manszabi/bazsi-router-reboot/bazsi_router_reboot.ino

#include <Arduino.h>
#include <WiFi.h>
// A HTTP kliens, az ICMP ping es a webszerver mar a moduloke (netprobe,
// webportal) - a fomodul nem hivja oket kozvetlenul. Az Arduino a KONYVTARAKAT
// tovabbra is megtalalja: a sketch mappa MINDEN fajljanak includejait vegignezi,
// es ezek a modulokban ott allnak.
#include <string.h>
#include "LittleFS.h"
#include "esp_sleep.h"
#include "esp_idf_version.h"
#include "esp_task_wdt.h"
#include "esp_system.h"
#include "esp_attr.h"
// Az esp_timer_get_time()-ot a core is expliciten includeolja (esp32-hal-misc.c),
// nem hagyatkozik a FreeRTOS fejlecek atteteles behuzasara. Mi sem tesszuk.
#include "esp_timer.h"
#include <time.h>
// A rele labanak rogzitese deep sleep idejere: gpio_hold_en() +
// gpio_deep_sleep_hold_en(). A C3-on a digitalis padek (GPIO6-21) holdjat csak
// ez a paros tartja meg alvas alatt (driver/gpio.h, a gpio_hold_en 3. megj.).
#include "driver/gpio.h"

// A sajat modulok. Amit ezek a headerek nem hirdetnek meg, az a modulokon
// kivulrol nem elerheto - ezt mar a fordito kenyszeriti ki, nem a fegyelem.
#include "limits_config.h"
#include "sync.h"
#include "eventlog.h"
#include "configstore.h"
#include "webportal.h"
#include "strutil.h"
#include "secret.h"
#include "app_hooks.h"
#include "netprobe.h"


// Az IPAddress a core 3.x-ben ~28 bájt (16 bájtos unió + típus + zóna + vptr),
// ezért egyik sem globális: mind ott jön létre, ahol használjuk.

// Strapping labak a C3-on: GPIO2, GPIO8, GPIO9 (datasheet, Boot Configurations).
// Set LED GPIO, relay state
constexpr uint8_t ledPin = D4;
// wifi ok led
constexpr uint8_t wifiledPin = D3;
// Set RELAY pin, to router
//
// HARDVER: D10 = GPIO10, KULSO 22k LEHUZO ELLENALLASSAL a GND fele.
// A korabbi D5 = GPIO7 bekotes nem volt stabil. Amit a D10 ad:
//   - nem strapping lab (a C3-on GPIO2, GPIO8, GPIO9 az), tehat a reset
//     alatti szintje a bootot nem befolyasolja;
//   - tovabbra is a digitalis pad tartomanyban (GPIO6-21) van, igy az alvas
//     alatti rogziteshez ugyanaz a gpio_hold_en() + gpio_deep_sleep_hold_en()
//     paros kell, mint eddig (lasd holdRelayForSleep()).
// A 22k lehuzo NEM elhagyhato: a hold a bekapcsolas es a program indulasa
// kozti ablakban meg nem el, addig a pad nagyimpedanciasan lebegne.
constexpr uint8_t relayPin = D10;
// Set reset pin, esp wifireset pin
//
// FIGYELEM (hardver): a D0 = GPIO2 strapping lab! A chip-reset alatti
// mintavetelnel GPIO2=1 kell mind az SPI boothoz, mind a letoltesi modhoz -
// bekapcsolas/reset KOZBEN nyomva tartott (vagy beragadt) wifireset gombnal
// az eszkoz el sem indul. Ez ellen szoftver nem vedhet: a handleStuckButton()
// csak a mar elindult programbol mukodik, es a beragadt gomb 60 mp-es
// alvas-ebredes kore is chip-resettel ebred, azaz ujra a lenyomott gombot
// mintavetelezne. Uj hardver reviziora a gombot szabad, nem-strapping labra
// erdemes tenni (pl. D2 = GPIO4, ami raadasul RTC-kepes is); a jelenlegi
// bekotesnel a szabaly annyi: bekapcsolas kozben ne legyen nyomva.
constexpr uint8_t wifiresetPin = D0;
// Set reset pin, esp reset/wakeup pin
constexpr uint8_t resetPin = D1;

// Timer variables
// Egy csatlakozasi proba felso hatarideje. A nev korabban egyszeruen
// "interval" volt - a program legtobbet mondo nevu konstansai kozott
// (RESET_DELAY, PROBE_DELAY, ONLINE_PROBE_INTERVAL_MS...) ez semmit nem mondott,
// pedig a fajlban KULON KOMMENT figyelmeztet arra, hogy az "interval"-szeru
// neveket konnyu osszekeverni.
constexpr uint32_t WIFI_CONNECT_TIMEOUT_MS = 20 * 1000;
constexpr uint32_t SUCCESS_DELAY = 1 * 60 * 1000;
// Szünet KÉT BUKOTT internetteszt között (az eszkaláció üteme). Ne keverd az
// ONLINE_PROBE_INTERVAL_MS-sel: az a hosszú VÁRAKOZÁSOK korai lezárásának
// üteme, és teljesen más állapotokban fut.
constexpr uint32_t PROBE_DELAY = 12 * 1000;
constexpr uint32_t RESET_DELAY = 10 * 60 * 1000;
constexpr uint32_t RESET_PULSE = 90 * 1000;
constexpr uint32_t firstStartDelay = 10 * 60 * 1000;
// A reset ESEMÉNY számláló határa. A számláló még a reset ELŐTT nő, ezért
// 4 tényleges router újraindítás után következik az egy órás alvás.
constexpr uint8_t maxfailureEvents = 5;
// Egységes Wi-Fi újrapróbálkozási politika MINDEN ágon: 3 próba, köztük 30 mp.
constexpr uint8_t wifi_maxRetries = 3;
constexpr uint32_t wifiInterval = 30 * 1000;
// (Az AP beallito mod tetlensegi ideje - AP_TIMEOUT_MS - a webportal.h-ban
// all, a portal tobbi parameterevel egyutt.)

// Meddig próbálkozzunk, ha a hálózat egyszerűen nincs ott? Egy kör:
//    10,0 perc  firstStartDelay várakozás
//   + 2,0 perc  3 csatlakozási próba (3 x 20 mp timeout + 2 x 30 mp szünet)
//   + 1,5 perc  router áramtalanítás (RESET_PULSE)
//  + 10,0 perc  várakozás a router bootolására (RESET_DELAY)
//   + 2,0 perc  újabb 3 csatlakozási próba
//  + 60,0 perc  deep sleep
//  = 85,5 perc  (de csak akkor, ha a kör alvással ZÁRUL)
// Az UTOLSO kör nem alszik: a wifiGiveUp() előbb növel, aztán ellenőriz, tehát
// a 33.-nál már AP módba megy. A tényleges türelem ezért
//   33 x 25,5 + 32 x 60 = 2761,5 perc = 46,0 óra,
// nem 33 x 85,5. Két napon belül marad, sőt tartalékkal: 34 kör is csak
// 47,5 óra lenne. Ha ennyi idő alatt sem jön vissza a net, az már nem az
// eszköz dolga. Mérve: R8.
constexpr uint32_t MAX_RETRY_ROUNDS = 33;
constexpr uint32_t BUTTON_DEBOUNCE_MS = 50;
// Gombok mintavételi köze. 10 ms bőven elég az 50 ms-os debounce-hoz, viszont
// delay()-jel várunk, nem yield()-del, így a CPU nem pörög üresen.
constexpr uint32_t BUTTON_POLL_MS = 10;
// Végzetes hiba jelzése: mindkét LED együtt, gyorsan villog (5 Hz).
constexpr uint32_t FATAL_BLINK_MS = 100;
// Ennyi hibajelzés után az ESP elalszik. Időzített ébresztés NÉLKÜL: csak a
// reset gomb vagy az áramtalanítás hozza vissza.
constexpr uint32_t FATAL_SLEEP_AFTER_MS = 5 * 60 * 1000;
// Beragadt gomb jelzése elalvás előtt: a két LED FELVÁLTVA villog, hogy meg
// lehessen különböztetni a végzetes hibától, ahol EGYÜTT villognak.
constexpr uint32_t STUCK_BLINK_MS = 3000;
// AP beállító mód: a Wi-Fi LED villog 1 Hz-cel, a státusz LED végig VILÁGÍT.
// Lassabb a végzetes hiba 5 Hz-énél, hogy össze ne lehessen téveszteni vele.
constexpr uint32_t AP_BLINK_MS = 500;
// Router reset pulzus: a státusz LED villog 2 Hz-cel, a Wi-Fi LED KI marad
// (a router áram nélkül van, kapcsolat sincs). A két villogó jelzés így a
// villogó LED-ről és a sebességről is megkülönböztethető.
constexpr uint32_t RESET_BLINK_MS = 250;
// Watchdog timeout. Nagyobb kell, mint a leghosszabb olyan blokkolás, amit NEM
// tudunk etetni - ez a http.GET(). A rossz eset NEM a szerver hallgatasa
// (5 mp connect + 10 mp valasz = 15 mp), hanem a HALOTT DNS, mert a
// nevfeloldas a connect timeouton KIVUL esik:
//   NetworkClient::connect(host,...) eloszor Network.hostByName()-t hiv, es
//   annak nincs timeout parametere (NetworkClient.cpp:310-315).
//   Egy lwIP DNS lekerdezes szervereenkent ~7 mp alatt adja fel
//   (DNS_MAX_RETRIES=4, DNS_TMR_INTERVAL=1000 ms, a tmr 1,1,2,3 lepesekben nő
//   -> 7 tick), DHCP-tol jellemzoen 2 szerver jon.
//   Ha van globalis IPv6 cim, a hostByName KETSZER kerdez (eloszor csak
//   AF_INET6-ot, aztan AF_UNSPEC-et; NetworkManager.cpp) -> 2 x 14 mp.
//   A lwip_getaddrinfo hibaja pozitiv EAI_* kod (netdb.h: 200-210), amit a
//   NetworkClient::connect igazkent lat, ezert meg egy 0.0.0.0-ra iranyulo
//   connect is lefut a maga 5 mp-evel.
// Realis legrosszabb eset: 2 x (2 x 7) + 5 = 33 mp. A 90 mp igy ~2,7-szeres
// tartalekot ad. (Meresi keretben: WD13.)
constexpr uint32_t WDT_TIMEOUT_MS = 90 * 1000;
// Ennyi watchdog/panic miatti újraindulás után az eszközt instabilnak
// tekintjük, és ugyanúgy leállunk, mint a többi végzetes hibánál.
constexpr uint32_t MAX_WDT_RESETS = 3;
// Ennyi ideig tartó hibátlan működés után a számláló nullázódik.
constexpr uint32_t WDT_COUNTER_CLEAR_MS = 60 * 60 * 1000;

constexpr uint64_t SLEEP_DURATION_US = 3600ULL * 1000000ULL;      // 1 óra
constexpr uint64_t STUCK_BUTTON_SLEEP_US = 60ULL * 1000000ULL;    // 60 másodperc

// Ennyi ideig várunk a beragadtnak látszó gomb ELENGEDÉSÉRE, mielőtt tényleg
// beragadásnak minősítenénk.
//
// MIÉRT KELL EZ? A reset gomb LOW SZINTRE ébreszt az alvásból, tehát a
// felhasználó szükségképpen MÉG NYOMVA TARTJA, amikor az eszköz bootolni kezd.
// Minden gombos ébredés ilyen. Ha a setup() egyetlen pillanatnyi digitalRead()
// alapján döntene, egy teljesen normális, fél-egy másodperces gombnyomás
// "beragadásnak" minősülne, és az eszköz azonnal visszaaludna 60 mp-re - a
// felhasználó szemszögéből "a gomb nem csinál semmit", pedig épp ő nyomta meg.
//
// Mérve (SH3): a döntés régen a Serial.begin() utáni várakozás hosszától
// függött, ami viszont attól, hogy VAN-E USB GAZDA. Bedugott USB-vel a határ
// ~600 ms volt (egy szándékos gombnyomás bőven fölé megy), USB nélkül ~3,5 mp.
// Vagyis ugyanaz a gombnyomás máshogy sült el aszerint, hogy be van-e dugva a
// kábel. Ez a konstans a küszöböt kimondottá és a kábeltől függetlenné teszi.
//
// A hosszát nem kell finomhangolni: egy TÉNYLEG beragadt gomb sosem enged el,
// tehát a 3 mp csak annyit késleltet, ami után úgyis a 60 mp-es alvás jön.
constexpr uint32_t STUCK_BUTTON_CONFIRM_MS = 3000;


// --- Heap felugyelet -------------------------------------------------------
//
// MIERT KELL? A sketch SAJAT KODJA nem allokal dinamikusan (a make lint ezt ki
// is kenyszeriti), a heapet viszont az ESPAsyncWebServer / AsyncTCP /
// HTTPClient / Wi-Fi driver erdemben hasznalja. Es a hataron sincs nulla: par
// konyvtari hivas, amit MI teszunk, String-et ad vissza ertek szerint
// (http.begin, http.header, WiFi.SSID) - rovid eletu, de valos foglalasok. Egy lassu
// szivargas vagy elaprozodas honapokig eszrevetlen marad, aztan egy nap az
// eszkoz "csak ugy" nem mukodik - allokacios hiba eseten a legtobb konyvtar
// csendben elbukik, nem panikol. Ezert merunk, kiirunk, es vegso esetben
// magunktol ujraindulunk, MIELOTT barmi elromlana.
constexpr uint32_t HEAP_CHECK_INTERVAL_MS = 10 * 1000;        // mintaveteli koz
constexpr uint32_t HEAP_LOG_INTERVAL_MS   = 30 * 60 * 1000;   // rendszeres sor

// A KET KUSZOB. A C3-on Wi-Fi + webszerver mellett a tipikus szabad heap
// 120-200 KB. A Wi-Fi driver es az AsyncTCP egyszerre tobb KB-os tomboket is
// ker, ezert nem a nulla a veszelyes hatar, hanem az a szint, ahol egy
// szokasos foglalas mar elbukhat.
constexpr uint32_t HEAP_WARN_BYTES  = 25000;   // figyelmeztetes (naplo + soros)
constexpr uint32_t HEAP_CRIT_BYTES  = 12000;   // ujrainditas

// ELAPROZODAS. Lehet 30 KB szabad heap ugy, hogy a legnagyobb OSSZEFUGGO tomb
// csak 4 KB - ilyenkor a szabad heap onmagaban megnyugtato, kozben a
// foglalasok mar buknak. Ezert a legnagyobb tombot kulon is nezzuk.
constexpr uint32_t HEAP_CRIT_BLOCK_BYTES = 6000;

// A kritikus szintnek KI KELL TARTANIA. Egy pillanatnyi melypont (egy epp
// futo HTTP keres, egy nagyobb valasz osszeallitasa) nem szivargas. Harom
// egymas utani minta = 30 masodperc.
constexpr uint8_t HEAP_CRIT_SAMPLES = 3;

// Es a heap miatti ujrainditasnak is van felso hatara: ha az ujraindulas sem
// segit (tartos elaprozodas, valodi szivargas mar indulaskor), a boot loop
// rosszabb, mint a megallas. Ugyanaz a politika, mint a watchdognal.
constexpr uint32_t MAX_HEAP_RESTARTS = 3;

// A hosszú várakozások (firstStartDelay, RESET_DELAY) korai lezárása.
//
// Mindkét várakozás arra való, hogy a router bootolására időt hagyjunk - de ha
// a router hamarabb feláll, felesleges a maradékot kivárni. Ennyi időnként
// megnézzük, hogy visszajött-e a hálózat ÉS az internet; ha mindkettő megvan,
// a várakozás azonnal véget ér. A próba ISMÉTLŐDIK, tehát elég, ha a kapcsolat
// a várakozás BÁRMELY pontján helyreáll: a kilépés az azt követő ütemben
// megtörténik. A teljes időt csak akkor várjuk ki, ha végig nincs meg.
//
// MIÉRT 60 mp? Egy router bootolása 1-3 perc, tehát ennél sűrűbb kérdezés nem
// hozna érdemben korábbi kilépést, viszont rádiózna. Egy 10 perces várakozás
// alatt így legfeljebb 10 próba fut - és mivel a Wi-Fi újracsatlakozás a
// WiFi.persistent(false) mellett NEM ír NVS-t, ez a flasht sem terheli.
constexpr uint32_t ONLINE_PROBE_INTERVAL_MS = 60 * 1000;
// A korai kilépés ping célpontja: fix IP, hogy a névfeloldás ne számítson -
// itt csak azt kérdezzük, van-e út kifelé. (Cloudflare.) Az IPAddress ~28
// bájt és virtuális, ezért itt csak a négy oktett él, a cím a hívás helyén
// jön létre.
constexpr uint8_t PROBE_PING_IP[4] = { 1, 1, 1, 1 };

// A teszt parameterek (PING_*, HTTP_*) a netprobe.h-ban allnak, a
// mereseikkel egy helyen.
// A legmagasabb letezo ciklus index: ot vegpont van, 0..4. A FAILURE_STATE
// mar 4-nel resetel, tehat a plafon a gyakorlatban nem is kot - de ez az a
// szam, ameddig az indexnek egyaltalan ertelme van, es a leptetes ezt mondja ki.
constexpr uint8_t MAX_CYCLE_INDEX = 4;

// AZ OT TESZT-VEGPONT, INDEX SZERINT.
//
// MIERT TABLAZAT, ES NEM if-lanc? Ket okbol:
//
//  1. A 0-s index az if-lancban az ELSE agra esett, tehat a lista "elso" eleme
//     a szerkezet VEGEN allt. A tablazat ugyanabban a sorrendben olvashato,
//     mint amit a soros port es a /log oldal 1-alapon szamoz.
//
//  2. SEMMI nem kotote ossze a vegpontok SZAMAT a MAX_CYCLE_INDEX-szel. Ha
//     valaki a plafont 5-re emelne, az if-lanc az 5-os indexnel CSENDBEN
//     ujra a msftconnecttest-et probalta volna (az else ag) - vagyis egy
//     uzemelteto ketszer szerepelt volna, es epp az a garancia veszett volna
//     el, amiert ot kulonbozo vegpont van: "egyetlen uzemelteto kiesese soha
//     ne latszodjon internetkimaradasnak". A lenti static_assert ezt mar
//     FORDITASI IDOBEN megfogja.
//
// Az index ervenyessege szerkezetileg biztositott: a runFailureState() csak
// MAX_CYCLE_INDEX-ig lepteti, a Wi-Fi-vesztes aga pedig RESET_TRIGGER_CYCLE+1
// (= 4) erteket ad - mindketto a tablazaton belul marad.
struct TestEndpoint {
  const char* url;
  const char* expect;   // ures = 204 (No Content) ellenorzes, lasd testInternetHTTP()
};
constexpr TestEndpoint TEST_ENDPOINTS[] = {
  { "http://www.msftconnecttest.com/connecttest.txt",    "Microsoft Connect Test"   },
  { "http://cp.cloudflare.com/generate_204",             ""                         },
  { "http://detectportal.firefox.com/success.txt",       "success"                  },
  { "http://nmcheck.gnome.org/check_network_status.txt", "NetworkManager is online" },
  { "http://connectivitycheck.gstatic.com/generate_204", ""                         },
};
static_assert(sizeof(TEST_ENDPOINTS) / sizeof(TEST_ENDPOINTS[0]) == MAX_CYCLE_INDEX + 1,
              "minden ciklus-indexhez PONTOSAN egy vegpont tartozzon");
// A reset kuszobe: az index 3 UTAN, vagyis a 4-es indexu teszt (Google) bukasa
// utan indul a router ujrainditas. Lasd a FAILURE_STATE-et.
constexpr uint8_t RESET_TRIGGER_CYCLE = 3;

struct TestState {
  uint8_t cycleIndex = 0;   // melyik végpont jön; 0..MAX_CYCLE_INDEX
  uint8_t failedCount = 0;  // egymás utáni sikertelen tesztek
  uint8_t resetEvents = 0;  // hány router újraindítás volt ebben a sorozatban
  uint8_t resetStep = 0;    // 0 = tétlen, 1 = fut a reset pulzus
};

struct TimingState {
  uint32_t stateStart = 0;             // állapotgép: aktuális állapot kezdete
  uint32_t resetPulseStart = 0;        // relé kikapcsolás kezdete
  uint32_t startMillis = 0;            // setup() időbélyege
  uint32_t resetBtnDownSince = 0;      // debounce: mióta LOW a reset gomb
  uint32_t wifiResetBtnDownSince = 0;  // debounce: mióta LOW a wifireset gomb
  uint32_t blinkLast = 0;              // hibajelző villogás
  uint32_t fatalStart = 0;             // mióta tart a hibajelzés
};

struct UIFlags {
  // "Printed" jelzők: a loop() másodpercenként sokszor fut, ezek gondoskodnak
  // róla, hogy egy állapotváltás üzenete csak EGYSZER menjen ki a soros portra.
  bool successPrinted = false;
  bool resetPrinted = false;
  bool firstStartPrinted = false;
  bool firstStart = true;          // tart-e még az indulás utáni türelmi idő
  bool blinkOn = false;            // hibajelző LED állapot
};

TestState testState;
TimingState timing;
UIFlags uiFlags;

enum State : uint8_t {
  TESTING_STATE = 0,
  FAILURE_STATE = 1,
  SUCCESS_STATE = 2
};

// Az eszköz vagy a routert figyeli, vagy a Wi-Fi beállító portált szolgálja ki.
enum DeviceMode : uint8_t {
  MODE_MONITOR = 0,
  MODE_CONFIG = 1,
  MODE_FATAL = 2  // a konfiguráció nem tölthető be: a program nem fut tovább
};


State currentState = TESTING_STATE;
DeviceMode deviceMode = MODE_MONITOR;


// Statikus IP konfigurációval megyünk-e? Csak akkor igaz, ha a WiFi.config()
// ténylegesen sikerült. DHCP-nél a gateway magától a routertől jött, tehát
// definíció szerint helyes - ott nincs mit ellenőrizni.
bool staticConfigActive = false;

// MEGSZAKITAS-ALAPU GOMBRETESZ
//
// MIERT KELL? A gombokat a sajat varakozo ciklusaink 10 ms-onkent nezik - de
// egy futo HTTP teszt alatt nem tudjak: a http.GET() a core blokkolo hivasa,
// nincs benne visszahivas. Ez az ablak halott DNS mellett 33 masodperc (merve:
// BTN2), es egy rovid koppintas nyom nelkul elveszett benne, mert a lab
// allapotat csak mintavetelkor olvastuk.
//
// A MEGOLDAS NEM az, hogy a megszakitas azonnal cselekszik - az kikerulne a
// debounce-t, es egy zajtuske ujrainditana az eszkozt (lasd B1 teszt). Ehelyett
// a megszakitas MEGMERI a lenyomas hosszat: a lefuto elen jegyzi az idot, a
// felfuton pedig csak akkor reteszel, ha a gomb legalabb BUTTON_DEBOUNCE_MS-ig
// lent volt. Igy a debounce ugyanaz marad, csak hardveresen tortenik - es
// akkor is mukodik, amikor a loop epp nem tud mintavetelezni.
//
// A retesz nem kerul meg semmi mast: a savingConfig kaput es a konfigzarat a
// feldolgozas ugyanugy tiszteletben tartja, tehat egy blokkolo szakasz alatt
// erkezett gombnyomas csak KESIK, de nem vagja felbe a fajlirast.
volatile bool btnResetLatched = false;
volatile bool btnWifiResetLatched = false;
volatile uint32_t btnResetDownAt = 0;
volatile uint32_t btnWifiResetDownAt = 0;

// A korai kilépés próbáinak sebességkorlátozó órái. Nem a TimingState-ben
// vannak, mert az a struct a valódi állapotgép idejeit tartja; ez csak
// "mikor pingettünk utoljára". Kettő kell belőlük: a két várakozás egymás
// után is lefuthat ugyanabban a körben.
uint32_t resetDelayProbeLast = 0;   // FAILURE_STATE, RESET_DELAY
uint32_t firstStartProbeLast = 0;   // handleFirstStart(), firstStartDelay

// A heap felugyelet orai es jelzoi. SZANDEKOSAN fajl-szintu globalisok, nem
// fuggveny-szintu static-ok: a sketch tobbi per-boot allapota (resetDelayProbeLast,
// firstStartProbeLast, testState, timing) is igy all, es a teszt-harness
// hidegindulasa (coldBoot) igy tudja mindet egy helyen visszaallitani. Egy
// rejtett static ugyanezt a szerepet toltene be a valos eszkozon, de a
// forgatokonyvek kozott atszivarogna.
uint32_t heapCheckLast = 0;    // az utolso meres ideje
uint32_t heapLogLast = 0;      // az utolso rendszeres allapotsor ideje
uint8_t  heapCritStreak = 0;   // hany egymas utani kritikus meres volt
bool     heapWarnActive = false;  // szol-e eppen a figyelmeztetes

// Fut-e már a watchdog. Az initWatchdog() a setup() elején fut, de EL IS
// BUKHAT (kikapcsolt TWDT, sikertelen feliratkozás) - és ilyenkor szándékosan
// le is iratkozunk. Feliratkozás nélkül a feedLoopWDT() ESP_ERR_NOT_FOUND-ot
// kapna ("task not found"), amire a core log_e()-t hív: bekapcsolt debug log
// mellett ez 10 ms-onként egy hibasor a soros porton. Ezért etet minden
// feedWatchdog() csak ezen a kapcsolón keresztül.
bool watchdogEnabled = false;

// Watchdog/panic miatti újraindulások számlálója.
// FONTOS: itt RTC_NOINIT_ATTR kell, nem RTC_DATA_ATTR! Az utóbbi csak a deep
// sleepet éli túl, egy watchdog reset ujrainicializalna - épp azt veszítenénk
// el, amit számolni akarunk. A NOINIT viszont bekapcsoláskor határozatlan
// tartalmú, ezért magic értékkel ellenőrizzük az érvényességét.
constexpr uint32_t WDT_COUNTER_MAGIC = 0x42415A53UL;  // "BAZS"
RTC_NOINIT_ATTR uint32_t rtcWdtMagic;
RTC_NOINIT_ATTR uint32_t rtcWdtResets;

// Hány újrapróbálkozási kört tudtunk le eddig. RTC_DATA_ATTR (nem NOINIT):
// a deep sleepet túléli, de bekapcsoláskor és reset gombra nullázódik - a
// felhasználói beavatkozás tiszta 2 napos ablakkal indít.
RTC_DATA_ATTR uint32_t rtcRetryRounds = 0;

// A diagnosztikai lap szamlaloi egy egeszkent (app_hooks.h). A szamlalok itt
// maradnak, mert a watchdog-politika es az ujraprobalkozasi ablak a fomodul
// dontesei - a portal csak megjeleniti oket.
DiagCounters diagCounters() {
  return DiagCounters{ rtcWdtResets, MAX_WDT_RESETS, rtcRetryRounds, MAX_RETRY_ROUNDS };
}

// --- A heap miatti ujraindulas atvitele ------------------------------------
//
// MIT KELL ATVINNI? Egy ESP.restart() a RAM-ot torli, tehat minden sima
// globalis elveszik: testState, timing, uiFlags. A tobbsegukert nem kar - a
// timing ujraszamolodik, a firstStart varakozas ujra lefut (es a proba
// perceken belul le is zarja), a cycleIndex/failedCount pedig csak azt
// mondja meg, hol tart az OT teszt kozott.
//
// EGY kivetel van, es annal az elvesztes VISELKEDESI hibat okozna: a
// testState.resetEvents. Ez szamolja, hanyszor indítottuk mar ujra a routert
// ebben a sorozatban, es ez viszi el az eszkozt az otodiknel az 1 oras
// alvasba (internetFailSleep). Ha egy heap-ujraindulas ezt nullazna, a
// szamlalo mindig elolrol kezdene, es az eszkoz VEGTELENUL ujraindithatna a
// routert ahelyett, hogy elalszik. Ezert ezt az egyet atvisszuk.
//
// A 0xFF a "nincs atvitel" jelolese: a setup() egyszer felhasznalja, majd
// vissza is allitja, hogy egy KESOBBI, mas okbol tortent ujraindulas (gomb,
// watchdog) ne allitson vissza elavult erteket.
constexpr uint32_t HEAP_MAGIC = 0x42415A48UL;   // "BAZH"
constexpr uint8_t  CARRY_NONE = 0xFF;
RTC_NOINIT_ATTR uint32_t rtcHeapMagic;
RTC_NOINIT_ATTR uint32_t rtcHeapRestarts;      // egymast koveto heap-ujrainditasok
RTC_NOINIT_ATTR uint8_t  rtcCarryResetEvents;  // atvitt resetEvents (CARRY_NONE = nincs)
// ...es a 2 napos ablak szamlaloja. MIERT KELL EZ IS ATVINNI?
//
// Az rtcRetryRounds SZANDEKOSAN RTC_DATA_ATTR: a deep sleepet tuleli, de
// bekapcsolaskor ES SZOFTVERES RESETRE nullazodik - "a felhasznaloi
// beavatkozas tiszta 2 napos ablakkal indit". A gombnyomasra ez helyes.
//
// A heap miatti ujraindulas viszont NEM felhasznaloi beavatkozas, hanem a sajat
// dontesunk - megis ugyanolyan szoftveres reset, tehat ugyanugy nullazna a
// szamlalot. Az eszkoz igy SOHA nem erne el a 2 napos hatarra, vagyis sosem
// menne AP beallito modba: orokke ujraprobalkozna, es a felhasznalo sosem
// kapna eselyt a konfiguracio javitasara. Ezert ezt is atvisszuk.
RTC_NOINIT_ATTR uint32_t rtcCarryRetryRounds;

// ---------------------------------------------------------------------------
// KET TASK, EGY MEMORIA - mi vedi a kozos allapotot?
//
// A programban ket task fut: a loop task es az AsyncTCP webszerver
// "async_tcp" taskja. Az alabbi globalisokhoz mindketto hozzafer.
//
//   restartPending / restartAt   SPINLOCK, a sync modulon at (requestRestart,
//   savingConfig                 restartRequestDue, beginConfigWrite, ...).
//                                Ez a harom valtozo a sync.cpp-ben STATIC:
//                                kozvetlenul mar nem is elerheto. Az indoklas
//                                (miert nem eleg a volatile a hatarido-jelzo
//                                parhoz) ott all, a definiciojuknal.
//   apDeadline                   volatile, zar nelkul: onallo jelentesu
//                                egyetlen igazitott szo, nincs masik
//                                valtozoval kozos invariansa.
//   rtcEvents / rtcEvNext        evLogMux kritikus szakasz mindket iranyban
//                                (eventlog modul).
//   rtcWdtResets                 az async task CSAK OLVASSA (a /log lapon, a
//   rtcRetryRounds               diagCounters()-en at), a loop irja. Igazitott
//                                szo, tehat nem szakadhat kette; a lapon
//                                legfeljebb egy pillanattal regi ertek all -
//                                diagnosztikai kijelzon ez nem szamit.
//   ssid/pass/ipStr/gatewayStr   lasd alabb: SZERKEZETI invarians vedi.
//
// A NEGY KONFIGURACIOS PUFFERT az async task IRJA (a POST kezelo 2. fazisa),
// a loop task pedig OLVASSA - a WiFi.begin() hivasaiban. Ezt NEM zar vedi,
// hanem egy szerkezeti invarians:
//
//   Az initWiFi() es az onlineProbe() CSAK olyan helyekrol fut, ahol a
//   beallito portal nem letezik.
//
// Miert all ez? A portalt egyedul a startConfigPortal() inditja, az pedig
// deviceMode = MODE_CONFIG-ot allit, es a startWebPortal() az UTOLSO sora. A
// loop() a MODE_CONFIG (es a MODE_FATAL) againak elejen visszater - egyik ag
// sem er el sem initWiFi()-ig, sem onlineProbe()-ig. Visszafele ut nincs:
// MODE_CONFIG-bol csak ujraindulassal vagy MODE_FATAL-ba lehet kilepni, es
// MODE_MONITOR-ba egyik sem vezet vissza. A setup() ket MODE_MONITOR
// ertekadasa a portal letrejotte ELOTT van.
//
// Ket kezelo egymassal sem versenyez: az ESPAsyncWebServer MINDEN kezelot
// ugyanazon az async_tcp taskon, sorosan hiv - tehat a GET urlap (ami olvassa
// az ssid-t) es a POST (ami irja) sem futhat egyszerre.
//
// HA EZ VALAHA MEGVALTOZNA - barmi, ami a portal futasa kozben hivna
// initWiFi()-t vagy onlineProbe()-ot -, a negy puffert zar ala kell tenni.
// (Merve: CC1, CC2.)
// ---------------------------------------------------------------------------


// Forward declarations (a .ino auto-prototípusok helyett explicit módon)
void printUptime();
void resetbutton();
void wifiresetbutton();
void armButtonLatches();
void restartFromButton(const char* reason);
void doWifiReset();
void blockingDelay(uint32_t duration);
void waitWithButtons(uint32_t duration);
bool waitWithButtonsUntilOnline(uint32_t duration);
bool onlineProbe();
bool onlineProbeDue(uint32_t& lastProbe, uint32_t now);
void lockConfigBeforeShutdown();
void internetFailSleep();
void fatalSleep();
void apSleep();
void feedWatchdog();
void wifiGiveUp();
bool routerResetAndRetry();
bool wifiAuthFailed();
bool reset_device();
void startConfigPortal();
void enterFatal(const char* reason);
void fatalHalt(const char* reason);
void enterDeepSleep(uint64_t timerUs);
void holdRelayForSleep();
int pressedButtonNow();
void checkHeap(uint32_t now);
void initHeapState();
void applyHeapCarry();
bool initWiFi();
bool reconnectWifi();
bool gatewayUnreachable();


// Végzetes hiba: a konfiguráció nem tölthető be. Ilyenkor a program nem fut
// tovább (nincs teszt, nincs relé kapcsolás, nincs elalvás), csak jelez.
void enterFatal(const char* reason) {
  deviceMode = MODE_FATAL;
  timing.fatalStart = millis();
  timing.blinkLast = timing.fatalStart;
  digitalWrite(relayPin, LOW);  // a router mindenképp kapjon áramot
  Serial.println();
  Serial.println("!!! VEGZETES HIBA !!!");
  Serial.println(reason);
  Serial.println("A program leallt, mindket LED gyorsan villog.");
  Serial.println("Reset gomb: ujraindítas. Wifireset gomb: mentett adatok torlese.");
  Serial.print(FATAL_SLEEP_AFTER_MS / 60000);
  Serial.println(" perc mulva az eszkoz elalszik (magatol nem ebred fel).");
}


// A heap allapot RTC blokkjanak felelesztese. Ugyanaz a minta, mint a
// watchdog szamlalonal: bekapcsolas utan a NOINIT terulet tartalma szemet.
void initHeapState() {
  if (rtcHeapMagic != HEAP_MAGIC) {
    rtcHeapMagic = HEAP_MAGIC;
    rtcHeapRestarts = 0;
    rtcCarryResetEvents = CARRY_NONE;
    rtcCarryRetryRounds = 0;
  }
}

// Az atvitt allapot FELHASZNALASA - pontosan egyszer. A visszaallitas utan a
// jelolot toroljuk, kulonben egy kesobbi, mas okbol tortent ujraindulas
// (gombnyomas, watchdog) egy regi resetEvents erteket tamasztana fel.
void applyHeapCarry() {
  if (rtcCarryResetEvents == CARRY_NONE) {
    return;
  }
  testState.resetEvents = rtcCarryResetEvents;
  // A 2 napos ablak szamlaloja: a sajat ujraindulasunk NE nullazza. A
  // rtcCarryResetEvents egyben az ervenyesseg jelzoje is, tehat a kettot
  // egyutt irjuk es egyutt is hasznaljuk fel.
  rtcRetryRounds = rtcCarryRetryRounds;
  rtcCarryResetEvents = CARRY_NONE;
  printUptime();
  Serial.print("Heap miatti ujraindulas utan folytatjuk: router reset szamlalo = ");
  Serial.print(testState.resetEvents);
  Serial.print(" / ");
  Serial.print(maxfailureEvents);
  Serial.print(", ujraprobalkozasi kor = ");
  Serial.print(rtcRetryRounds);
  Serial.print(" / ");
  Serial.println(MAX_RETRY_ROUNDS);
}

// A heap allapotanak nyomon kovetese: mereskovetes, ritkitott soros kiiras, es
// vegso esetben onkentes ujraindulas.
//
// A KIIRAS RITKITASA. A meres 10 mp-enkent fut, a rendszeres allapotsor
// viszont csak felorankent - ez 0,03 sor/perc, vagyis a 30 sor/perces
// koltsegvetesbol semmit nem visz el. A figyelmeztetes ezen felul jon, de
// csak a kuszob ATLEPESEKOR (nem minden korben) - ugyanaz a "csak a sorozat
// elso tagja" szabaly, mint a TEST FAIL / WIFI LOST eseteben.
void checkHeap(uint32_t now) {
  if (now - heapCheckLast < HEAP_CHECK_INTERVAL_MS) {
    return;
  }
  heapCheckLast = now;

  const uint32_t szabad = ESP.getFreeHeap();
  const uint32_t tomb   = ESP.getMaxAllocHeap();

  // Rendszeres allapotsor. A HARMADIK ertek (a valaha volt legkisebb) a
  // legfontosabb: egy lassu szivargas ebbol latszik meg akkor is, ha a
  // pillanatnyi ertek epp rendben van.
  if (now - heapLogLast >= HEAP_LOG_INTERVAL_MS) {
    heapLogLast = now;
    printUptime();
    Serial.printf("Heap: szabad %u B, legnagyobb tomb %u B, valaha volt legkisebb %u B\n",
                  (unsigned)szabad, (unsigned)tomb, (unsigned)ESP.getMinFreeHeap());
  }

  // Figyelmeztetes - csak az ATLEPESKOR. A heapWarnActive jelzo tartja szamon,
  // hogy a figyelmeztetes mar szol-e; visszaallni is csak akkor lehet, ha a
  // heap ERDEMBEN (10%-kal) a kuszob fole ment, hogy a kuszob korul
  // ingadozva ne kapcsolgasson oda-vissza.
  if (!heapWarnActive && szabad < HEAP_WARN_BYTES) {
    heapWarnActive = true;
    // A NAPLOBA csak akkor, ha nem ez volt mar az elozo bejegyzes is.
    //
    // MIERT KELL EZ? A heapWarnActive jelzo a SOROS sort ritkitja (10%-os
    // hiszterezissel), de a naplo bejegyzes ugyanezen a jelzon lovagolt -
    // tehat MINDEN atlepes uj bejegyzest irt. Egy kuszob korul ingadozo
    // heapnel (amit a szokasos AsyncTCP puffer-forgalom eloallithat) ez
    // kisopri a 32 elemu korpuffert: merve 30 perc alatt 32 bejegyzes, mind
    // egymas utan - vagyis epp azokat az esemenyeket veszitenenk el, amiket
    // ki akarunk vizsgalni.
    //
    // Pontosan ugyanaz a hibaosztaly, mint a WIFI LOST-nal, es ugyanaz a
    // megoldas is. (Merve: HP10.)
    if (!lastEventWas((uint8_t)EV_LOW_HEAP)) {
      logEvent(EV_LOW_HEAP, (uint16_t)(szabad / 1024));
    }
    printUptime();
    Serial.printf("FIGYELEM: alacsony a szabad heap (%u B), a kuszob %u B.\n",
                  (unsigned)szabad, (unsigned)HEAP_WARN_BYTES);
  } else if (heapWarnActive && szabad > HEAP_WARN_BYTES + HEAP_WARN_BYTES / 10) {
    heapWarnActive = false;
    printUptime();
    Serial.printf("A szabad heap visszaallt (%u B).\n", (unsigned)szabad);
  }

  // Kritikus szint. KI KELL TARTANIA: egy pillanatnyi melypont (epp futo HTTP
  // keres, osszeallitas alatt levo valasz) nem szivargas.
  const bool kritikus = (szabad < HEAP_CRIT_BYTES) || (tomb < HEAP_CRIT_BLOCK_BYTES);
  if (!kritikus) {
    heapCritStreak = 0;
    return;
  }
  // A szamlalo TELITODIK, nem no tovabb. Ez akkor szamit, ha az ujraindulas
  // epp tiltott (AP mod, fajliras, rele impulzus): ilyenkor a kritikus
  // allapot sokaig allhat, es egy korlatlanul novo uint8_t 255 utan
  // korbefordulna nullara - vagyis epp a legrosszabb pillanatban ejtene el a
  // mar kiszolgalt varakozast.
  if (heapCritStreak < HEAP_CRIT_SAMPLES) {
    heapCritStreak++;
    return;
  }

  // MIKOR NEM SZABAD UJRAINDULNI. Mind az OT kizaras arrol szol, hogy az
  // ujraindulas ne rontson tobbet, mint amennyit javit:
  //
  //  - AP beallito modban a felhasznalo epp a portalon dolgozik; az
  //    ujraindulas eldobna a beirt adatokat. Nem is maradunk igy orokre: a
  //    portal 5 perc tetlenseg utan ugyis elalszik, abbol pedig friss
  //    bootolas jon.
  //  - MODE_FATAL-ban a program mar nem fut allapotgepet, es 5 perc mulva
  //    elalszik - ott is jon a friss bootolas.
  //  - Fajliras kozben soha (ezt a zar biztositja lejjebb is).
  //  - A rele impulzusa alatt sem: a router epp aram nelkul van, es az
  //    ujraindulas felbevagna a 90 mp-es pulzust.
  //  - ES a router reset UTANI ellenorzo ablakban sem. Ez a legkevesbe
  //    nyilvanvalo kizaras, ezert reszletesen:
  //
  //    A gateway-eszkalacio KETFAZISU, es a ket fazis kozott akar 10 perc is
  //    eltelhet (RESET_DELAY):
  //      1. fazis: a sajat gateway sem elerheto -> GW UNREACH(1) naplozas,
  //         a router kap EGY eselyt: ujrainditas, majd varakozas.
  //      2. fazis: a varakozas utan UJRA ellenorizzuk. Ha a gateway meg
  //         mindig nem valaszol, a statikus IP a rossz -> AP beallito mod,
  //         hogy javitani lehessen.
  //
  //    Azt, hogy "az elso fazis mar lefutott", HAROM sima globalis egyutt
  //    hordozza: currentState == FAILURE_STATE, uiFlags.resetPrinted es
  //    timing.stateStart. Egy ujraindulas MINDHARMAT elvesziti - a
  //    timing.stateStart-ot ertelmesen nem is lehetne atvinni, mert a millis()
  //    ebredeskor nullarol indul. Az eszkoz igy ELOLROL kezdene: megint az
  //    elso fazis futna le, vagyis a router kapna MEG egy folosleges
  //    aramtalanitast, es a masodik fazis dontese - az AP modba menetel -
  //    csak egy teljes korrel kesobb szuletne meg. Epp az a felhasznalo
  //    jarna rosszul, akinek a statikus IP-jet javitani kellene.
  //
  //    Ezert itt inkabb VARUNK. Az ablak korlatos (RESET_DELAY + a
  //    visszacsatlakozas, ~13 perc), a heapCritStreak pedig telitve marad,
  //    tehat az ablak bezarultaval az ujraindulas azonnal megtortenik.
  //    (Merve: GW1, GW2.)
  const bool resetEllenorzoAblak =
      (currentState == FAILURE_STATE) && uiFlags.resetPrinted;
  if (deviceMode != MODE_MONITOR || configWriteInProgress() || restartRequested()
      || testState.resetStep != 0 || resetEllenorzoAblak) {
    return;
  }

  // Ha az ujraindulas sem segit, a boot loop rosszabb, mint a megallas.
  if (rtcHeapRestarts >= MAX_HEAP_RESTARTS) {
    logEvent(EV_FATAL, 5);
    enterFatal("Tartosan keves a szabad heap - az ujrainditas sem segitett.");
    return;
  }

  // Az ATVITEL beallitasa, MIELOTT ujraindulnank. Lasd a rtcCarryResetEvents
  // leirasat: ez az egyetlen sima globalis, aminek az elvesztese viselkedesi
  // hibat okozna.
  rtcCarryResetEvents = testState.resetEvents;
  rtcCarryRetryRounds = rtcRetryRounds;
  rtcHeapRestarts++;
  logEvent(EV_HEAP_RESTART, (uint16_t)(szabad / 1024));

  // A NAPLO KIIRASA MEG AZ UJRAINDULAS ELOTT.
  //
  // Az ESP.restart() az RTC_NOINIT teruletet NEM torli, tehat a bejegyzesek
  // enelkul sem vesznenek el - de csak a KOVETKEZO mentesi pontig (router
  // reset, alvas, AP mod) elnenek kizarolag RTC-ben. Egy aramszunet abban az
  // ablakban epp azt a bizonyitekot vinne el, amiert ez az ujraindulas
  // tortenik. Ez egy VEZERELT leallas, ugyanugy, mint az alvas - ott is
  // mentunk.
  //
  // Ha a mentes a keves heap miatt megsem sikerul, az NEM vegzetes: a
  // saveEventLog() ezt kezeli, es az RTC naplo attol meg ep. (Merve: RST1.)
  saveEventLog("heap miatti ujraindulas elott");

  printUptime();
  Serial.printf("KRITIKUS: a szabad heap %u B (legnagyobb tomb %u B) %u meresen at.\n",
                (unsigned)szabad, (unsigned)tomb, (unsigned)HEAP_CRIT_SAMPLES);
  Serial.print("Onkentes ujraindulas, sorszam: ");
  Serial.print(rtcHeapRestarts);
  Serial.print(" / ");
  Serial.println(MAX_HEAP_RESTARTS);

  // A zarat itt is ATOMIKUSAN szerezzuk meg, ugyanazert, mint minden mas
  // leallasnal: a kiirasok es az ESP.restart() kozott meg elindulhatna egy
  // mentes, amit az ujraindulas felbevagna. (Lasd lockConfigBeforeShutdown().)
  lockConfigBeforeShutdown();
  Serial.flush();
  ESP.restart();
}

// Watchdog/panic miatti újraindulások figyelése. Ha a program ismételten
// megakad, az újraindítgatás önmagában nem megoldás - inkább jelezzünk.
// SOROS PARANCSOK.
//
// MIERT KELL, HA VAN /log OLDAL? Mert az AP portal csak akkor fut, ha az
// eszkoz konfig modba kerult - egy normalisan mukodo eszkoztol viszont a
// soros kabel az egyetlen ut a naplohoz. Es a lap SZANDEKOSAN korlatos (a
// legfrissebb 48 sor, hogy az async_tcp taskban ne kelljen nagy osszefuggo
// puffert kerni); a TELJES naplot csak itt lehet megnezni.
//
// NEM BLOKKOL. Csak azt olvassuk ki, ami epp a pufferben van; egy felig
// beirt sor a kovetkezo loop() iteracioban folytatodik. Igy a watchdog-etetes
// rendje sem valtozik.
constexpr size_t CMD_BUF_LEN = 16;
static char cmdBuf[CMD_BUF_LEN];
static uint8_t cmdLen = 0;
// Tul hosszu sor: a SORVEGIG mindent eldobunk.
//
// Az elso valtozatom itt hibazott: a puffert a tulcsordulasnal nullazta, de a
// tovabbi karakterek utan UJRA gyujteni kezdett - vagyis a hosszu sor VEGEBOL
// lett egy csonkolt parancs. A szandek az volt, hogy a TELJES sor essen el.
// (Mutacioval derult ki: a "nem lesz belole csonkolt parancs" allitas a
// tiszta kodon is megbukott.)
static bool cmdOverflow = false;

static void runSerialCommand(const char* cmd) {
  if (strcasecmp(cmd, "LOG") == 0) {
    printEventLogs();
  } else if (strcasecmp(cmd, "HELP") == 0 || strcasecmp(cmd, "?") == 0) {
    Serial.println();
    Serial.println("Parancsok:");
    Serial.println("  LOG   - a teljes esemenynaplo (fajl + RTC) kiirasa");
    Serial.println("  HELP  - ez a lista");
    Serial.println();
  } else if (cmd[0] != '\0') {
    Serial.print("Ismeretlen parancs: ");
    Serial.println(cmd);
    Serial.println("Probald a HELP-et.");
  }
}

void serialCommands() {
  // A ciklus KORLATOS: csak a mar megerkezett bajtokat dolgozza fel, es
  // Serial.available() minden korben csokken. Nincs benne delay(), nem var
  // semmire - ezert nem is kell etetnie a watchdogot.
  while (Serial.available() > 0) {
    const int c = Serial.read();
    if (c < 0) {
      break;
    }
    if (c == '\n' || c == '\r') {
      if (cmdOverflow) {
        // A sor tul hosszu volt: EGESZBEN eldobjuk. Igy nem lehet belole
        // veletlenul ervenyes parancs, es a kovetkezo sor tiszta lappal indul.
        Serial.println("Tul hosszu parancs, eldobva.");
      } else if (cmdLen > 0) {
        cmdBuf[cmdLen] = '\0';
        runSerialCommand(cmdBuf);
      }
      cmdLen = 0;
      cmdOverflow = false;
    } else if (cmdLen < CMD_BUF_LEN - 1) {
      cmdBuf[cmdLen++] = (char)c;
    } else {
      // A sor tul hosszu. A DONTEST a cmdOverflow hozza meg a sorvegnel: ez a
      // jelzo az egyetlen, ami szamit. A cmdLen nullazasa csak azert van itt,
      // hogy a puffer ne maradjon felig teleirva. (Egy kulon "mar eldobjuk"
      // ag felesleges volt: mutacioval igazolva viselkedesileg azonos, es egy
      // teherhordonak LATSZO, de nem az ag rosszabb a semminel.)
      cmdOverflow = true;
      cmdLen = 0;
    }
  }
}

void checkWatchdogResets() {
  const esp_reset_reason_t reason = esp_reset_reason();

  if (rtcWdtMagic != WDT_COUNTER_MAGIC) {
    // Első indulás bekapcsolás után: a NOINIT terület tartalma szemét.
    rtcWdtMagic = WDT_COUNTER_MAGIC;
    rtcWdtResets = 0;
  }

  // Minden olyan ok, ami azt jelenti: a program hibásan viselkedett.
  const bool abnormal = (reason == ESP_RST_TASK_WDT || reason == ESP_RST_INT_WDT
                         || reason == ESP_RST_WDT || reason == ESP_RST_PANIC
                         || reason == ESP_RST_CPU_LOCKUP);

  if (abnormal) {
    rtcWdtResets++;
    logEvent(EV_WDT_RESET, (uint16_t)rtcWdtResets);
    Serial.print("Watchdog/panic miatti ujrainditas, sorszam: ");
    Serial.print(rtcWdtResets);
    Serial.print(" / ");
    Serial.println(MAX_WDT_RESETS);
    if (rtcWdtResets >= MAX_WDT_RESETS) {
      rtcWdtResets = 0;  // az alvás után tiszta lappal induljon
      logEvent(EV_FATAL, 3);
      enterFatal("Tul sok watchdog miatti ujrainditas - a program instabil.");
    }
  } else if (reason == ESP_RST_POWERON || reason == ESP_RST_EXT
             || reason == ESP_RST_BROWNOUT) {
    // TISZTA LAP: a TAPELLATAS szakadt meg, nem a program akadt meg.
    //
    // (A korabbi indoklas "emberi beavatkozas"-t mondott, ami a POWERON-ra es
    // az EXT-re igaz, a BROWNOUT-ra viszont nem: az tapfeszultseg-eses, nem
    // gombnyomas. A kozos nevezo nem az ember, hanem az, hogy a lapka
    // AZ ARAMELLATAS miatt indult ujra - ilyenkor a korabbi strike-ok mar egy
    // masik "eletbol" valok, es az RTC memoria tartalma is ketes.)
    //
    // ES AMI SZANDEKOSAN NINCS ITT: az ESP_RST_USB es az ESP_RST_JTAG. Kezenfekvo
    // volna oket is idesorolni ("uj firmware, tiszta lap"), de az pont a
    // legrosszabbkor torolne: aki egy lefagyo eszkozhoz odamegy es BEDUGJA a
    // kabelt, hogy megnezze, mi tortent, azzal a mozdulattal tunteteni el a
    // bizonyitekot. Ez az eszkoz felugyelet nelkul dolgozik, es a naplo a
    // diagnozis egyetlen eszkoze - ezert ott a megorzes ER TOBBET.
    // Normal uzemben ugyis nullaz az "1 ora hibatlan futas" szabaly.
    rtcWdtResets = 0;
  }
}

// Lefagyás elleni védelem.
//
// Az ESP-IDF task watchdogja alapból FUT (ESP_TASK_WDT_INIT=y, 5 mp), de két
// okból nem véd meg minket:
//   1. az Arduino loop taskja nincs ráiratkozva (main.cpp: loopTaskWDTEnabled
//      = false), tehát a loop() megakadását észre sem veszi;
//   2. a panic beállítás forrásfüggő: az IDF Kconfig alapértéke 'n' (timeoutkor
//      csak kiír egy figyelmeztetést, nem indít újra), a kész Arduino libek
//      viszont bekapcsolják (CONFIG_ESP_TASK_WDT_PANIC=y, a lib-builder
//      defconfig.common:21 sora). Nem hagyatkozunk egyikre sem.
// Ezért kifejezetten beállítjuk mindkettőt.
//
// idle_core_mask = 0: csak a saját loop taskunkat figyeltetjük. Az idle task
// figyelése itt kifejezetten káros lenne, mert a firmware szándékosan blokkol
// percekig (90 mp-es relé pulzus), és egy hosszú timeout mellett is kockázatos
// újraindítási hurkot okozna.
void initWatchdog() {
  esp_task_wdt_config_t cfg = {};
  cfg.timeout_ms = WDT_TIMEOUT_MS;
  cfg.idle_core_mask = 0;
  cfg.trigger_panic = true;

  // 1. A TWDT-nek LÉTEZNIE kell, mielőtt feliratkozunk rá. Az Arduino alapból
  //    inicializálja (ESP_TASK_WDT_INIT=y), de ha valaki kikapcsolja, az
  //    esp_task_wdt_add() ESP_ERR_INVALID_STATE-et adna - az enableLoopWDT()
  //    viszont void, tehát ezt a hibát csendben elnyelné (esp32-hal-misc.c).
  esp_err_t initErr = ESP_OK;
  if (esp_task_wdt_status(NULL) == ESP_ERR_INVALID_STATE) {
    initErr = esp_task_wdt_init(&cfg);
    // Az init figyelt task nélkül NEM indítja el a timert (waiting_for_task),
    // azt a lenti feliratkozás teszi meg.
  }

  // 2. Feliratkozás. FONTOS a sorrend: előbb ez, csak utána a konfiguráció.
  //    Az esp_task_wdt_reconfigure() a végén csak akkor indítja újra a timert,
  //    ha a figyelt taskok listája nem üres. Fordított sorrendben a listánk épp
  //    üres lenne (az idle taskokat leiratkoztatjuk).
  if (initErr == ESP_OK) {
    enableLoopWDT();
  }

  // 3. Timeout és panic beállítása.
  const esp_err_t cfgErr = (initErr == ESP_OK) ? esp_task_wdt_reconfigure(&cfg) : initErr;

  // 4. Az EGYETLEN megbízható visszajelzés. Az enableLoopWDT() void, a
  //    loopTaskWDTEnabled pedig a core belső változója - enélkül azt hinnénk,
  //    védve vagyunk, közben a feedWatchdog() csak ESP_ERR_NOT_FOUND-ot kapna,
  //    és 10 ms-onként egy log_e() sort öntene a soros portra.
  watchdogEnabled = (esp_task_wdt_status(NULL) == ESP_OK);

  if (!watchdogEnabled || cfgErr != ESP_OK) {
    // MINDEN hibaág ide fut be, egyetlen, jól kereshető figyelmeztetéssel.
    // Ne hazudjunk védelmet. Egy 5 mp-es alapértelmezett timeout ráadásul
    // rosszabb lenne a semminél: a 15-33 mp-ig tartó HTTP teszt alatt
    // újraindítana (a 33 mp-es esetet lásd a WDT_TIMEOUT_MS-nél).
    if (watchdogEnabled) {
      // Feliratkozva maradni a be nem állított (tipikusan 5 mp-es) timeouttal
      // pontosan a fenti csapda lenne: a http.GET() etetés nélküli blokkolása
      // alatt MINDEN teszt watchdog-panicba és újraindítási hurokba futna,
      // három kör után végzetes hibáig. Ezért kiiratkozunk: védelem nincs,
      // de a program legalább fut.
      disableLoopWDT();
      watchdogEnabled = (esp_task_wdt_status(NULL) == ESP_OK);
    }
    Serial.print("FIGYELEM: a watchdog NEM vedi a loop()-ot (feliratkozas ");
    Serial.print(watchdogEnabled ? "OK" : "SIKERTELEN/VISSZAVONVA");
    Serial.print(", hibakod ");
    Serial.print((int)cfgErr);
    Serial.println("). A program fut, de lefagyas eseten nem indul ujra.");
    return;
  }
  Serial.print("Watchdog enabled, timeout ");
  Serial.print(WDT_TIMEOUT_MS / 1000);
  Serial.println(" s");
}

// A ket megszakitas-kezelo. IRAM_ATTR: a flash epp foglalt lehet (SPI olvasas),
// ezert az ISR nem elhet flashben. Mindketto CSAK jelzoket allit - semmi mas.
// A millis() ISR-bol is hivhato: a core-ban esp_timer_get_time()-ra epul, ami
// IRAM-ban van es megszakitasbol is ervenyes.
void IRAM_ATTR onResetButtonEdge() {
  if (digitalRead(resetPin) == LOW) {
    // A 0 a "nincs folyamatban levo lenyomas" jelolese; ha a millis() eppen 0
    // (korbefordulas), 1-re kerekitunk - ugyanaz a sentinel-kezeles, mint a
    // pollozott agban. Enelkul a korbefordulas pillanataban indult nyomas
    // sosem reteszelne.
    const uint32_t now = millis();
    btnResetDownAt = (now != 0) ? now : 1;
    return;
  }
  // Felfuto el: csak akkor reteszelunk, ha a lenyomas TELJES ERTEKU volt.
  const uint32_t down = btnResetDownAt;
  btnResetDownAt = 0;
  if (down != 0 && millis() - down >= BUTTON_DEBOUNCE_MS) {
    btnResetLatched = true;
  }
}

void IRAM_ATTR onWifiResetButtonEdge() {
  if (digitalRead(wifiresetPin) == LOW) {
    const uint32_t now = millis();      // lasd a 0 sentinelt az onResetButtonEdge()-ben
    btnWifiResetDownAt = (now != 0) ? now : 1;
    return;
  }
  const uint32_t down = btnWifiResetDownAt;
  btnWifiResetDownAt = 0;
  if (down != 0 && millis() - down >= BUTTON_DEBOUNCE_MS) {
    btnWifiResetLatched = true;
  }
}

// A reteszek elesitese. A setup()-ban a beragadt gomb ellenorzese UTAN hivjuk:
// egy beragadt gomb ugyis csak lefuto elt adna, felfutot sosem, tehat nem
// reteszelne - de a sorrend igy is egyertelmubb.
void armButtonLatches() {
  attachInterrupt(digitalPinToInterrupt(resetPin), onResetButtonEdge, CHANGE);
  attachInterrupt(digitalPinToInterrupt(wifiresetPin), onWifiResetButtonEdge, CHANGE);
}

// Csak akkor etetünk, ha a loop task már fel van iratkozva.
void feedWatchdog() {
  if (watchdogEnabled) {
    feedLoopWDT();
  }
}

void blockingDelay(uint32_t duration) {
  const uint32_t start = millis();
  while (millis() - start < duration) {
    const uint32_t elapsed = millis() - start;
    const uint32_t left = duration - elapsed;
    delay(left > BUTTON_POLL_MS ? BUTTON_POLL_MS : left);
    feedWatchdog();
  }
}

// Várakozás úgy, hogy a fizikai gombok közben is működnek
void waitWithButtons(uint32_t duration) {
  const uint32_t start = millis();
  while (millis() - start < duration) {
    resetbutton();
    wifiresetbutton();
    feedWatchdog();
    delay(BUTTON_POLL_MS);
  }
}

// Vissza van-e minden? Két lépés, ebben a sorrendben - és a SORREND a lényeg:
//   1. Wi-Fi: van-e kapcsolat? Ha nincs, csak KEZDEMÉNYEZÜNK egyet (aszinkron,
//      nem várunk rá), és kilépünk. Ez kísérlet, nem teszt: a kudarcnak nincs
//      következménye.
//   2. Internet: CSAK ha az 1. lépés szerint van kapcsolat, pingelünk egy fix
//      IP-t. Hálózat nélkül ennek nem lenne értelme, ezért el sem indul.
// Csak akkor igaz, ha MINDKETTŐ sikerül. Ezt kizárólag a hosszú várakozások
// korai lezárására használjuk.
//
// MIÉRT PING, amikor az internetteszt szándékosan HTTP? Mert itt más a tét.
// A ciklikus tesztnél egy hamis pozitív VÉGZETES lenne: befagyott router-DNS
// mellett a ping megy, és az eszköz sosem indítaná újra a routert (mérve: 41
// bukott HTTP teszt mellett nulla reset). Itt viszont a ping legrosszabb
// esetben annyit ér el, hogy a várakozás korábban ér véget - utána AZONNAL a
// rendes HTTP tesztsorozat következik, ami a befagyott DNS-t így is elbukja.
// Vagyis a hamis pozitív itt nem elrejt egy hibát, hanem hamarabb deríti ki.
// Cserébe a ping olcsó: nincs névfeloldás, nincs TCP, kevés rádióidő.
//
// FLASH: ez a függvény semmit nem ír a fájlrendszerre, és a WiFi.begin() sem
// ír NVS-be, mert a setup() WiFi.persistent(false)-t hívott. Az esemény-napló
// RTC RAM-ban van. Tehát tetszőleges gyakorisággal ismételhető.
bool onlineProbe() {
  // 1. LÉPÉS - Wi-Fi. Ez NEM teszt, hanem CSATLAKOZÁSI KÍSÉRLET, és nincs
  // következménye: ha nem sikerül, semmilyen számláló nem nő, semmilyen
  // állapot nem változik, és a hívó egyszerűen várakozik tovább. (A "3 próba,
  // aztán router reset" eszkalációhoz ennek semmi köze - az a firstStartDelay
  // LEJÁRTA után, a reconnectWifi()-ben kezdődik.)
  if (WiFi.status() != WL_CONNECTED) {
    // Nem várunk rá és nem blokkolunk: egy aszinkron újracsatlakozást
    // kezdeményezünk, a választ a KÖVETKEZŐ próba status()-a adja meg. A
    // hívások közt egy teljes ONLINE_PROBE_INTERVAL_MS telik, ami sokszorosa
    // egy asszociáció idejének - így nem szakítunk félbe egy futó próbát.
    // FONTOS INVARIANS: itt NINCS WiFi.mode() és NINCS WiFi.config(). Ez azért
    // helyes, mert a próba csak olyan helyekről fut, ahol a netif konfigurációja
    // ÉRINTETLEN az utolsó initWiFi() óta - a WiFi.disconnect(true) ugyanis
    // eldobná a statikus IP/DNS beállítást, és a begin() csendben DHCP-vel
    // jönne vissza. A sketchben mindössze két disconnect(true) van: az egyik
    // az enterDeepSleep()-ben (utána újraindulás), a másik a FAILURE_STATE
    // ágán, közvetlenül egy reconnectWifi() ELŐTT, ami újra alkalmazza a
    // konfigot. Ha valaha új disconnect(true) kerülne egy VÁRAKOZÁS elé, ezt
    // a függvényt is ki kell egészíteni. (Regresszió: WF10.)
    if (ssid[0] != '\0') {
      WiFi.begin(ssid, pass);
    }
    // ITT VISSZATÉRÜNK: pingelni ilyenkor értelmetlen (és pazarlás) lenne,
    // hiszen hálózat nélkül a csomag el sem indulna. A 2. lépés tehát CSAK
    // meglévő kapcsolat mellett fut - ezt az OP4 teszt őrzi.
    return false;
  }

  // 2. LÉPÉS - internet. Csak idáig eljutva van értelme: a kapcsolat megvan,
  // a kérdés már csak az, hogy kifelé is van-e út.
  const IPAddress target(PROBE_PING_IP[0], PROBE_PING_IP[1],
                         PROBE_PING_IP[2], PROBE_PING_IP[3]);
  return testInternetPing(target, "internet");
}

// Az onlineProbe() időzített változata: legfeljebb ONLINE_PROBE_INTERVAL_MS
// -enként enged tényleges próbát, közte azonnal hamissal tér vissza. Így a
// hívó minden körben hívhatja, a rádió mégsem dolgozik feleslegesen.
// A lastProbe-ot a hívó tartja, mert minden várakozásnak saját órája van.
bool onlineProbeDue(uint32_t& lastProbe, uint32_t now) {
  if (now - lastProbe < ONLINE_PROBE_INTERVAL_MS) {
    return false;
  }
  lastProbe = now;
  return onlineProbe();
}

// Ugyanaz, mint a waitWithButtons(), de közben figyeli, hogy visszajött-e a
// hálózat és az internet. Igazzal tér vissza, ha emiatt lépett ki korábban;
// hamissal, ha a teljes időt kivárta.
bool waitWithButtonsUntilOnline(uint32_t duration) {
  const uint32_t start = millis();
  uint32_t lastProbe = start;   // az első próba egy teljes intervallum múlva
  while (millis() - start < duration) {
    if (onlineProbeDue(lastProbe, millis())) {
      printUptime();
      Serial.println("A varakozas korabban veget er: halozat es internet OK.");
      return true;
    }
    resetbutton();
    wifiresetbutton();
    feedWatchdog();
    delay(BUTTON_POLL_MS);
  }
  return false;
}

// Fájlírás közben SEM aludni, SEM újraindulni nem szabad: a félbeszakadt
// mentés sérült konfigurációt hagyna hátra. A mentést az aszinkron webszerver
// taskja végzi, az alvásról és az újraindításról viszont a loop() dönt -
// ezért itt megvárjuk, amíg az írás befejeződik.
//
// Korlátos: ha a jelző bármiért beragadna, az eszköz nem fagyhat le miatta.
// Egy konfigmentés 4 fájl írása visszaolvasásos ellenőrzéssel, ami tipikusan
// néhány tíz ezredmásodperc - az 5 másodperc bőven elég tartalék.
constexpr uint32_t SAVE_WAIT_MAX_MS = 5000;


// Az alvas es az ujraindulas kozos torlopontja: megvarja a folyamatban levo
// fajlirast, ES MEG IS SZEREZI a zarat.
//
// MIERT NEM ELEG MEGVARNI? A puszta megvaras ugy ter vissza, hogy a zar
// SZABAD. A visszateres es a tenyleges esp_deep_sleep_start() / ESP.restart()
// kozott viszont meg lefut ket-harom println es egy Serial.flush() - ez valos
// ezredmasodpercek -, es abban az ablakban az async_tcp task ELINDITHAT egy uj
// mentest. Pontosan azt a felbevagott fajlirast kapnank, ami ellen a varakozas
// egyaltalan van. A halasztott ujraindulas komment sajat maga mondja ki, hogy
// a mobilos DUPLA KOPPINTAS gyakori - tehat epp ilyen sorozat all elo.
// Ugyanaz a hiba volt a restartFromButton()-ben is; ott a beginConfigWrite()
// atomikus megszerzese oldotta meg, itt ugyanaz a megoldas. (Merve: SH1.)
//
// A zarat NEM oldjuk fel: aki ezt hivja, mar nem ter vissza. A hataridos
// kilepes viszont megmarad - egy beragadt jelzo miatt az eszkoz nem fagyhat le,
// es 5 mp utan a zar nelkul is tovabblepunk (a regi viselkedes).
void lockConfigBeforeShutdown() {
  if (beginConfigWrite()) {
    return;  // szabad volt, es most mar a mienk
  }
  printUptime();
  Serial.println("Fajliras folyik - megvarjuk, mielott alszunk vagy ujraindulunk.");
  const uint32_t start = millis();
  bool acquired = false;
  while (millis() - start < SAVE_WAIT_MAX_MS) {
    feedWatchdog();
    delay(BUTTON_POLL_MS);
    if (beginConfigWrite()) {
      acquired = true;
      break;
    }
  }
  if (acquired) {
    Serial.println("A fajliras befejezodott.");
  } else {
    Serial.print("FIGYELEM: a mentes ");
    Serial.print(SAVE_WAIT_MAX_MS / 1000);
    Serial.println(" mp alatt sem fejezodott be, tovabblepunk.");
  }
}


// A relé lábának rögzítése az alvás idejére. Deep sleep alatt a digitális
// padek (GPIO6-21) alapból nagyimpedanciásak; a gpio_hold_en() a pad
// pillanatnyi (LOW) kimenetét rögzíti, a gpio_deep_sleep_hold_en() pedig
// érvényben tartja a holdot deep sleep alatt is (C3: driver/gpio.h, a
// gpio_hold_en 3. megjegyzése). A router így alvás közben akkor sem veszít
// áramot, ha a külső lehúzó ellenállás hiányzik. A 22k lehúzó ettől még
// kell: a hold a BEKAPCSOLÁS és a program indulása közti ablakban nem él.
// A hold az ébredés (ami a C3-on reset) után is tart; a setup() oldja fel,
// miután a lábat már maga hajtja LOW-ra - a relé így ébredéskor sem "villan".
void holdRelayForSleep() {
  if (gpio_hold_en((gpio_num_t)relayPin) == ESP_OK) {
    gpio_deep_sleep_hold_en();
  } else {
    // Nem végzetes: a dokumentált külső lehúzó ellenállás a tartalék.
    Serial.println("FIGYELEM: a rele lab rogzitese (gpio_hold_en) nem sikerult.");
  }
}


// Melyik gomb van lenyomva ÉPPEN MOST? 0 = reset, 1 = wifireset, -1 = egyik
// sem. A sorrend számít: ha valahogy mindkettő nyomva van, a reset gombot
// jelentjük - az kap gombébresztést, tehát az a veszélyesebb boot loop.
int pressedButtonNow() {
  if (digitalRead(resetPin) == LOW) return 0;
  if (digitalRead(wifiresetPin) == LOW) return 1;
  return -1;
}

// Beragadt gomb: jelzes, majd rovid alvas.
//
// Szándékosan nem az enterDeepSleep()-et hívja: itt a Wi-Fi és a webszerver
// még el sem indult, és gombébresztést sem szabad armolni - a beragadt gomb
// azonnal újraébresztené az eszközt, azaz végtelen boot loop lenne.
// logIt = false: a beragadt-gomb kör ismétlése, nem kerül újra a naplóba
// (lásd a setup() spam-védelmét).
void handleStuckButton(const char* message, uint16_t which, bool logIt) {
  Serial.println(message);
  Serial.print("Alvas ");
  Serial.print((unsigned long)(STUCK_BUTTON_SLEEP_US / 1000000ULL));
  Serial.println(" masodpercre, utana ujraprobalkozas.");
  Serial.flush();
  if (logIt) {
    logEvent(EV_STUCK_BUTTON, which);
  }

  // A két LED FELVÁLTVA villog. Ez szándékosan más, mint a végzetes hiba
  // jelzése (ott egyszerre villognak), így ránézésre megkülönböztethető.
  const uint32_t start = millis();
  bool on = false;
  // WDT-OK: korlatos es rovid. A ciklus pontosan STUCK_BLINK_MS-ig (3000 ms)
  // fut, ami a 90 000 ms-os WDT_TIMEOUT_MS harmincada. Etetni sem artana, de a
  // beragadt gomb agan a jelzes a lenyeg, es a rovidsege bizonyithato: a
  // feltetel maga korlatozza.
  while (millis() - start < STUCK_BLINK_MS) {
    on = !on;
    digitalWrite(ledPin, on ? HIGH : LOW);
    digitalWrite(wifiledPin, on ? LOW : HIGH);  // ellentétes fázis
    delay(FATAL_BLINK_MS);
  }
  digitalWrite(ledPin, LOW);
  digitalWrite(wifiledPin, LOW);

  // A relé itt is LOW (a setup() elején kapcsoltuk), és alvás alatt is az marad.
  holdRelayForSleep();
  // A LEZÁRÁS A LEGVÉGÉN, ahogy az enterDeepSleep()-ben is. A fenti
  // Serial.flush() a villogás ELŐTT állt, a holdRelayForSleep() viszont a
  // villogás UTÁN fut - és az KI TUD ÍRNI egy figyelmeztetést, ha a relé
  // lábának rögzítése nem sikerült. Flush nélkül épp az a sor veszne el a
  // deep sleepben, amiért az ember a soros portot nézi. (Mérve: SER7.)
  Serial.flush();
  Serial.end();
  esp_sleep_disable_wakeup_source(ESP_SLEEP_WAKEUP_ALL);
  esp_sleep_enable_timer_wakeup(STUCK_BUTTON_SLEEP_US);
  esp_deep_sleep_start();
}

void printUptime() {
  const uint32_t totalSec = (uint32_t)(esp_timer_get_time() / 1000000);
  const uint32_t d = totalSec / 86400;
  const uint32_t h = (totalSec % 86400) / 3600;
  const uint32_t m = (totalSec % 3600) / 60;
  const uint32_t s = totalSec % 60;

  char buf[48];
  if (d > 0) {
    snprintf(buf, sizeof(buf), "Uptime: %lud %luh %lum %lus",
             (unsigned long)d, (unsigned long)h, (unsigned long)m, (unsigned long)s);
  } else {
    snprintf(buf, sizeof(buf), "Uptime: %luh %lum %lus",
             (unsigned long)h, (unsigned long)m, (unsigned long)s);
  }
  Serial.println(buf);
}

// Initialize WiFi
bool initWiFi() {
  printUptime();
  if (ssid[0] == '\0') {
    Serial.println("Undefined SSID!");
    return false;
  }

  // Ha időközben (pl. az ESP saját auto-reconnectje miatt) már él a kapcsolat,
  // ne indítsuk újra: a WiFi.begin() feleslegesen lebontaná.
  if (WiFi.status() == WL_CONNECTED) {
    Serial.println("Already connected, skipping reconnect.");
    return true;
  }

  // A módot a config() előtt kell beállítani, különben egyes core verziókban
  // az "STA Failed to configure" hibával elszáll.
  WiFi.mode(WIFI_STA);

  // Statikus IP csak akkor, ha meg is adták. Üres mező = DHCP, nem hiba.
  bool staticOk = false;
  IPAddress localIP;
  IPAddress localGateway;
  if (ipStr[0] != '\0' || gatewayStr[0] != '\0') {
    // Régebbi firmware IPv6 címet is elmenthetett: az ilyet itt is ki kell
    // szűrni, különben a config() gateway és DNS nélküli statikus IP-t állítana.
    const bool ipValid = localIP.fromString(ipStr) && isUsableIPv4(localIP);
    const bool gatewayValid = localGateway.fromString(gatewayStr) && isUsableIPv4(localGateway);
    if (!ipValid) {
      Serial.println("❌ Invalid IP format (csak IPv4 hasznalhato)!");
    }
    if (!gatewayValid) {
      Serial.println("❌ Invalid gateway format (csak IPv4 hasznalhato)!");
    }
    staticOk = ipValid && gatewayValid;
  }

  if (staticOk) {
    // DNS-t is meg kell adni: statikus konfignál a DHCP-s DNS elveszik,
    // enélkül a névfeloldás (és így a HTTP teszt) mindig elbukna.
    const IPAddress subnet(255, 255, 255, 0);
    const IPAddress dnsFallback(1, 1, 1, 1);  // ha a gateway nem szolgál ki DNS-t
    if (!WiFi.config(localIP, localGateway, subnet, localGateway, dnsFallback)) {
      Serial.println("⚠️ STA Failed to configure");
      staticConfigActive = false;  // DHCP-re esünk vissza
    } else {
      Serial.println("✅ Manual IP config applied.");
      staticConfigActive = true;
    }
  } else {
    staticConfigActive = false;
    Serial.println("➡️ Skipping manual IP config. Using DHCP...");
  }

  WiFi.begin(ssid, pass);
  Serial.println("Connecting to WiFi...");
  Serial.print("Trying to connect to SSID: ");
  Serial.println(ssid);

  const uint32_t startAttempt = millis();
  while (WiFi.status() != WL_CONNECTED) {
    resetbutton();
    wifiresetbutton();
    feedWatchdog();
    delay(BUTTON_POLL_MS);
    if (millis() - startAttempt >= WIFI_CONNECT_TIMEOUT_MS) {
      printUptime();
      Serial.println("Failed to connect.");
      return false;
    }
  }

  printUptime();
  Serial.print("Connected to: ");
  Serial.println(WiFi.SSID());
  Serial.print("IP Address: ");
  Serial.println(WiFi.localIP());
  Serial.print("Signal strength (RSSI): ");
  Serial.print(WiFi.RSSI());
  Serial.println(" dBm");
  return true;
}

bool reset_device() {
  if (testState.resetStep == 0) {
    testState.resetEvents++;
    if (testState.resetEvents >= maxfailureEvents) {
      internetFailSleep();
    }
    logEvent(EV_ROUTER_RESET, (uint16_t)testState.resetEvents);
    // A naplo kiirasa a fajlrendszerre, MIELOTT a relehez nyulnank. Ha a
    // router ujrainditasa kozben aramszunet jon (nem ritka: epp azert
    // piszkaljuk a halozatot, mert valami nem stimmel), az RTC naplo elveszne
    // - a fajl viszont megmarad. A mentes NEM blokkolja a resetet: ha nem
    // sikerul, csak szolunk rola.
    saveEventLog("router reset elott");
    Serial.println("Router resetting");
    Serial.print("Powering OFF the router. Instance = ");
    Serial.println(testState.resetEvents);
    digitalWrite(relayPin, HIGH);
    Serial.println("Relay on.");
    // A státusz LED a pulzus alatt VILLOG (lásd lent), nem csak kialszik:
    // 90 mp sötét LED ránézésre nem különböztethető meg a halott eszköztől.
    // A villogás azt mondja: "épp én kapcsoltam le a routert, dolgozom".
    digitalWrite(ledPin, LOW);
    timing.blinkLast = millis();
    uiFlags.blinkOn = false;
    // A Wi-Fi LED viszont KI marad: a router most áram nélkül van, tehát
    // kapcsolat sincs. Enélkül a LED a teljes pulzus + RESET_DELAY alatt
    // (~11,5 perc) azt mutatná, hogy van Wi-Fi. Visszakapcsolni a sikeres
    // újracsatlakozás fogja.
    digitalWrite(wifiledPin, LOW);
    Serial.println("Reset_pulse delay.");
    testState.resetStep = 1;
    timing.resetPulseStart = millis();
    // A pulzus most indult: ebben a hívásban még biztosan nem járt le.
    return false;
  }

  if (millis() - timing.resetPulseStart >= RESET_PULSE) {
    Serial.println("Reset_pulse delay end.");
    Serial.print("Powering ON the router. Instance = ");
    Serial.println(testState.resetEvents);
    digitalWrite(relayPin, LOW);
    digitalWrite(ledPin, HIGH);  // a villogás vége: a jelzés visszaáll folyamatosra
    printUptime();
    testState.resetStep = 0;
    return true;
  }

  // A pulzus alatt: a státusz LED villog 2 Hz-cel. A hívó ciklusa
  // BUTTON_POLL_MS-enként hív minket, tehát ez elég sűrű ütem hozzá.
  if (millis() - timing.blinkLast >= RESET_BLINK_MS) {
    timing.blinkLast = millis();
    uiFlags.blinkOn = !uiFlags.blinkOn;
    digitalWrite(ledPin, uiFlags.blinkOn ? HIGH : LOW);
  }
  return false;
}

// FIGYELEM (hardver): deep sleep alatt az ESP32-C3 digitális lábai (GPIO6-21)
// alapból nagyimpedanciás állapotba kerülnek. A relé lábát (D10 = GPIO10)
// ezért alvás előtt a holdRelayForSleep() rögzíti LOW-ra (gpio_hold_en +
// gpio_deep_sleep_hold_en) - így az alvás alatt sem lebeg. A relé
// vezérlőbemenetére ettől függetlenül TOVÁBBRA IS kell külső lehúzó ellenállás
// (a jelenlegi bekötésben 22k a GND felé): a hold a bekapcsolás és a program
// indulása közti ablakban még nem él, és a szoftveres védelem hibája ellen
// is ez az utolsó háló.
// Közös elalvás. timerUs = 0 esetén NINCS időzített ébresztés: az eszköz
// magától nem tér vissza, csak a reset gombra vagy áramtalanításra.
void enterDeepSleep(uint64_t timerUs) {
  // A NAPLO KIIRASA, MINDEN alvas elott. Korabban ez csak a ket idozitett
  // alvasnal (retrySleep, internetFailSleep) allt, kulon-kulon a hivo
  // fuggvenyben - az apSleep() es a fatalSleep() kimaradt belole. Pedig a
  // kriterium mindegyikre all: hosszabb ido kovetkezik, ami alatt egy
  // aramszunet elviheti az RTC naplot. A vegzetes hibanal ez a
  // legfontosabb: epp azt akarjuk kesobb kivizsgalni.
  //
  // A kozos pontra hozas egyben megszunteti azt, hogy egy uj alvasi ut
  // eseten el lehessen felejteni. A hivas a zar megszerzese ELOTT van, mert
  // a saveEventLog() sajat maga szerzi meg es oldja fel a zarat - a
  // lockConfigBeforeShutdown() viszont mar nem adja vissza.
  //
  // Csatolatlan fajlrendszernel (pl. FATAL(1)) a mentes magatol kimarad.
  saveEventLog("alvas elott");

  // Egyetlen torlópont MINDEN alvásra (apSleep, internetFailSleep,
  // retrySleep, fatalSleep): fájlírás közben nem alszunk el.
  lockConfigBeforeShutdown();
  digitalWrite(ledPin, LOW);
  digitalWrite(relayPin, LOW);
  digitalWrite(wifiledPin, LOW);
  // A meghajtott LOW rögzítése az alvás idejére - a sorrend kötött: előbb a
  // digitalWrite, aztán a hold, mert a hold a pad PILLANATNYI állapotát fogja.
  holdRelayForSleep();
  WiFi.disconnect(true);
  stopWebPortal();
  Serial.flush();
  Serial.end();

  // A gomb-megszakítások leválasztása MÉG az ébresztőforrások élesítése előtt.
  //
  // MIÉRT? Az attachInterrupt() és az esp_deep_sleep_enable_gpio_wakeup()
  // UGYANAZOKAT a GPIO megszakítás-regisztereket állítja. A futásidejű
  // "bármelyik él" beállítás és az alváshoz kért "LOW szint" ébresztés
  // egymásra hatása nem dokumentált - ezért nem hagyatkozunk rá: előbb
  // leválasztunk, aztán élesítünk. Ugyanaz az elv, mint egy sorral lejjebb a
  // "tiszta lappal indulunk"-nál. Ébredés után a setup() újra élesíti őket.
  detachInterrupt(digitalPinToInterrupt(resetPin));
  detachInterrupt(digitalPinToInterrupt(wifiresetPin));

  // Tiszta lappal indulunk, hogy biztosan csak az legyen élesítve, amit akarunk.
  esp_sleep_disable_wakeup_source(ESP_SLEEP_WAKEUP_ALL);

  esp_err_t gpioErr = ESP_FAIL;
#if SOC_GPIO_SUPPORT_DEEPSLEEP_WAKEUP
  // A reset gomb ébressze fel az eszközt. Csak RTC-képes láb használható
  // (ESP32-C3: GPIO0-GPIO5); a resetPin a XIAO ESP32-C3-on D1 = GPIO3.
  // Szándékosan NINCS itt a wifireset gomb, és a handleStuckButton() sem
  // armol gombébresztést: egy beragadt gomb így nem tud boot loopot okozni.
  // Az IDF 6.0 átnevezte ezt az API-t, az arduino-esp32 pedig idf ">=5.3,<6.2"
  // tartományt deklarál, tehát mindkét névvel találkozhatunk.
#if ESP_IDF_VERSION_MAJOR >= 6
  gpioErr = esp_sleep_enable_gpio_wakeup_on_hp_periph_powerdown(1ULL << resetPin, ESP_GPIO_WAKEUP_GPIO_LOW);
#else
  gpioErr = esp_deep_sleep_enable_gpio_wakeup(1ULL << resetPin, ESP_GPIO_WAKEUP_GPIO_LOW);
#endif
#endif

  // Biztonsági háló: ébresztőforrás nélkül az eszköz külső resetig aludna.
  // Ha nem kértünk időzítőt ÉS a gombébresztés armolása nem sikerült (pl. mert
  // valaki nem RTC-képes lábra tette a gombot), inkább mégis armolunk egy
  // hosszú időzítőt, mint hogy az eszköz elérhetetlenné váljon.
  if (timerUs == 0 && gpioErr != ESP_OK) {
    timerUs = SLEEP_DURATION_US;
  }
  if (timerUs > 0) {
    esp_sleep_enable_timer_wakeup(timerUs);
  }
  esp_deep_sleep_start();
}

// Az internet tartósan nem jön vissza a router újraindításai után sem.
// A Wi-Fi ilyenkor működik, csak a kapcsolat rossz a szolgáltató felé, ezért
// van értelme később magától újrapróbálni: egy óra múlva magától felébred.
// (Idozitett alvasbol ez a MASODIK - a masik a retrySleep(), ott a halozat
// maga sincs meg. Az apSleep() es a fatalSleep() SZANDEKOSAN idozito nelkul
// alszik el, mert azok a hibak maguktol nem mulnak el.)
void internetFailSleep() {
  printUptime();
  Serial.print("A router ujrainditasa ");
  Serial.print(maxfailureEvents - 1);
  Serial.println(" alkalommal sem hozta vissza az internetet.");
  Serial.print("Alvas ");
  Serial.print((unsigned long)(SLEEP_DURATION_US / 60000000ULL));
  Serial.println(" percre, utana automatikus ujraprobalkozas.");
  logEvent(EV_SLEEP, 2);
  enterDeepSleep(SLEEP_DURATION_US);   // a naplot az enterDeepSleep() menti
}

// A hálózat nem látszik. Lehet, hogy a router fagyott le - pontosan erre való
// ez az eszköz. Áramtalanítjuk, kivárjuk a bootolást, majd újra próbálkozunk.
// Ugyanaz a menet, mint a működés közbeni kapcsolatvesztésnél.
bool routerResetAndRetry() {
  printUptime();
  Serial.println("A halozat nem latszik - router ujrainditas kovetkezik.");
  while (!reset_device()) {
    resetbutton();
    wifiresetbutton();
    feedWatchdog();
    delay(BUTTON_POLL_MS);
  }
  printUptime();
  Serial.println("Router reset kesz, varakozas a bootolasra.");
  // Ha a router hamarabb feláll, nem várjuk ki a maradékot. A próba a
  // kapcsolatot már igazolta, tehát a reconnectWifi() is felesleges.
  if (waitWithButtonsUntilOnline(RESET_DELAY)) {
    digitalWrite(wifiledPin, HIGH);
    return true;
  }
  return reconnectWifi();
}

// Hitelesítési hiba? Ilyenkor a router újraindítása értelmetlen.
bool wifiAuthFailed() {
  return WiFi.status() == WL_CONNECT_FAILED;
}

// A hálózat nincs ott, de valószínűleg visszajön: alvás egy órát, majd új kör.
void retrySleep() {
  printUptime();
  Serial.print("A halozat nem elerheto. Ujraprobalkozasi kor: ");
  Serial.print(rtcRetryRounds);
  Serial.print(" / ");
  Serial.println(MAX_RETRY_ROUNDS);
  // A HOSSZ A KONSTANSBOL, nem beegetve. Ugyanezt az erteket az
  // internetFailSleep() mar igy irja ki - ket alvas, ket kulonbozo modszer
  // ugyanarra a szamra: a SLEEP_DURATION_US egy jovobeli modositasa utan az
  // egyik sor hazudott volna. A soros naplo a fo diagnosztikai eszkoz, ott ez
  // nem engedheto meg.
  Serial.print("Alvas ");
  Serial.print((unsigned long)(SLEEP_DURATION_US / 60000000ULL));
  Serial.println(" percre, utana automatikus ujraprobalkozas.");
  logEvent(EV_SLEEP, 1);
  enterDeepSleep(SLEEP_DURATION_US);   // a naplot az enterDeepSleep() menti
}

// Nem sikerult csatlakozni a 3 probaval sem. Itt dol el, hogy tovabb varunk-e
// vagy beallito modba megyunk.
//
// A core meg tudja kulonboztetni a ket esetet (STA.cpp:146-148):
// WIFI_REASON_NO_AP_FOUND -> WL_NO_SSID_AVAIL (a halozat nem is latszik),
// WIFI_REASON_AUTH_FAIL -> WL_CONNECT_FAILED (rossz jelszo).
//
// FONTOS: az AUTH_FAIL agnak van egy "&& !first_connect" feltetele is, es a
// first_connect (STA.cpp:117) fuggveny-szintu static, ami csak az ELSO
// disconnect utan valt false-ra. Az elso sikertelen tarsitas tehat meg
// WL_DISCONNECTED-et ad. Ezert nem eleg egyetlen probalkozas: a setup() egy
// probaja utan a handleFirstStart() meg harmat tesz, es a dontes csak azutan
// szuletik meg. Regresszio: R1 (a probalkozasok szamat is meri) es R5.
//
// Konzervativan dontunk: CSAK az explicit hitelesitesi hiba kuld AP modba. Minden mas esetben ujraprobalkozunk, mert
// egy teves "varjunk tovabb" ara kesleltetett ujrakonfiguralas, a teves
// "menjunk AP modba" ara viszont egy halott eszkoz.
void wifiGiveUp() {
  const wl_status_t st = WiFi.status();
  printUptime();
  Serial.print("WiFi status a probalkozasok utan: ");
  Serial.println((int)st);

  if (st == WL_CONNECT_FAILED) {
    Serial.println("Hitelesitesi hiba - valoszinuleg rossz a jelszo. AP mod.");
    logEvent(EV_AP_MODE, 2);
    startConfigPortal();
    return;
  }

  rtcRetryRounds++;
  if (rtcRetryRounds >= MAX_RETRY_ROUNDS) {
    Serial.println("Ket napja nincs halozat - AP beallito mod.");
    rtcRetryRounds = 0;
    logEvent(EV_AP_MODE, 3);
    startConfigPortal();
    return;
  }
  retrySleep();
}


// AP beállító mód lejárt mentés nélkül. Ugyanaz a logika, mint a LittleFS
// hibánál: időzített ébresztés nincs, csak a reset gomb hozza vissza.
void apSleep() {
  printUptime();
  Serial.println("Az AP beallito modban nem tortent mentes, az ESP elalszik.");
  Serial.println("Idozitett ebresztes NINCS - reset gomb vagy aramtalanitas kell.");
  logEvent(EV_SLEEP, 3);
  enterDeepSleep(0);
}

// Végzetes hiba után elalvás. Időzített ébresztés NINCS: a hiba magától nem
// múlik el, ezért értelmetlen lenne óránként felébredni és újra villogni.
void fatalSleep() {
  printUptime();
  Serial.print(FATAL_SLEEP_AFTER_MS / 60000);
  Serial.println(" perc hibajelzes utan az ESP elalszik.");
  Serial.println("Idozitett ebresztes NINCS - reset gomb vagy aramtalanitas kell.");
  logEvent(EV_SLEEP, 4);
  enterDeepSleep(0);
}

// Végzetes hiba egy BLOKKOLÓ környezetből (a gombkezelőkből).
//
// Az enterFatal() csak beállítja a módot, a jelzést pedig a loop() végzi. A
// gombkezelők viszont mély blokkoló ciklusokból is futnak - a
// waitWithButtonsUntilOnline(RESET_DELAY) például akár 10 percig nem ad
// vissza a loop()-nak.
// Addig az eszköz vidáman tovább működne: tesztelne, relét kapcsolna, aludna.
// Ezért itt helyben, blokkolva jelzünk, és SOHA nem térünk vissza - pontosan
// úgy, ahogy az eddigi ESP.restart() sem tért vissza ebből az ágból.
void fatalHalt(const char* reason) {
  enterFatal(reason);  // mód, relé LOW (a router kapjon áramot), üzenetek
  // Az enterFatal() altalanos uzenete a loop()-vezerelt esetre igaz, ahol
  // mindket gomb el. Itt csak a reset gomb - ezt ki kell mondani.
  Serial.println("FIGYELEM: itt a wifireset gomb NEM hat, csak a reset gomb.");

  while (millis() - timing.fatalStart < FATAL_SLEEP_AFTER_MS) {
    const uint32_t now = millis();
    if (now - timing.blinkLast >= FATAL_BLINK_MS) {
      timing.blinkLast = now;
      uiFlags.blinkOn = !uiFlags.blinkOn;
      digitalWrite(ledPin, uiFlags.blinkOn ? HIGH : LOW);
      digitalWrite(wifiledPin, uiFlags.blinkOn ? HIGH : LOW);
    }
    // Csak a reset gomb él. A wifiresetbutton()-t szándékosan NEM hívjuk:
    // épp onnan jöhettünk, az önmagába vezető rekurzió lenne.
    resetbutton();
    feedWatchdog();
    delay(BUTTON_POLL_MS);
  }
  fatalSleep();  // időzített ébresztés NÉLKÜL - nem tér vissza
}

// A gombos újraindítás közös útja - a pollozott és a reteszelt ág is ezt hívja.
//
// A zár ATOMIKUS megszerzése: a hívó gyors savingConfig-ellenőrzése és az
// ESP.restart() között az async_tcp taskban ELINDULHAT egy webes mentés, és a
// köztük lévő két println() + Serial.flush() nem is elhanyagolható idő. Az
// újraindítás ilyenkor félbevágná a fájlírást, és csonka konfigurációt hagyna
// a flashben. A zárral ez kizárt: ha megkaptuk, mentés már nem indulhat; ha
// nem kaptuk meg, visszatérünk, és a következő 10 ms-os kör újra próbálkozik.
// Feloldani nem kell - a zár az újraindulással hal el.
void restartFromButton(const char* reason) {
  if (!beginConfigWrite()) {
    return;
  }
  Serial.println(reason);
  Serial.println("RESTART ESP32C3 device.");
  Serial.flush();
  ESP.restart();
}

void resetbutton() {
  // Fájlírás közben SEMMIKÉPP nem indítunk újra: a félbeszakadt mentés sérült
  // konfigurációt hagyna hátra. Ugyanaz a szabály, mint az elalvásnál.
  // A mentés alatt a debounce sem indul el, tehát utána egy teljes 50 ms-os
  // lenyomás kell - egy mentés néhány tíz ezredmásodperc, ez nem érzékelhető.
  if (configWriteInProgress()) {
    return;
  }
  // A megszakitas-alapu retesz: egy TELJES ERTEKU (>= BUTTON_DEBOUNCE_MS)
  // lenyomas, ami egy blokkolo szakasz alatt tortent, es a gombot azota
  // felengedtek. A debounce-t nem kerulte meg - a hosszat az ISR merte meg.
  //
  // A jelzot SZANDEKOSAN NEM toroljuk: a restartFromButton() vagy ujraindit
  // (es akkor a RAM-mal egyutt a jelzo is eltunik), vagy visszater, mert a
  // konfigzar epp foglalt - ilyenkor a retesznek MEG KELL MARADNIA. A gomb
  // ekkor mar fel van engedve, tehat a pollozott ag nem tudna potolni: a
  // jelzo torlese a felhasznalo gombnyomasat NYOM NELKUL eldobna.
  if (btnResetLatched) {
    timing.resetBtnDownSince = 0;
    restartFromButton("Reset button pressed (latched).");
    // Idaig csak akkor jutunk, ha a zar foglalt volt. A HOST TESZTEKBEN ez a
    // sor feher marad, es ez helyes: a fenti savingConfig kapu ugyanazt a
    // jelzot nezi mikromasodpercekkel korabban, tehat ide csak a KET TASK
    // KOZOTTI valodi verseny vezethet (a gate utan, a beginConfigWrite() elott
    // indul egy mentes). Epp ez ellen van az atomikus zarszerzes. A LAT4 a
    // realis utat - a gate agat - meri.
    return;
  }

  if (digitalRead(resetPin) != LOW) {
    timing.resetBtnDownSince = 0;  // felengedve: debounce újraindul
    return;
  }
  const uint32_t now = millis();
  if (timing.resetBtnDownSince == 0) {
    // A 0 a "felengedve" jelölés; ha a millis() épp 0 (körbefordulás), 1-re
    // kerekítünk, hogy ne ütközzön vele. Hatása legfeljebb 1 ms a debounce-ban.
    timing.resetBtnDownSince = (now != 0) ? now : 1;
    return;
  }
  // Csak akkor fogadjuk el, ha végig lenyomva maradt (valódi debounce)
  if (now - timing.resetBtnDownSince >= BUTTON_DEBOUNCE_MS) {
    restartFromButton("Reset button pressed.");
  }
}

// A wifireset közös útja - a pollozott és a reteszelt ág is ezt hívja.
// A zárat itt is atomikusan szerezzük meg (lásd restartFromButton()).
void doWifiReset() {
  if (!beginConfigWrite()) {
    // Lasd a resetbutton() reteszelt againak megjegyzeset: ide is csak a ket
    // task kozotti valodi verseny vezet, ezert a host tesztekben feher marad.
    return;  // épp mentés folyik; a következő kör újra próbálja
  }
  Serial.println("WIFIRESET button is pulling down!");
  Serial.println("RESET saved wifi data!");
  // FONTOS a sorrend: az SSID megy ELŐSZÖR. A "wifireset" célja, hogy az
  // eszköz a beállító portálon jöjjön fel, és ezt egyedül a /ssid.txt dönti
  // el (setup(): ha üres az SSID -> AP mód). Ha a törlés közben elmegy az
  // áram, így a legvalószínűbb, hogy a kívánt végállapotba kerülünk.
  // A &= szándékosan nem rövidzáras: mind a négy törlés lefut akkor is, ha
  // valamelyik elbukik.
  bool cleared = true;
  cleared &= clearConfigValue(LittleFS, ssidPath);
  cleared &= clearConfigValue(LittleFS, passPath);
  cleared &= clearConfigValue(LittleFS, ipPath);
  cleared &= clearConfigValue(LittleFS, gatewayPath);
  if (!cleared) {
    // Ha a fájlrendszer nem írható, az eszköz NEM működhet tovább: a
    // konfiguráció mentése ugyanígy elbukna, az újraindítás pedig a régi
    // adatokkal jönne fel - a gomb a felhasználó szemszögéből "nem csinál
    // semmit". Ez ugyanaz a hibaosztály, mint a többi LittleFS hiba, tehát
    // ugyanaz a kezelés: mindkét LED gyorsan villog, 5 perc múlva alvás,
    // amiből csak a gomb vagy az áramtalanítás hoz vissza.
    Serial.println("!!! A mentett wifi adatok törlése NEM sikerült !!!");
    logEvent(EV_FATAL, 4);
    // A zár oldása még a hibajelzés előtt: a fatalHalt() gombkezelőjét a
    // beragadt savingConfig némává tenné (a resetbutton() ellenőrzi).
    endConfigWrite();
    fatalHalt("A mentett wifi adatok nem torolhetok - serult fajlrendszer.");
    // fatalHalt() nem tér vissza
  }
  Serial.println("RESTART ESP32C3 device.");
  Serial.flush();
  ESP.restart();  // a zár az újraindulással hal el
}

void wifiresetbutton() {
  // Mentés közben a törlés és az újraindítás is végzetes lenne: két task írná
  // egyszerre ugyanazokat a fájlokat. Ez itt csak a GYORS kapu; az igazi
  // védelem a doWifiReset()-ben lévő beginConfigWrite().
  if (configWriteInProgress()) {
    return;
  }
  // Megszakítás-alapú retesz - lásd a resetbutton() megfelelő ágát, beleértve
  // azt is, hogy a jelzőt NEM töröljük: ha a zár foglalt, a nyomás megmarad.
  if (btnWifiResetLatched) {
    timing.wifiResetBtnDownSince = 0;
    doWifiReset();
    return;  // csak foglalt zarnal - lasd a resetbutton() megfelelo agat
  }
  if (digitalRead(wifiresetPin) != LOW) {
    timing.wifiResetBtnDownSince = 0;
    return;
  }
  const uint32_t now = millis();
  if (timing.wifiResetBtnDownSince == 0) {
    // Lásd a resetbutton() megjegyzését a 0 sentinelről.
    timing.wifiResetBtnDownSince = (now != 0) ? now : 1;
    return;
  }
  if (now - timing.wifiResetBtnDownSince >= BUTTON_DEBOUNCE_MS) {
    doWifiReset();
  }
}

bool reconnectWifi() {
  printUptime();
  Serial.println("Starting reconnectWifi loop");

  for (uint8_t attempt = 0; attempt < wifi_maxRetries; attempt++) {
    printUptime();
    Serial.print("Attempt ");
    Serial.println(attempt + 1);

    if (initWiFi()) {
      printUptime();
      Serial.println("WIFI RECONNECTED!");
      digitalWrite(wifiledPin, HIGH);
      return true;
    }

    printUptime();
    Serial.print("WIFI ERROR! WiFi status: ");
    Serial.println(WiFi.status());

    if (attempt + 1 < wifi_maxRetries) {
      printUptime();
      Serial.print(wifiInterval / 1000);
      Serial.println(" seconds delay start.");
      waitWithButtons(wifiInterval);  // gombok közben is élnek, nincs busy-loop
    }
  }

  printUptime();
  Serial.print("WIFI FAILED TO RECONNECT AFTER ");
  Serial.print(wifi_maxRetries);
  Serial.println(" attempts!");
  // A folytatásról a hívó dönt (mindenhol: AP beállító mód).
  return false;
}


// Elérhető-e a saját gateway-ünk?
//
// Csak statikus IP mellett van értelme: DHCP-nél a gateway magától a routertől
// jött. Ha viszont kézzel adtad meg és elgépelted, akkor a Wi-Fi TÁRSÍTÁS
// sikerül (az WPA2, 2. réteg), de IP szinten nincs út sehová - és a router
// újraindítása ezen soha nem segít. Épp ezt a különbséget méri ez a teszt:
// a hozzáférési pont él (különben nem lennénk csatlakozva), de nem érjük el.
//
// FIGYELEM: ha a routered nem válaszol ICMP echóra, ez tévesen "elérhetetlen"-t
// ad. Ezért is kap a router előbb egy esélyt, és csak a második alkalommal
// megyünk AP módba. Ha a routered blokkolja a pinget, használj DHCP-t.
bool gatewayUnreachable() {
  if (!staticConfigActive || gatewayStr[0] == '\0') {
    return false;  // nincs mit ellenőrizni
  }
  IPAddress gw;
  // Vedelmi ag, amit a gyakorlatban nem lehet elerni: a staticConfigActive csak
  // akkor igaz, ha az initWiFi()-ben a gatewayStr mar sikeresen ertelmezodott,
  // es azt csak a POST kezelo irja at - az viszont ujraindit. Emiatt ez a sor
  // sem szerepel a lefedettsegben.
  if (!gw.fromString(gatewayStr) || !isUsableIPv4(gw)) {
    return false;
  }
  return !testInternetPing(gw, "sajat gateway");
}

void handleFirstStart(uint32_t currentMillis) {
  // A várakozás korai lezárása. Az órát a setup() állítja be úgy, hogy az ELSŐ
  // próba azonnal esedékes legyen: a tipikus eset ugyanis az, hogy a kapcsolat
  // MÁR él (a setup() initWiFi()-je sikerült), és ilyenkor semmi értelme
  // 60 mp-et várni a továbblépéssel.
  //
  // FIGYELEM, VISELKEDÉSVÁLTOZÁS: korábban a puszta Wi-Fi kapcsolat is azonnal
  // lezárta a várakozást. Most a ping is kell hozzá.
  //
  // Ez NEM azt jelenti, hogy internet híján mindig letelik a 10 perc: a próba
  // 60 mp-enként ISMÉTLŐDIK, tehát ha az internet a várakozás bármely pontján
  // visszajön, a kilépés az azt követő ütemben megtörténik (mérve: OP7 - a
  // 3,5 percnél visszatérő internetnél a várakozás 4 perc alatt lezárult).
  // A teljes 10 perc csak akkor telik le, ha VÉGIG nincs internet - és épp
  // ez a helyes: áramszünet után a router lassabban indul, mint az ESP, és
  // nem akarjuk 2 perccel a bekapcsolás után újraindítani.
  const bool online = onlineProbeDue(firstStartProbeLast, currentMillis);

  if (!online) {
    if (currentMillis - timing.startMillis < firstStartDelay) {
      if (!uiFlags.firstStartPrinted) {
        printUptime();
        Serial.println("First start wait begin.");
        uiFlags.firstStartPrinted = true;
      }
      resetbutton();
      wifiresetbutton();
      feedWatchdog();
      delay(BUTTON_POLL_MS);  // vTaskDelay: 10 percig ne pörgesse a CPU-t
      return;  // csak itt kilép, visszaadja a vezérlést a loop()-nak
    }

    printUptime();
    Serial.println("First start wait end.");

    if (!reconnectWifi()) {
      // Rossz jelszónál a router újraindítása értelmetlen - egyből AP mód.
      if (wifiAuthFailed()) {
        wifiGiveUp();
        return;
      }
      // Egyébként: hátha a router fagyott le. Áramtalanítás, majd újra.
      if (!routerResetAndRetry()) {
        wifiGiveUp();
        return;
      }
    }
  } else {
    // A próba már igazolta a kapcsolatot: nincs mit újracsatlakoztatni.
    printUptime();
    Serial.println("First start wait end (halozat es internet visszajott).");
    digitalWrite(wifiledPin, HIGH);
  }
  // Innentől a firstStart lezárult. A timing.startMillis viszont NEM válik
  // érdektelenné: a watchdog számláló nullázása is ehhez méri az "1 óra
  // hibátlan működést" (loop(), WDT_COUNTER_CLEAR_MS). Ezért a mező végig a
  // BOOT időbélyege marad - frissíteni nemcsak felesleges, hanem hibás is
  // lenne, mert eltolná a watchdog-ablakot.
  uiFlags.firstStart = false;
}


void startConfigPortal() {
  if (deviceMode == MODE_CONFIG) {
    return;  // már fut
  }
  // Naplomentes MEG a modvaltas elott. Az AP mod azt jelenti, hogy az eszkoz
  // feladta a csatlakozast - epp ezt az elozmenyt akarja latni az, aki
  // odamegy es megnyitja a portalt. A mentes ugyanabban a pillanatban meg
  // MODE_MONITOR-ban tortenik, tehat a webszerver meg nem fut: a fajlirasnak
  // nincs versenytarsa a masik taskbol.
  saveEventLog("AP modba valtas elott");
  deviceMode = MODE_CONFIG;
  touchApDeadline();
  // Jelzés: a Wi-Fi LED villog (a villogtatást a loop() végzi), a státusz LED
  // közben végig világít. Az utóbbi azért kell expliciten, mert ide a router
  // reset ága felől is be lehet érkezni, ahol a státusz LED épp villogott.
  digitalWrite(wifiledPin, LOW);
  digitalWrite(ledPin, HIGH);
  timing.blinkLast = millis();
  uiFlags.blinkOn = false;

  startWebPortal();
}

void setup() {
  timing.startMillis = millis();
  // A first start próbájának órája egy teljes intervallummal "hátra" áll, hogy
  // az ELSŐ próba azonnal esedékes legyen. Az előjel nélküli kivonás
  // körbefordulása itt szándékos és helyes: a különbség akkor is pontosan egy
  // intervallum, ha a millis() még kicsi.
  firstStartProbeLast = timing.startMillis - ONLINE_PROBE_INTERVAL_MS;
  // Ugyanez a heap allapotsorara: az ELSO kiiras legyen azonnal esedekes, hogy
  // a bootolas utani heap-szint rogton lathato legyen. (Az "== 0 tehat meg
  // sosem irtunk" sentinel helyett ugyanaz a minta, mint a probak oraival.)
  heapLogLast = timing.startMillis - HEAP_LOG_INTERVAL_MS;

  pinMode(wifiresetPin, INPUT_PULLUP);
  pinMode(resetPin, INPUT_PULLUP);
  pinMode(ledPin, OUTPUT);
  pinMode(wifiledPin, OUTPUT);
  pinMode(relayPin, OUTPUT);
  digitalWrite(wifiledPin, LOW);
  digitalWrite(relayPin, LOW);
  digitalWrite(ledPin, HIGH);  //bekapcsolja a ledet, +5volt 150 ohm

  // Ha alvásból ébredtünk, a relé lábát még az alvás előtti hold tartja LOW-n
  // (lásd holdRelayForSleep()). Most már mi hajtjuk meg: előbb a meghajtás
  // (fent), aztán a feloldás - így a láb egy pillanatra sem marad magára.
  // Első bekapcsoláskor mindkét hívás ártalmatlan no-op.
  gpio_deep_sleep_hold_dis();
  gpio_hold_dis((gpio_num_t)relayPin);

  Serial.begin(115200);
  const uint32_t serialTimeout = millis();
  // WDT-OK: itt a watchdog MEG NEM EL - az initWatchdog() csak nehany sorral
  // lejjebb fut, szandekosan azutan, hogy a soros port hasznalhato (kulonben a
  // hibauzenete sem menne ki). Ezen felul a ciklus 3000 ms-re korlatos.
  while (!Serial && millis() - serialTimeout < 3000) { delay(BUTTON_POLL_MS); }
  blockingDelay(500);  // USB CDC beállása, hogy az induló logok ne vesszenek el

  printUptime();

  // Innentől figyeli a watchdog a programot - a setup() maradékát is.
  //
  // MIÉRT ITT? Amint a soros port használható (hogy a hibaüzenete kimenjen),
  // és minden más ELŐTT. Korábban a LittleFS csatolása után élesedett, mert a
  // begin(true) első indításkor FORMÁZ, és az etetés nélküli formázás egy
  // ~1,5 MB-os partíción 15-20 mp volt - az akkori sémával ez indokolt
  // kihagyás volt. A partitions_custom.csv 512 KiB-os "spiffs" partíciója
  // viszont csak 128 szektor: tipikusan 4-7 mp (30-50 ms/szektor), és még a
  // szélsőségesen lassú, 400 ms/szektoros esetben is ~51 mp - mindkettő bőven
  // a 90 mp-es WDT_TIMEOUT_MS alatt. Így a formázás már felügyelhető, és a
  // setup() eddig védtelen szakaszai (gombellenőrzés, csatolás, konfig
  // olvasás) is a watchdog alá kerülnek.
  //
  // A setup() etetés nélküli leghosszabb szakaszai innentől: a beragadt gomb
  // 3 mp-es villogása (utána deep sleep) és a fenti formázás. Az initWiFi()
  // 20 mp-es várakozása és minden blockingDelay() magától etet.
  //
  // A hardveres interrupt watchdog (ESP_INT_WDT, 300 ms) végig aktív, de az
  // csak a "kemény" megállást fogja meg (letiltott megszakítás, megállt tick).
  // A csendes, szabályosan blokkoló beragadást csak ez a task watchdog látja.
  initWatchdog();

  // Mindkét gombot ellenőrizzük: ha bármelyik beragadt, nem indulunk el.
  // Spam-védelem: a beragadt gomb 60 mp-es alvás-ébredés köre percenként adna
  // egy BOOT + STUCK BUTTON párt, ami fél óra alatt kiszorítaná a körpufferből
  // a kivizsgálandó eseményeket. Ezért csak az ELSŐ kör kerül a naplóba, az
  // ismétlések (a hozzájuk tartozó BOOT-tal együtt) nem - ugyanaz az elv, mint
  // a TEST FAIL sorozatoknál.
  // Nem pillanatfelvétel: megvárjuk, elengedik-e. A részleteket lásd a
  // STUCK_BUTTON_CONFIRM_MS-nél - dióhéjban: az ébresztő gombnyomás alatt az
  // eszköz már bootol, tehát a gomb ilyenkor MINDIG lenyomva találtatik.
  int stuckButton = pressedButtonNow();
  if (stuckButton >= 0) {
    Serial.println("Gomb lenyomva indulaskor - megvarjuk, elengedik-e.");
    // PATTOGAS. A dontest EGYETLEN beolvasas hozza, nem kettő: ha a ciklus
    // feltételében olvasnánk, majd utána MÉGEGYSZER a minősítéshez, a két
    // olvasás közé beeshetne egy elengedéskori pattanás (a mechanikus gomb a
    // felengedéskor is ad néhány rövid visszaugrást), és a már elengedett
    // gombot beragadtnak minősítenénk. Így viszont a pattanás legfeljebb egy
    // további 10 ms-os kört jelent.
    bool elengedtek = false;
    const uint32_t vart = millis();
    while (millis() - vart < STUCK_BUTTON_CONFIRM_MS) {
      if (pressedButtonNow() < 0) {
        elengedtek = true;
        break;
      }
      feedWatchdog();
      delay(BUTTON_POLL_MS);
    }
    if (elengedtek) {
      stuckButton = -1;
      Serial.println("Elengedtek - ez ebreszto gombnyomas volt, indulunk tovabb.");
    }
  }
  const bool stuckRepeat =
    stuckButton >= 0 && stuckCycleAlreadyLogged((uint16_t)stuckButton);
  if (!stuckRepeat) {
    logEvent(EV_BOOT, (uint16_t)esp_reset_reason());
  }
  if (stuckButton == 0) {
    handleStuckButton("Reset button got stuck.", 0, !stuckRepeat);
  }
  if (stuckButton == 1) {
    handleStuckButton("Wifireset button got stuck.", 1, !stuckRepeat);
  }

  // A beragadt gomb ellenőrzése lefutott, jöhetnek a megszakítások. Ezek
  // teszik lehetővé, hogy egy blokkoló HTTP kérés (max. 33 mp) alatti
  // gombnyomás se vesszen el - a hosszmérés, tehát a debounce, az ISR-ben
  // történik. Lásd a btnResetLatched leírását.
  armButtonLatches();

  checkWatchdogResets();
  initHeapState();
  applyHeapCarry();

  Serial.println("Init LittleFS.");
  initLittleFS();   // az eredmenyt a modul jegyzi meg (filesystemReady)

  if (!filesystemReady()) {
    // A konfigurációt tároló fájlrendszer nem elérhető. Ez NEM azonos azzal,
    // hogy nincs még konfiguráció - itt tényleg hiba van.
    if (deviceMode != MODE_FATAL) {
      logEvent(EV_FATAL, 1);
      enterFatal("A LittleFS nem csatolhato, a wifi konfiguracio nem toltheto be.");
    }
  } else {
    // Load values saved in LittleFS
    ConfigStatus st = CONFIG_OK;
    if (readConfigValue(LittleFS, ssidPath, ssid, sizeof(ssid)) == CONFIG_ERROR) st = CONFIG_ERROR;
    // A jelszó kódolva van, ezért nagyobb pufferbe olvassuk, majd helyben
    // dekódoljuk. A puffer csak itt él, a veremben - nem globális.
    {
      char passRaw[SECRET_ENC_MAX + 1];
      if (readConfigValue(LittleFS, passPath, passRaw, sizeof(passRaw)) == CONFIG_ERROR) {
        st = CONFIG_ERROR;
        pass[0] = '\0';
      } else {
        decodeSecretInPlace(passRaw);
        strlcpy(pass, passRaw, sizeof(pass));
      }
    }
    if (readConfigValue(LittleFS, ipPath, ipStr, sizeof(ipStr)) == CONFIG_ERROR) st = CONFIG_ERROR;
    if (readConfigValue(LittleFS, gatewayPath, gatewayStr, sizeof(gatewayStr)) == CONFIG_ERROR) st = CONFIG_ERROR;

    if (st == CONFIG_ERROR && deviceMode != MODE_FATAL) {
      // A fájl létezik, de nem olvasható: sérült fájlrendszer. Ilyenkor nem
      // indulunk AP módba sem, mert a mentés is elbukna - inkább jelzünk.
      logEvent(EV_FATAL, 2);
      enterFatal("A mentett wifi konfiguracio nem olvashato (serult fajlrendszer).");
    }
  }

  Serial.println(ssid);
  Serial.print((unsigned)strlen(pass));
  Serial.println(" chars password loaded");
  Serial.println(ipStr);
  Serial.println(gatewayStr);

  // Ne írjuk a hitelesítő adatokat minden WiFi.begin()-nél az NVS-be (flash kímélés)
  WiFi.persistent(false);

  // Végzetes hibánál nem próbálkozunk sem csatlakozással, sem AP portállal.
  if (deviceMode != MODE_FATAL) {
    if (initWiFi()) {
      Serial.println("WIFI OK!");
      logEvent(EV_WIFI_OK, (uint16_t)rtcRetryRounds);
      rtcRetryRounds = 0;
      deviceMode = MODE_MONITOR;
      digitalWrite(wifiledPin, HIGH);  //led on

    } else if (ssid[0] == '\0') {
      // Nincs mentett hálózat: csak a beállító portál segíthet.
      logEvent(EV_AP_MODE, 1);
      startConfigPortal();

    } else {
      // Van mentett hálózat, csak most nem érhető el. NEM megyünk azonnal AP
      // módba: áramszünet után a router jóval lassabban indul, mint az ESP.
      // A handleFirstStart() kivárja a firstStartDelay-t (legfeljebb 10 perc -
      // 60 mp-enként megnézi, hogy visszajött-e a hálózat ÉS az internet, és
      // akkor korábban lép tovább), majd egységesen 3 próbát tesz 30 mp
      // szünetekkel.
      printUptime();
      Serial.println("Nem sikerult csatlakozni - first start varakozas kovetkezik.");
      deviceMode = MODE_MONITOR;
      digitalWrite(wifiledPin, LOW);
    }
  }

}

// ---------------------------------------------------------------------------
// A loop() harom uzemmod-aga es a kozos szamlalo-karbantartas.
//
// MIERT KULON? A loop() 362 sor volt, 38 dontesi ponttal es 6-os beagyazasi
// melyseggel: egyszerre vegzett diszpecselest, allapotgepet, LED-villogtatast
// es szamlalo-nullazast. Ez a program legkritikusabb fuggvenye - epp ennek
// kellene a legatlathatobbnak lennie. A szetbontas utan a loop() maga csak
// azt mondja meg, MI kovetkezik; a HOGYAN mind nevesitett fuggvenyben all.
//
// A "currentMillis" mindenhol atadott parameter marad, nem uj millis() hivas:
// egy kor MINDEN dontese ugyanahhoz az idobelyeghez merjen.
// ---------------------------------------------------------------------------

// Egy ora hibatlan futas utan a korabbi hibasorozatok mar nem szamitanak.
// MINDEN uzemmodban fut, a mod-elagazas ELOTT - lasd a benti indoklast.
void clearHealthyRunCounters(uint32_t currentMillis) {
  // Hibátlanul lefutott egy óra: a watchdog számláló nullázható.
  //
  // MIÉRT ITT, a mód-elágazás ELŐTT? Mert a "hibátlan működés" nem üzemmód
  // kérdése. Korábban ez a monitor ág belsejében állt, így AP beállító módban
  // (és a first start várakozás alatt) sosem futott le: egy órákig nyitva
  // tartott portál mellett az eszköz régi, elavult watchdog-strike-okat
  // cipelt volna magával, és egy jóval későbbi, magában ártalmatlan glitch
  // vitte volna a hármas küszöbre - vagyis feleslegesen MODE_FATAL-ba.
  // (Mérve: WDT9.)
  //
  // A FELTETEL ALAKJA. Ez volt az EGYETLEN abszolut millis() osszehasonlitas a
  // programban (az osszes tobbi idozites kulonbseg-alaku). Ket okbol lett
  // belole is kulonbseg:
  //
  // 1. KORBEFORDULAS. A millis() 49,7 naponta nullara fordul. Abszolut alakban
  //    a feltetel a fordulas utan egy oran at hamis lenne. (Ma nem okozna
  //    hibat, mert a szamlalo addigra ugyis nullazva van - de ez ervelessel
  //    igazolt biztonsag, nem a kifejezes alakjabol kovetkezo. A kulonbseg
  //    alak elojel nelkuli aritmetikaval magatol atvesszeli a fordulast.)
  //
  // 2. AZ INDULASI PONT KIMONDASA. Az abszolut alak azt a hallgatolagos
  //    feltevest hordozta, hogy a millis() MINDEN indulaskor nullarol kezd.
  //    Ez IGAZ - az ESP-IDF kimondja, hogy deep sleepbol ebredve az esp_timer
  //    (es igy az Arduino millis(), ami ebbol szarmazik) NULLAROL indul ujra;
  //    a sleep idejevel csak a LIGHT sleep utan lep elore, es csak a
  //    gettimeofday() az, ami a deep sleepet is atvinne. Igy viszont a
  //    feltetel maga mondja ki, mihez kepest mer: a setup() kezdetehez.
  //    (Merve: WDT14.)
  if (rtcWdtResets != 0 && currentMillis - timing.startMillis >= WDT_COUNTER_CLEAR_MS) {
    rtcWdtResets = 0;
    printUptime();
    Serial.print(WDT_COUNTER_CLEAR_MS / 60000);
    Serial.println(" perc hibatlan mukodes - a watchdog szamlalo nullazva.");
  }
  // Ugyanez a heap miatti ujrainditasok szamlalojara: egy ora hibatlan
  // mukodes utan a korabbi sorozat mar nem szamit. Kulon feltetel, hogy a
  // sorai kulon-kulon jelenjenek meg a soros porton.
  if (rtcHeapRestarts != 0 && currentMillis - timing.startMillis >= WDT_COUNTER_CLEAR_MS) {
    rtcHeapRestarts = 0;
    printUptime();
    Serial.print(WDT_COUNTER_CLEAR_MS / 60000);
    Serial.println(" perc hibatlan mukodes - a heap ujrainditas szamlalo nullazva.");
  }
}

// MODE_FATAL: vegzetes hiba jelzese. A program szandekosan nem fut tovabb -
// nem tesztel es nem kapcsolja a relet.
void handleFatalMode(uint32_t currentMillis) {
  // Mindkét LED együtt, gyorsan villog. A program szándékosan nem fut
  // tovább: nem tesztel és nem kapcsolja a relét.
  if (currentMillis - timing.blinkLast >= FATAL_BLINK_MS) {
    timing.blinkLast = currentMillis;
    uiFlags.blinkOn = !uiFlags.blinkOn;
    digitalWrite(ledPin, uiFlags.blinkOn ? HIGH : LOW);
    digitalWrite(wifiledPin, uiFlags.blinkOn ? HIGH : LOW);
  }
  // A hiba magától nem múlik el: 5 perc jelzés után elalszunk, hogy ne
  // fogyasszunk és ne villogjunk feleslegesen napokig.
  if (currentMillis - timing.fatalStart >= FATAL_SLEEP_AFTER_MS) {
    fatalSleep();
  }
  // A gombok élnek, hogy újraindítani vagy resetelni lehessen az eszközt.
  resetbutton();
  wifiresetbutton();
  delay(BUTTON_POLL_MS);
}

// MODE_CONFIG: az AP beallito portal futasa. Nincs internetteszt.
void handleConfigMode(uint32_t currentMillis) {
  // A Wi-Fi LED villog: "beállító módban vagyok, várom a böngészőt". A
  // státusz LED közben végig világít - a kettő együtt egyértelműen más,
  // mint a végzetes hiba (mindkettő 5 Hz) vagy a router reset (csak a
  // státusz LED, 2 Hz).
  if (currentMillis - timing.blinkLast >= AP_BLINK_MS) {
    timing.blinkLast = currentMillis;
    uiFlags.blinkOn = !uiFlags.blinkOn;
    digitalWrite(wifiledPin, uiFlags.blinkOn ? HIGH : LOW);
  }
  // Konfig módban nincs internetteszt. A portál AP_TIMEOUT_MS tétlenségig
  // él; minden kérés és a folyamatban lévő mentés kitolja a határidőt.
  resetbutton();
  wifiresetbutton();
  // Nem alszunk el, ha épp mentés folyik, vagy ha a sikeres mentés utáni
  // újraindításra várunk.
  if (!configWriteInProgress() && !restartRequested() &&
      (int32_t)(currentMillis - apDeadline) >= 0) {
    apSleep();
  }
  delay(BUTTON_POLL_MS);
}

// TESTING_STATE: a soron kovetkezo vegpont HTTP tesztje. Elotte megnezi, hogy
// egyaltalan van-e Wi-Fi kapcsolat.
void runTestingState() {
  if (WiFi.status() != WL_CONNECTED) {
    // SPAM-VEDELEM. Egy pislákoló kapcsolatnál (a jel a határon van, a
    // driver állapota másodpercenként többször vált) ez az ág körönként
    // újra lefutna, és a 32 elemű körpuffer kiszorítaná a kivizsgálandó
    // eseményeket. A SULYOSSAGROL OSZINTEN: védelem nélkül, REALIS
    // pislákolási ütemeknél (500 / 1000 / 2000 / 5000 ms) a mérés 4 / 2 /
    // 1 / 0 bejegyzést adott, tehát a puffert nem söpörte el - a
    // mechanizmus viszont valós, és a pislákolás gyorsulásával arányosan
    // romlik. Ugyanaz a szabály, mint a TEST FAIL sorozatoknál: csak a
    // sorozat ELSŐ tagja kerül a naplóba és a soros portra. Egy közbeeső
    // másik esemény után újra naplózunk. (Mérve: LOG4.)
    const bool ismetles = lastEventWas((uint8_t)EV_WIFI_LOST);
    if (!ismetles) {
      printUptime();
      logEvent(EV_WIFI_LOST, (uint16_t)WiFi.status());
      Serial.println("WiFi disconnected before test!");
    }
    digitalWrite(wifiledPin, LOW);

    // Egységes politika: 3 próba 30 mp szünetekkel.
    if (reconnectWifi()) {
      // Visszajött, a teszt a következő körben fut le.
      timing.stateStart = millis();
      return;
    }

    // Nem jött vissza: azonnal router újraindítás, nem várunk további
    // teszt ciklusokat. A FAILURE_STATE reset ágát így élesítjük - nincs
    // hálózat, amin bármelyik végpont elérhető lenne, nincs mit végigpróbálni.
    printUptime();
    Serial.println("WiFi nem jott vissza - router ujrainditas kovetkezik.");
    testState.cycleIndex = RESET_TRIGGER_CYCLE + 1;
    currentState = FAILURE_STATE;
    timing.stateStart = millis();
    return;
  }
  // A kapcsolat magától is helyreállhat (auto-reconnect), ilyenkor a LED
  // korábban hazudott volna.
  digitalWrite(wifiledPin, HIGH);
  if (rtcRetryRounds != 0) {
    rtcRetryRounds = 0;  // működik a hálózat: új 2 napos ablak
  }
  printUptime();
  Serial.println("Beginning Test.");
  // Csak az indexet írjuk ki ITT: az azt mondja meg, MELYIK végpont jön,
  // tehát a teszt ELŐTT van értelme. A hibaszámláló viszont a teszt
  // EREDMÉNYE - ezért az a "Test failed." sorra került. Korábban itt állt,
  // így a sorozat első tesztjénél mindig "0"-t írt ki.
  //
  // A KIÍRÁS 1-alapú (1..5), a belső cycleIndex marad 0-alapú: a 0..4
  // tartomány a végpontválasztó if-lánc és a RESET_TRIGGER_CYCLE
  // küszöb miatt kötött. Emberi olvasónak viszont nincs "0-dik teszt".
  Serial.print("Teszt ciklus index = ");
  Serial.println(testState.cycleIndex + 1);

  // Mind az ot teszt HTTP, mert az ICMP nem bizonyit sem nevfeloldast, sem
  // TCP-t: egy befagyott router-DNS mellett a ping tokeletesen megy, kozben
  // egyetlen eszkoz sem eri el az internetet. Nem veletlen, hogy egyetlen
  // nagy implementacio sem ICMP-vel validal (NetworkManager, Firefox,
  // Windows NCSI: mind HTTP). Ot kulonbozo uzemelteto, ket ellenorzesi mod.
  // Ures elvart valasz = 204-es ellenorzes, lasd testInternetHTTP().
  const TestEndpoint& vegpont = TEST_ENDPOINTS[testState.cycleIndex];
  const bool testResult = testInternetHTTP(vegpont.url, vegpont.expect);

  if (testResult) {
    testState.cycleIndex = 0;
    testState.failedCount = 0;
    testState.resetEvents = 0;
    currentState = SUCCESS_STATE;
  } else {
    testState.failedCount++;
    // Csak a hibasorozat első tagját naplózzuk: a 12 mp-enként ismétlődő
    // bejegyzések különben percek alatt kiszorítanák a fontos eseményeket.
    if (testState.failedCount == 1) {
      // 1-alapú, hogy a /log oldal ugyanazt a számot mutassa, mint a
      // soros port "Teszt ciklus index" sora.
      logEvent(EV_TEST_FAIL, (uint16_t)(testState.cycleIndex + 1));
    }
    printUptime();
    // A már megnövelt számláló: ez a mostani bukással együtt hány
    // egymás utáni sikertelen teszt van. A nevező az a darabszám, ami
    // után a router újraindítása következik (mind az öt végpont bukott).
    Serial.print("Test failed. | Hibák száma = ");
    Serial.print(testState.failedCount);
    Serial.print(" / ");
    Serial.println(MAX_CYCLE_INDEX + 1);
    currentState = FAILURE_STATE;
  }
  // A tesztek percekig futhatnak, ezért friss időbélyeg kell.
  timing.stateStart = millis();
  return;
}

// FAILURE_STATE: vagy a kovetkezo vegpontra lep, vagy - ha mind az ot elbukott -
// levezenyli a router ujrainditasat es az utana kovetkezo ellenorzeseket.
void runFailureState(uint32_t currentMillis) {
  // Mind az ot vegpont elbukott: a 4-es indexen a Google-t is probaltuk,
  // tehat a 0..4 mind lefutott es mind bukott. Mivel a ket szamlalo egyutt
  // lep (failedCount == cycleIndex + 1), ez pontosan 5 egymas utani bukas -
  // de a feltetel szandekosan a VEGPONT-lefedettseget mondja ki, nem az
  // idot: egyetlen uzemelteto kiesese soha ne latszodjon internetkimaradasnak.
  // Egy failedCount-alapu kuszob ugyanezt ma szam szerint eltalalna, de nem
  // ezt garantalna - ezert csak az index kot. A failedCount a naplozashoz es
  // a soros kimenethez kell (csak a hibasorozat elso tagja kerul a naplóba).
  if (testState.cycleIndex > RESET_TRIGGER_CYCLE) {

    if (!uiFlags.resetPrinted) {
      // Statikus IP mellett: ha a saját gateway-ünket sem érjük el, a hiba
      // helyi, és a router újraindítása nem javíthatja. Egy esélyt azért
      // adunk neki (hátha tényleg a router akadt meg) - a döntés a reset
      // UTÁNI ellenőrzésnél születik meg.
      if (gatewayUnreachable()) {
        printUptime();
        Serial.println("A sajat gateway sem elerheto - lehet, hogy rossz a statikus IP.");
        Serial.println("Kap a router egy esélyt: ujrainditas, aztan ujra ellenorizzuk.");
        logEvent(EV_GW_UNREACHABLE, 1);
      }
      printUptime();
      Serial.println("Beginning Reset in FAILURE_STATE.");
      while (!reset_device()) {
        resetbutton();
        wifiresetbutton();
        feedWatchdog();
        delay(BUTTON_POLL_MS);
      }
      printUptime();
      Serial.println("Reset is done in FAILURE_STATE.");
      Serial.println("RESET_DELAY start in FAILURE_STATE.");
      timing.stateStart = millis();
      uiFlags.resetPrinted = true;
      resetDelayProbeLast = millis();  // az első próba egy intervallum múlva
      return;                        // a RESET_DELAY a következő körökben telik
    }

    // A RESET_DELAY korai lezárása: ha a router hamarabb feláll, és az
    // internet is megvan, nincs mire várni.
    const bool earlyOnline = onlineProbeDue(resetDelayProbeLast, millis());

    if (earlyOnline || millis() - timing.stateStart >= RESET_DELAY) {
      printUptime();
      if (earlyOnline) {
        Serial.println("RESET_DELAY korai vege: halozat es internet OK.");
      } else {
        Serial.println("RESET_DELAY end in FAILURE_STATE.");
      }

      // Korai kilépéskor a kapcsolat MÁR él és mérve is van - a
      // disconnect(true) épp azt bontaná le, amit az imént igazoltunk.
      if (!earlyOnline) {
        Serial.println("Reconnect WIFI in FAILURE_STATE.");
        WiFi.disconnect(true);
        blockingDelay(100);

        // Egységesen 3 próba 30 mp szünetekkel. A reconnectWifi() minden
        // próbája teljes initWiFi(), ami újra alkalmazza a statikus IP/DNS
        // konfigot - a disconnect(true) ugyanis eldobja a netifet.
        if (!reconnectWifi()) {
          printUptime();
          Serial.println("A router reset utan sem jott vissza a WiFi.");
          digitalWrite(wifiledPin, LOW);
          wifiGiveUp();
          // Ez a return a host tesztekben feher marad, de nem azert, mert az
          // ag nem fut le (a WF11 meri): a wifiGiveUp() vagy elalszik,
          // vagy AP modba visz, es a harness az elalvast kivetellel
          // modellezi - a vezerles ide mar nem ter vissza.
          return;
        }

        printUptime();
        Serial.println("WIFI OK in FAILURE_STATE.");
      }
      digitalWrite(wifiledPin, HIGH);

      // A router megkapta az esélyét. Ha a gateway még mindig nem
      // válaszol, a statikus IP a rossz - a routert nincs értelme tovább
      // áramtalanítani. Beállító módba megyünk, hogy javítani lehessen.
      if (gatewayUnreachable()) {
        printUptime();
        Serial.println("A router ujrainditasa utan sem elerheto a gateway.");
        Serial.println("Valoszinuleg rossz a statikus IP - AP beallito mod.");
        logEvent(EV_GW_UNREACHABLE, 2);
        logEvent(EV_AP_MODE, 4);
        digitalWrite(wifiledPin, LOW);
        startConfigPortal();
        return;
      }

      testState.cycleIndex = 0;
      testState.failedCount = 0;
      uiFlags.resetPrinted = false;
      currentState = TESTING_STATE;
    }

  } else {
    if (currentMillis - timing.stateStart >= PROBE_DELAY) {
      if (testState.cycleIndex < MAX_CYCLE_INDEX) {
        testState.cycleIndex++;
      }
      currentState = TESTING_STATE;
    }
  }
}

// SUCCESS_STATE: varakozas a kovetkezo teszt-korig.
void runSuccessState(uint32_t currentMillis) {

  if (!uiFlags.successPrinted) {
    printUptime();
    Serial.println("Successful Test");
    Serial.println();
    Serial.println("SUCCESS_DELAY delay start.");
    uiFlags.successPrinted = true;
  }

  if (currentMillis - timing.stateStart >= SUCCESS_DELAY) {
    printUptime();
    Serial.println("SUCCESS_DELAY delay end.");
    uiFlags.successPrinted = false;
    timing.stateStart = currentMillis;
    currentState = TESTING_STATE;
  }
}

// MODE_MONITOR: a tenyleges internet-figyelo allapotgep. Ez a fuggveny mar csak
// diszpecsel - az allapotok viselkedese kulon-kulon olvashato fent.
void runMonitorStateMachine(uint32_t currentMillis) {
  switch (currentState) {
    case TESTING_STATE: runTestingState();             break;
    case FAILURE_STATE: runFailureState(currentMillis); break;
    case SUCCESS_STATE: runSuccessState(currentMillis); break;
  }

  // A várakozó állapotok (SUCCESS 1 perc, FAILURE 12 mp) alatt a loop()-nak
  // nincs dolga. delay() nélkül 1. prioritáson pörögne 100% CPU-val; a
  // vTaskDelay viszont ténylegesen felfüggeszti a taskot. Minden időzítés
  // ezredmásodpercekben mér, tehát a 10 ms-os szemcsézettség nem számít.
  delay(BUTTON_POLL_MS);
}

void loop() {
  const uint32_t currentMillis = millis();

  // Soros parancsok. MINDEN uzemmodban - epp a MODE_FATAL az, ahol a
  // diagnosztikara a legnagyobb szukseg van, es az az ag lentebb visszater.
  serialCommands();

  // Az AP-módú beállító oldal kérésére halasztott újraindítás.
  //
  // A türelmi idő alatt (2 mp) ÚJABB mentés is érkezhet - mobilon a dupla
  // koppintás gyakori. Ilyenkor épp fájlírás folyik, és az újraindítás félbe
  // vágná: előbb megvárjuk, hogy az írás befejeződjön - ÉS mindjárt meg is
  // szerezzük a zárat, hogy a várakozás vége és az ESP.restart() közötti
  // néhány ezredmásodpercben már ne indulhasson újabb mentés.
  if (restartRequestDue(currentMillis)) {
    lockConfigBeforeShutdown();
    clearRestartRequest();
    Serial.println("RESTART!");
    Serial.flush();
    ESP.restart();
  }

  clearHealthyRunCounters(currentMillis);

  // A heap felugyelete MINDEN uzemmodban mer es kiir (a diagnosztika ott is
  // kell, ahol epp baj van), az ujrainditas viszont csak monitor modban
  // tortenhet - lasd a checkHeap() kizarasait.
  checkHeap(currentMillis);
  // Az oraszinkron gondozasa: minden uzemmodban, mert a valos ido a naplo
  // ertelmezesehez kell - es AP modban is naplozunk.
  ensureNtp();

  if (deviceMode == MODE_FATAL) {
    handleFatalMode(currentMillis);
    return;
  }

  if (deviceMode == MODE_CONFIG) {
    handleConfigMode(currentMillis);
    return;
  }

  if (uiFlags.firstStart) {
    handleFirstStart(currentMillis);
    return;  // így biztosan nem fut le semmi más ebben a körben
  }

  resetbutton();
  wifiresetbutton();
  runMonitorStateMachine(currentMillis);
}
