manszabi/bazsi-router-reboot/test/test_main.cpp

#include <Arduino.h>
#include <set>
#include <algorithm>
#include <WiFi.h>
#include <LittleFS.h>
#include <ESPping.h>
#include <HTTPClient.h>
#include <esp_system.h>

#include <ESPAsyncWebServer.h>
#include <driver/gpio.h>
extern std::map<std::string, ArRequestHandlerFunction> g_handlers;
#include <cassert>
#include <unistd.h>
#include <sys/wait.h>
#include <cstdlib>
#ifdef COVERAGE_BUILD
extern "C" void __gcov_dump(void);
#endif

// --- a sketch globális állapota ---
void setup(); void loop();

// A VALODI loopTask MODELLEZESE.
//
// Az arduino-esp32 loopTask()-ja (main.cpp) igy nez ki:
//
//     for (;;) {
//       if (loopTaskWDTEnabled) { esp_task_wdt_reset(); }
//       loop();
//     }
//
// vagyis a core MINDEN iteracio elott etet, ha a loop task fel van iratkozva.
// Enelkul a harness sokkal rosszabbnak mutatna a programot, mint amilyen: egy
// oraknyi szimulalt futas egyetlen ORIASI "etetes nelkuli" szakasznak latszana,
// holott a valosagban minden korben van etetes.
//
// A makro miatt a forgatokonyvek valtozatlanul "loop()"-ot irhatnak, es
// mindegyik ezen az uton megy at. A sketch sajat loop()-jat a fuggvenymutato
// orzi meg - azt a makro mar nem irja at.
// A merest a program vezerlesi agara szukitjuk (lasd a stub wdtAdvanceTime()
// magyarazatat): a setup() es a loop() belseje szamit, a forgatokonyvek sajat
// allvanyzata nem.
static void (*const sketchLoop)() = &loop;
static void (*const sketchSetup)() = &setup;

// RAII: a kivetellel kilepo utak (deep sleep, ESP.restart) is helyesen zarjak.
struct ProgramScope {
  ProgramScope()  { g_wdtInProgram = true;  }
  ~ProgramScope() { g_wdtInProgram = false; }
};

static void coreLoopStep() {
  feedLoopWDT_fromCore();   // a core etetese: konyvel, de nem naploz
  ProgramScope sc;
  sketchLoop();
}
static void coreSetupStep() {
  ProgramScope sc;
  sketchSetup();
}
#define loop() coreLoopStep()
#define setup() coreSetupStep()
extern char ssid[]; extern char pass[]; extern char ipStr[]; extern char gatewayStr[];
enum State : uint8_t;
enum DeviceMode : uint8_t;
extern DeviceMode deviceMode;
extern State currentState;
bool initWiFi(); bool reconnectWifi(); bool reset_device();
void trimInPlace(char*);
bool testInternetHTTP(const char* url, const char* expected);
void initWatchdog();
bool testInternetPing(const IPAddress& target, const char* name);
enum ConfigStatus : uint8_t;
ConfigStatus readConfigValue(fs::FS& fs, const char* path, char* out, size_t outSize);
bool writeConfigValue(fs::FS& fs, const char* path, const char* msg);
bool clearConfigValue(fs::FS& fs, const char* path);
bool initLittleFS();
bool fileMatches(fs::FS& fs, const char* path, const char* value, size_t len);
bool filesystemReady();
void setFilesystemReady(bool ready);
extern uint32_t rtcWdtMagic;
extern uint32_t rtcWdtResets;
// A sync modul allapota SZANDEKOSAN nem elerheto kivulrol (static a
// sync.cpp-ben). A tesztek ugyanazon a szerzodesen at dolgoznak, mint a
// program - ez tobb, mint kenyszer: igy a tesztek a VISELKEDEST rogzitik,
// nem az implementaciot.
extern volatile uint32_t apDeadline;
extern uint32_t rtcRetryRounds;
extern uint32_t rtcEvMagic;
extern uint32_t rtcEvNext;
enum EventCode : uint8_t;
extern uint32_t rtcCarryRetryRounds;
// FIGYELEM: ennek BAJTROL BAJTRA egyeznie kell a sketch definiciojaval - nem
// csak az RTC memoria elrendezese miatt, hanem mert ez a struktura megy ki a
// LittleFS-re mentett naplofajlba is, tehat a FAJLFORMATUM resze.
struct EventEntry { uint32_t uptimeSec; uint32_t epoch; uint16_t param;
                    uint8_t code; uint8_t pad; };
static_assert(sizeof(EventEntry) == 12, "az EventEntry merete a fajlformatum resze");
extern EventEntry rtcEvents[];
// A sketch allapot-structjai. Sima globalisok, tehat egy valodi ujraindulas
// (a deep sleepbol ebredes is) nullazza oket - a coldBoot()-nak ugyanezt kell
// tennie. FIGYELEM: az alapertelmezett tagertekeknek egyeznie KELL a sketchbeli
// definicioval, kulonben a coldBoot() mas allapotbol indul, mint a valodi boot.
// Kulonosen a firstStart = true: enelkul a firstStart fazis kimaradna.
struct TestState { uint8_t cycleIndex = 0; uint8_t failedCount = 0;
                   uint8_t resetEvents = 0; uint8_t resetStep = 0; };
struct TimingState { uint32_t stateStart = 0; uint32_t resetPulseStart = 0;
                     uint32_t startMillis = 0; uint32_t resetBtnDownSince = 0;
                     uint32_t wifiResetBtnDownSince = 0; uint32_t blinkLast = 0;
                     uint32_t fatalStart = 0; };
struct UIFlags { bool successPrinted = false; bool resetPrinted = false;
                 bool firstStartPrinted = false; bool firstStart = true;
                 bool blinkOn = false; };
extern TestState testState;
extern TimingState timing;
extern UIFlags uiFlags;
extern bool staticConfigActive;
extern bool watchdogEnabled;
extern volatile bool btnResetLatched, btnWifiResetLatched;
extern volatile uint32_t btnResetDownAt, btnWifiResetDownAt;
extern int g_criticalMaxDepth;
extern int g_criticalEnters;
// A ket task kozotti osztott allapot elerese - lasd a sketchben a
// beginConfigWrite() alatti blokkot.
void requestRestart(uint32_t delayMs);
bool restartRequestDue(uint32_t now);
bool restartRequested();
void clearRestartRequest();
bool configWriteInProgress();
bool beginConfigWrite();
void endConfigWrite();
extern uint32_t resetDelayProbeLast;
extern uint32_t firstStartProbeLast;
bool onlineProbeDue(uint32_t& lastProbe, uint32_t now);
void logEvent(EventCode code, uint16_t param);
bool lastEventWas(uint8_t code);
bool stuckCycleAlreadyLogged(uint16_t which);
void lockConfigBeforeShutdown();
extern uint32_t g_epochNow;
void doWifiReset();
extern int g_ntpStarts;
void enterFatal(const char* reason);
void startConfigPortal();
bool beginConfigWrite();
void checkHeap(uint32_t now);
extern uint32_t heapCheckLast;
extern uint32_t heapLogLast;
extern uint8_t  heapCritStreak;
extern bool     heapWarnActive;
// Az NTP jelzoi a modulon BELUL vannak (static). Egy bekapcsolast a
// szerzodesen at modellezunk, ugyanugy, mint a sync modul allapotat.
void ntpResetForColdBoot();
constexpr uint8_t EVLOG_SIZE_C = 32;      // eventlog.h EVLOG_SIZE
constexpr size_t  SSID_MAX_LEN_C = 32;    // limits_config.h SSID_MAX_LEN
constexpr size_t  IPSTR_MAX_LEN_C = 15;   // limits_config.h IPSTR_MAX_LEN
constexpr uint16_t EVFILE_SIZE_C = 128;   // eventlog.h EVFILE_SIZE

// Az /evlog.bin fejlece. BAJTROL BAJTRA egyeznie kell az eventlog.h-beli
// EvFileHeader-rel: a betolto sajat hatarellenorzeset csak igy lehet
// kozvetlenul, a hivotol fuggetlenul probara tenni.
// FIGYELEM: BAJTROL BAJTRA egyeznie kell az eventlog.h-beli definicioval -
// ugyanaz a szabaly, mint az EventEntry-nel. Ez nem stilus kerdese: a ket
// forditasi egyseg UGYANAZT a nevet hasznalja, tehat ha eltérnek, az egydefinicios
// szabalyt sertjuk, es a valodi kod TULIRJA a teszt pufferet.
//
// Az elso valtozatom pontosan ezt hibazta el: kihagyta az utolso ket mezot
// (20 bajt helyett 12), es a loadEventLogHeader() 20 bajtot irt a 12 bajtos
// lokalisba. A SIMA BUILD ATENGEDTE - csak az ASan mutatta meg
// (stack-buffer-overflow es global-buffer-overflow, ket forgatokonyvben).
struct EvFileHeader {
  uint32_t magic;
  uint16_t version;
  uint16_t count;
  uint32_t evNextAtSave;
  uint32_t savedEpoch;
  uint32_t savedUptime;
};
static_assert(sizeof(EvFileHeader) == 20, "az EvFileHeader merete a fajlformatum resze");
const char* eventName(uint8_t code);
bool saveEventLog(const char* reason);
bool loadEventLogHeader(EvFileHeader& fej);
bool loadEventLogEntries(const EvFileHeader& fej, EventEntry* ki);
bool loadEventLogRange(const EvFileHeader& fej, uint32_t tol, uint16_t db, EventEntry* ki);
void printEventLogs();
void checkWatchdogResets();
bool gatewayUnreachable();
extern std::set<std::string> g_fsDirs;
extern std::string g_serialIn;
extern bool g_serialReadLies;
constexpr uint8_t EV_TEST_FAIL_C = 4;
constexpr uint8_t EV_FATAL_C = 9;
void resetbutton();
void wifiresetbutton();
void restartFromButton(const char* reason);
void enterDeepSleep(uint64_t timerUs);
void waitWithButtons(uint32_t);
void touchApDeadline();
void printUptime();
void decodeSecretInPlace(char* buf);
bool encodeSecret(const char* plain, char* out, size_t outSize);
void startConfigPortal();

// A sketch pinjei (variants/XIAO_ESP32C3/pins_arduino.h szerint). NEVESITVE:
// egy hardveres atkotes igy egyetlen sor a tesztekben is - korabban a relé
// GPIO10 (D5) volt, es a szama 37 helyen szerepelt szo szerint.
static const int PIN_RELAY   = 10;  // D10 - rele (kulso 22k lehuzoval)
static const int PIN_LED     = 6;   // D4  - statusz LED
static const int PIN_WIFILED = 5;   // D3  - Wi-Fi LED
static const int PIN_RESETBTN = 3;  // D1  - reset gomb (RTC-kepes, ebreszt)
static const int PIN_WIFIBTN  = 2;  // D0  - wifireset gomb
#define RELAY_HIGH "pin10=HIGH"
#define RELAY_LOW  "pin10=LOW"
#define LED_HIGH   "pin6=HIGH"
#define LED_LOW    "pin6=LOW"

static int failures = 0, checks = 0;
// A globalis watchdog-invarians kuszobe. Lasd az indoklast a
// runIsolated()-ben; roviden: a 90 000 ms-os watchdog fele.
static constexpr uint32_t WDT_FEED_GAP_LIMIT_MS = 45000;

// FELMENTES a globalis watchdog-invarians alol. Egy forgatokonyv beallithatja,
// ha SZANDEKOSAN modellez olyan szelsoseget, amit a kuszob nem enged - de csak
// INDOKKAL, es a harness ki is irja. Igy a felmentes lathato marad, nem tud
// csendben elszaporodni. Ma egyetlen hasznaloja van: a WDT8b, ami a korosan
// lassu (400 ms/szektor) flash formazasat modellezi.
//
// A helyes valasz ilyenkor NEM a kuszob lazitasa: az az OSSZES tobbi
// forgatokonyv vedelmet gyengitene egyetlen kivetel kedveert.
static const char* g_wdtGapWaiver = nullptr;

#define CHECK(cond, msg) do { checks++; if(!(cond)) { printf("  \033[31mFAIL\033[0m %s\n", msg); failures++; } \
                              else printf("  ok   %s\n", msg); } while(0)

// A sketch uiFlags struktúráját nem exportáljuk; a monitorozás kezdetét abból
// látjuk, hogy a WiFi csatlakozott és már nem a first start ágban vagyunk.
// Igaz, ha a soros kimeneten mar megjelent a keresett szoveg
static bool serialHas(const char* frag) {
  for (auto& l : g_serialLog) if (l.find(frag) != std::string::npos) return true;
  return false;
}

// Ugyanaz, de a SOROS kimeneten (a Serial.printf-fel irt sorok is itt vannak)
static int serialIndex(const char* frag) {
  for (size_t i = 0; i < g_serialLog.size(); i++)
    if (g_serialLog[i].find(frag) != std::string::npos) return (int)i;
  return -1;
}

// A jelszo kodolva kerul a fajlba. A szerzodes nem az, hogy MI van a fajlban,
// hanem hogy amit mentettunk, azt kapjuk vissza - es hogy a nyilt szoveg NINCS
// benne. Ez a segedfuggveny a fajl dekodolt tartalmat adja.
static std::string storedPass() {
  char buf[256];
  strlcpy(buf, g_fs["/pass.txt"].c_str(), sizeof(buf));
  decodeSecretInPlace(buf);
  return std::string(buf);
}

static int logIndex(const char* frag) {
  for (size_t i = 0; i < g_log.size(); i++) if (g_log[i].find(frag) != std::string::npos) return (int)i;
  return -1;
}

// Teljes újraindítás szimulálása.
// deepSleepWake = false: valódi bekapcsolás. A reset ok ESP_RST_POWERON, és az
//   RTC_DATA_ATTR rtcRetryRounds nullázódik, ahogy áramtalanításkor is.
// deepSleepWake = true: deep sleep utáni ébredés. A reset ok ESP_RST_DEEPSLEEP,
//   és az RTC memória megmarad - enélkül a több körön át tartó viselkedés
//   (MAX_RETRY_ROUNDS) egyáltalán nem lenne tesztelhető.
static void coldBoot(bool willConnect, const char* s, const char* p,
                     const char* ip, const char* gw, uint32_t latency = 500,
                     bool deepSleepWake = false) {
  g_millis = 1; g_log.clear(); g_serialLog.clear(); g_pinState.clear(); g_pinRead.clear();
  // A watchdog-etetes oraja is hidegindul. Enelkul egy tobbszor bootolo
  // forgatokonyvben a g_wdtLastFeed a REGI, nagyobb g_millis erteket orizne, es
  // a kulonbseg elojel nelkul alulcsordulna (~4,29 milliard) - vagyis a globalis
  // res-invarians hamisan bukna. (A merest ez a ket sor teszi ertelmezhetove.)
  g_wdtLastFeed = 0; g_wdtMaxFeedGap = 0;
  // A rele-mero is: a g_millis nullarol indul, egy nyitott HIGH szakasz
  // kulonben ~4,29 milliardot mutatna.
  g_relayMaxHighMs = 0; g_relayHighSince = 0; g_relayIsHigh = false;
  g_criticalMaxDepth = 0;
  // A heap modellje is hidegindul: egy valodi bekapcsolas tiszta heappel
  // indul. Enelkul egy korabbi forgatokonyv alacsony heapje atszivarogna a
  // kovetkezobe, es ott VARATLAN onkentes ujraindulast okozna.
  g_freeHeap = 180000; g_minFreeHeap = 180000; g_maxAllocHeap = 110000;
  g_heapDrainPerCall = 0; g_heapQueries = 0;
  // A sketch heap-orai is: ezek SZANDEKOSAN fajl-szintu globalisok (nem
  // fuggveny-szintu static-ok), epp azert, hogy egy hidegindulas itt is
  // visszaallithassa oket - kulonben egy korabbi forgatokonyv figyelmeztetes-
  // allapota atszivarogna a kovetkezobe.
  heapCheckLast = 0; heapLogLast = 0; heapCritStreak = 0; heapWarnActive = false;
  ntpResetForColdBoot();
  g_epochNow = 0; g_ntpStarts = 0;
  // A soros eletciklus merese is hidegindul (lasd SER6/SER7).
  g_serialOn = false; g_serialBaud = 0; g_serialFirstWriteMs = 0;
  g_serialWritesAfterEnd = 0; g_serialFlushedAll = true;
  g_fs.clear(); g_fsMountOk = true; g_fsMountMs = 0; g_wakeupUs = 0;
  g_fsWritable = true; g_fsCapacity = 0; g_fsRemoveOk = true; g_fsReadable = true;
  g_fsShortReadSkip = 0;
  g_resetReason = deepSleepWake ? ESP_RST_DEEPSLEEP : ESP_RST_POWERON;
  if (!deepSleepWake) {
    rtcRetryRounds = 0;
  }
  // Egy valodi hidegindulas ezeket is nullazza (sima globalisok). Enelkul egy
  // korabbi mentes utan beallitott halasztott ujrainditas atszivarogna a
  // "reboot" utanra, es kesobb, a scenario kozepen inditana ujra az eszkozt.
  clearRestartRequest(); endConfigWrite();
  // A sketch sima globalisai: egy valodi ujraindulas (a deep sleepbol ebredes
  // is) ezeket nullazza, mert nem RTC memoriaban vannak. Enelkul egy tobb
  // bootot vegigjatszo forgatokonyvben a resetEvents atszivarogna, es a
  // masodik kortol mar az internetFailSleep() futna a wifiGiveUp() helyett.
  testState = TestState();
  timing = TimingState();
  uiFlags = UIFlags();
  // A korai kilepes probainak orai is sima globalisok: egy valodi ujraindulas
  // nullazza oket. A setup() ugyan mindkettot beallitja hasznalat elott, de a
  // coldBoot() szerzodese az, hogy MINDENT ugy hagy, mint egy hidegindulas.
  resetDelayProbeLast = 0;
  firstStartProbeLast = 0;
  staticConfigActive = false;
  watchdogEnabled = false;
  g_gpioWakeResult = 0;
  g_gpioWakeMask = 0; g_gpioWakeMode = -1;
  g_isr.clear(); g_isrMode.clear();
  rtcCarryRetryRounds = 0;
  btnResetLatched = false; btnWifiResetLatched = false;
  btnResetDownAt = 0; btnWifiResetDownAt = 0;
  // A GPIO hold a valosagban tuleli az ebredest (reset), csak az
  // aramtalanitas torli - a modell is igy tesz.
  g_gpioHoldFails = false;
  if (!deepSleepWake) { g_heldPins.clear(); g_deepSleepHoldEnabled = false; }
  g_httpCode = 200; g_httpSize = -2; g_httpBeginOk = true; g_httpBody = "Microsoft NCSI";
  g_httpChunked = false; g_httpChunkSize = 0; g_httpRawOverride.clear();
  g_httpUrls.clear();
  wifiSim.reset(); pingSim = PingSim();
  wifiSim.willConnect = willConnect; wifiSim.latencyMs = latency;
  if (s && *s)  g_fs["/ssid.txt"] = s;
  if (p && *p)  g_fs["/pass.txt"] = p;
  if (ip && *ip) g_fs["/ip.txt"] = ip;
  if (gw && *gw) g_fs["/gateway.txt"] = gw;
  ssid[0] = pass[0] = ipStr[0] = gatewayStr[0] = '\0';
  deviceMode = (DeviceMode)0; currentState = (State)0;
}

static void sc0() {
  coldBoot(false, "", "", "", "");
  try { setup(); CHECK(true, "setup() lefutott deep sleep nélkül"); }
  catch (DeepSleepSignal&) { CHECK(false, "setup() NEM aludhat el SSID hiányában"); }
  CHECK(deviceMode == (DeviceMode)1, "MODE_CONFIG lett");
  CHECK(wifiSim.softApCount == 1, "softAP() elindult");
  CHECK(wifiSim.beginCount == 0, "WiFi.begin() nem futott (nincs SSID)");
  {
    // 15 percnyi loop konfig módban -> nem szabad elaludnia (a korábbi hiba)
    bool slept = false;
    const uint32_t t0 = g_millis;
    try { for (int i = 0; i < 200000 && g_millis - t0 < 4u*60*1000; i++) loop(); }
    catch (DeepSleepSignal&) { slept = true; }
    catch (RestartSignal&) {}
    // A régi hiba: 3 perc után elaludt a portál. Most 5 percig biztosan él.
    CHECK(!slept, "4 percig biztosan él a portál (regresszió)");
    CHECK(deviceMode == (DeviceMode)1, "konfig módban maradt");
  }

}

static void sc1() {
  coldBoot(true, "TestNet", "secret123", "", "");
  setup();
  CHECK(deviceMode == (DeviceMode)0, "MODE_MONITOR lett");
  CHECK(wifiSim.configCount == 0, "üres IP/GW esetén nincs WiFi.config() -> DHCP");
  CHECK(wifiSim.beginCount == 1, "pontosan egy WiFi.begin()");
  CHECK(g_pinState[5] == HIGH, "wifi LED (GPIO5) bekapcsolt");
  CHECK(logIndex("WiFi.mode(STA)") < logIndex("WiFi.begin"), "mode(STA) a begin() ELŐTT");

}

static void sc2() {
  coldBoot(true, "TestNet", "secret123", "192.168.1.200", "192.168.1.1");
  setup();
  CHECK(wifiSim.configCount == 1, "WiFi.config() lefutott");
  CHECK(wifiSim.cfgDns1.str() == "192.168.1.1", "DNS1 = gateway (nem 0.0.0.0!)");
  CHECK(wifiSim.cfgDns2.str() == "1.1.1.1", "DNS2 = 1.1.1.1 tartalék");
  CHECK(logIndex("WiFi.mode(STA)") < logIndex("WiFi.config"), "mode(STA) a config() ELŐTT");
  CHECK(logIndex("WiFi.config") < logIndex("WiFi.begin"), "config() a begin() ELŐTT");

}

static void sc3() {
  coldBoot(true, "TestNet", "pw", "nem-ip", "192.168.1.1");
  setup();
  CHECK(wifiSim.configCount == 0, "érvénytelen IP -> nincs config(), DHCP");
  CHECK(deviceMode == (DeviceMode)0, "attól még csatlakozik (monitor mód)");

}

static void sc4() {
  coldBoot(false, "TestNet", "pw", "", "");
  { uint32_t t0 = g_millis; setup(); uint32_t dt = g_millis - t0;
    CHECK(dt >= 20000 && dt < 26000, "initWiFi ~20s után adta fel");
    // Mentett SSID mellett NEM megyünk AP módba, hanem újrapróbálkozunk
    // (a részleteket a WF1-WF5 fedi).
    CHECK(deviceMode == (DeviceMode)0, "monitor módban marad és újrapróbál"); }

}

static void sc5() {
  coldBoot(true, "TestNet", "pw", "", "");
  setup();
  { int before = wifiSim.beginCount;
    bool r = initWiFi();
    CHECK(r, "initWiFi() true-t adott");
    CHECK(wifiSim.beginCount == before, "NEM hívott újabb WiFi.begin()-t"); }

}

static void sc6() {
  coldBoot(true, "TestNet", "pw", "192.168.1.200", "192.168.1.1");
  setup();
  { g_log.clear(); wifiSim.configCount = 0;
    // A FAILURE_STATE ág pontosan ezt teszi: disconnect(true) majd újracsatlakozás
    WiFi.disconnect(true);
    CHECK(!wifiSim.staticApplied, "disconnect(true) eldobta a netif statikus configját");
    bool r = initWiFi();
    CHECK(r, "újracsatlakozás sikerült");
    CHECK(wifiSim.configCount == 1, "a statikus IP/DNS ÚJRA alkalmazva lett");
    CHECK(wifiSim.staticApplied, "nem esett vissza DHCP-re");
    CHECK(wifiSim.cfgDns1.str() == "192.168.1.1", "a DNS is visszaállt"); }

}

static void sc7() {
  coldBoot(true, "TestNet", "pw", "", "");
  setup();
  { wifiSim.willConnect = false; wifiSim.begun = false;
    g_log.clear(); wifiSim.beginCount = 0;
    uint32_t t0 = g_millis; bool slept = false; bool ret = true;
    try { ret = reconnectWifi(); } catch (DeepSleepSignal&) { slept = true; }
    CHECK(!slept, "NEM alszik el - a folytatásról a hívó dönt");
    CHECK(!ret, "false-t ad vissza");
    CHECK(wifiSim.beginCount == 3, "pontosan 3 csatlakozási kísérlet");
    uint32_t dt = g_millis - t0;
    CHECK(dt >= 120000 && dt < 150000, "3x20s timeout + 2x30s szünet (~120s)"); }

}

static void sc8() {
  coldBoot(true, "TestNet", "pw", "", "");
  setup();
  { wifiSim.willConnect = false; wifiSim.begun = false; wifiSim.beginCount = 0;
    // a 2. kísérlet közben jön vissza a hálózat
    bool ok = false;
    // 25s után engedjük csatlakozni
    uint32_t releaseAt = g_millis + 25000;
    // egyszerűbb: kézzel léptetjük
    (void)releaseAt;
    wifiSim.willConnect = false;
    // szimuláljuk: az 1. initWiFi elbukik, majd engedélyezzük
    try {
      // 1. kísérlet
      ok = initWiFi();
      CHECK(!ok, "1. kísérlet elbukott");
      wifiSim.willConnect = true;
      ok = initWiFi();
      CHECK(ok, "2. kísérlet sikerült, miután visszajött a hálózat");
    } catch (DeepSleepSignal&) { CHECK(false, "nem lett volna szabad elaludnia"); } }

  // ============ SLEEP ============
}

static void sc9() {
  coldBoot(true, "TestNet", "pw", "", "");
  g_pinRead[3] = LOW;  // D1 = GPIO3 reset gomb lenyomva
  { bool slept = false; uint64_t us = 0;
    try { setup(); } catch (DeepSleepSignal& d) { slept = true; us = d.us; }
    CHECK(slept, "beragadt gombnál elalszik");
    CHECK(us == 60ULL*1000000ULL, "60 másodperces ébresztés");
    CHECK(g_gpioWakeMask == 0, "gomb-ébresztés NINCS armolva (különben boot loop)"); }

}

static void sc10() {
  coldBoot(true, "TestNet", "pw", "", "");
  setup();
  { // 5 sikertelen router reset -> tosleep()
    try {
      for (int c = 0; c < 10; c++) {
        int guard = 0;
        while (!reset_device() && ++guard < 200000) { yield(); }
      }
    } catch (DeepSleepSignal&) {}
    CHECK(g_pinState[PIN_RELAY] == LOW,  "relé (GPIO10) LOW - a router kap áramot");
    CHECK(g_pinState[6] == LOW,  "státusz LED (GPIO6) LOW");
    CHECK(g_pinState[5] == LOW,  "wifi LED (GPIO5) LOW");
    CHECK(!g_serialOn, "Serial.end() megtörtént");
    CHECK(logIndex(RELAY_LOW) < logIndex("DEEP_SLEEP"), "a relé az alvás ELŐTT kapcsolt le");
    CHECK(g_heldPins.count(PIN_RELAY) == 1, "a relé láb (GPIO10) hold-dal rögzítve alvásra");
    CHECK(g_deepSleepHoldEnabled, "a hold deep sleep alatt is érvényes (deep_sleep_hold_en)");
    { const int h = logIndex("gpio_hold_en(10)");
      CHECK(h >= 0 && h < logIndex("DEEP_SLEEP"), "a rögzítés az elalvás ELŐTT történt"); }
    CHECK(g_gpioWakeMask == (1ULL << 3), "reset gomb (GPIO3) ébresztésre armolva");
    CHECK(g_gpioWakeMode == 0, "LOW szintre ébred");
    CHECK(logIndex("timer_wakeup") < logIndex("DEEP_SLEEP"), "timer is armolva alvás előtt"); }

}

static void sc11() {
  // Az esp_deep_sleep_enable_gpio_wakeup() csak RTC-képes lábat fogad el;
  // az ESP32-C3-on ezek a GPIO0-GPIO5. Ha a firmware valaha nem RTC lábat
  // armolna, az API ESP_ERR_INVALID_ARG-gal elszállna a hardveren.
  coldBoot(true, "TestNet", "pw", "", "");
  setup();
  try {
    for (int c = 0; c < 10; c++) {
      int guard = 0;
      while (!reset_device() && ++guard < 200000) { yield(); }
    }
  } catch (DeepSleepSignal&) {}
  CHECK(g_gpioWakeMask != 0, "armolt gomb-ébresztést");
  {
    bool allRtc = true;
    for (int gpio = 0; gpio < 64; gpio++)
      if ((g_gpioWakeMask >> gpio) & 1ULL) { if (gpio > 5) allRtc = false; }
    CHECK(allRtc, "minden armolt láb RTC-képes (GPIO0-5)");
  }

}

static void sc12() {
  coldBoot(true, "TestNet", "pw", "", "");
  setup();
  CHECK(g_millis > 0, "friss boot");
  CHECK(deviceMode == (DeviceMode)0 && currentState == (State)0,
        "ébredés után TESTING_STATE / MONITOR (RTC memóriát nem használunk)");


  // ============ RELÉ / ROUTER RESET ============
}

static void sc13() {
  coldBoot(true, "TestNet", "pw", "", "");
  setup();
  { g_log.clear();
    uint32_t t0 = g_millis;
    int guard = 0;
    while (!reset_device() && ++guard < 200000) { yield(); }
    uint32_t pulse = g_millis - t0;
    CHECK(guard < 200000, "reset_device() befejeződött");
    CHECK(pulse >= 90000, "a pulzus legalább 90s volt (nem ~0)");
    CHECK(pulse < 92000, "és nem lényegesen több");
    CHECK(logIndex(RELAY_HIGH) >= 0, "relé bekapcsolt (router áramtalanítva)");
    CHECK(logIndex(RELAY_HIGH) < logIndex(RELAY_LOW), "előbb be, aztán ki");
    CHECK(g_pinState[PIN_RELAY] == LOW, "a végén a router visszakapta az áramot"); }

}

static void sc14() {
  coldBoot(true, "TestNet", "pw", "", "");
  setup();
  { int cycles = 0; bool slept = false;
    try {
      for (; cycles < 10; cycles++) {
        int guard = 0;
        while (!reset_device() && ++guard < 200000) { yield(); }
      }
    } catch (DeepSleepSignal&) { slept = true; }
    CHECK(slept, "elaludt");
    CHECK(cycles == 4, "4 tényleges reset után az 5. eseménynél alszik el"); }

  // ============ HTTP TESZT ============
}

static void sc15() {
  g_httpCode = 200; g_httpSize = -2; g_httpBeginOk = true;
  g_httpBody = "Microsoft NCSI";
  CHECK(testInternetHTTP("http://x/", "Microsoft NCSI"), "pontos egyezés");
  g_httpBody = "Microsoft NCSI\r\n";
  CHECK(testInternetHTTP("http://x/", "Microsoft NCSI"), "CRLF-fel a végén is egyezik");
  g_httpBody = "  Microsoft NCSI \n";
  CHECK(testInternetHTTP("http://x/", "Microsoft NCSI"), "körbevágott whitespace-szel is");

}

static void sc16() {
  g_httpBody = "Something Else";
  CHECK(!testInternetHTTP("http://x/", "Microsoft NCSI"), "más tartalom -> false");
  g_httpBody = "Microsoft NCSI"; g_httpCode = 302;
  CHECK(!testInternetHTTP("http://x/", "Microsoft NCSI"), "302 átirányítás -> false");
  g_httpCode = 200; g_httpBeginOk = false;
  CHECK(!testInternetHTTP("http://x/", "Microsoft NCSI"), "begin() hiba -> false");
  g_httpBeginOk = true;

}

static void sc17() {
  { std::string big(50000, 'x');
    g_httpBody = big; g_httpSize = 50000;
    uint32_t t0 = g_millis;
    bool r = testInternetHTTP("http://x/", "Microsoft NCSI");
    CHECK(!r, "nagy válasz -> false");
    CHECK(g_millis - t0 < 500, "azonnal elutasítja, nem olvassa végig");
    g_httpSize = -2; }

}

static void sc18() {
  { g_httpBody = std::string(50000, 'y'); g_httpSize = -1;
    CHECK(!testInternetHTTP("http://x/", "Microsoft NCSI"), "nem egyezik, de nem is szállt el");
    g_httpSize = -2; g_httpBody = "Microsoft NCSI"; }

  // ============ PING TESZT ============
}

static void sc19() {
  pingSim = PingSim(); pingSim.ok = true;
  CHECK(testInternetPing(IPAddress(1, 1, 1, 1), "Test"), "sikeres");
  CHECK(pingSim.calls == 2, "csak 2 pinget futtatott a 4-ből (korai kilépés)");

}

static void sc20() {
  pingSim = PingSim(); pingSim.ok = false;
  CHECK(!testInternetPing(IPAddress(1, 1, 1, 1), "Test"), "sikertelen");
  CHECK(pingSim.calls == 3, "3 ping után eldőlt, a 4. felesleges lett volna");

  // ============ KONFIG I/O ============
}

static void sc21() {
  { g_fs.clear();
    char buf[33];
    writeConfigValue(LittleFS, "/t.txt", "MyNetwork");
    CHECK(readConfigValue(LittleFS, "/t.txt", buf, sizeof(buf)) == (ConfigStatus)0, "CONFIG_OK, ha van tartalom");
    CHECK(std::string(buf) == "MyNetwork", "az érték visszaolvasva");
    writeConfigValue(LittleFS, "/t.txt", "");
    CHECK(readConfigValue(LittleFS, "/t.txt", buf, sizeof(buf)) == (ConfigStatus)0, "üres fájl -> CONFIG_OK (nincs érték, de nem hiba)");
    CHECK(buf[0] == '\0', "és a buffer ki lett ürítve");
    CHECK(readConfigValue(LittleFS, "/nincs.txt", buf, sizeof(buf)) == (ConfigStatus)1, "hiányzó fájl -> CONFIG_MISSING");
    g_fs["/t.txt"] = "sor1\nsor2";
    readConfigValue(LittleFS, "/t.txt", buf, sizeof(buf));
    CHECK(std::string(buf) == "sor1", "csak az első sort olvassa");
    char small[5];
    g_fs["/t.txt"] = "abcdefghij";
    readConfigValue(LittleFS, "/t.txt", small, sizeof(small));
    CHECK(std::string(small) == "abcd", "kis bufferbe csonkít, nem csordul túl"); }

  // ============ GOMB DEBOUNCE ============
}

static void sc22() {
  coldBoot(true, "TestNet", "pw", "", "");
  setup();
  { bool restarted = false;
    g_pinRead[3] = LOW;              // gomb lemegy
    try { resetbutton(); }           // első észlelés: csak megjegyzi
    catch (RestartSignal&) { restarted = true; }
    CHECK(!restarted, "az első LOW mintavétel nem indít újra");
    g_pinRead[3] = HIGH;             // tüske vége
    try { resetbutton(); } catch (RestartSignal&) { restarted = true; }
    CHECK(!restarted, "felengedés után sem");
    // most tartós nyomás
    g_pinRead[3] = LOW;
    try { resetbutton(); g_millis += 100; resetbutton(); }
    catch (RestartSignal&) { restarted = true; }
    CHECK(restarted, "tartós (>50ms) nyomásra viszont újraindul"); }

}

static void sc23() {
  // A beallito urlap a PROGRAMBAN van (CONFIG_FORM), nem a LittleFS-en.
  // Barmilyen is a fajlrendszer allapota, az eszkoznek konfigurálhatónak
  // kell maradnia - korabban egy elfelejtett data/ feltoltes utan a portal a
  // tartalek urlapra esett vissza, most nincs mire visszaesni.
  coldBoot(false, "", "", "", "");
  g_fs.clear();                       // teljesen ures fajlrendszer
  try { setup(); } catch (DeepSleepSignal&) {}
  CHECK(deviceMode == (DeviceMode)1, "konfig portál elindult LittleFS tartalom nélkül is");

  AsyncWebServerRequest root; g_handlers["/#1"](&root);
  CHECK(root._code == 200, "a / 200-at ad");
  CHECK(root._body.find("name=\"ssid\"") != std::string::npos
        && root._body.find("method=\"POST\"") != std::string::npos,
        "kitölthető űrlap, nem hibaüzenet");
  CHECK(root._body.find("data/") == std::string::npos,
        "nincs benne a régi 'nincs feltöltve a data/' figyelmeztetés");
  CHECK(root._body.find("style.css") == std::string::npos
        && root._body.find("favicon") == std::string::npos,
        "az űrlap nem hivatkozik külső fájlra - egyetlen kérésből teljes");

  // BIZTONSAG: a statikus vegpontok NEM leteznek tobbe. Ez nem szepseghiba:
  // amig voltak, egy elirt utvonal-szabaly a /pass.txt-t is kiadhatta volna.
  CHECK(g_handlers.count("/style.css#1") == 0, "nincs /style.css útvonal");
  CHECK(g_handlers.count("/favicon.png#1") == 0, "nincs /favicon.png útvonal");

  // A /log viszont működik - épp ilyenkor kell a legjobban.
  AsyncWebServerRequest lg; g_handlers["/log#1"](&lg);
  CHECK(lg._code == 200, "a diagnosztikai napló elérhető");
}


static void scWDT1() {
  coldBoot(true, "TestNet", "pw", "", "");
  setup();
  CHECK(g_wdtEnabled, "a loop task fel van iratkozva a watchdogra");
  CHECK(g_wdtPanic, "trigger_panic = true (alapból csak figyelmeztetne!)");
  CHECK(g_wdtTimeoutMs == 90000, "timeout 90 mp");
  CHECK(g_wdtIdleMask == 0, "az idle taskot NEM figyeltetjük (hurok-veszély)");
  CHECK(logIndex("wdt_reconfigure") >= 0, "a már futó TWDT-t konfiguráltuk újra");
}

static void scWDT2() {
  // A legfontosabb: a 90 mp-es relé pulzus alatt sem maradhat a watchdog etetlen
  coldBoot(true, "TestNet", "pw", "", "");
  setup();
  g_wdtTrack = true; g_wdtLastFeed = g_millis; g_wdtMaxFeedGap = 0;
  int guard = 0;
  while (!reset_device() && ++guard < 200000) {
    resetbutton(); wifiresetbutton(); feedLoopWDT(); delay(10);
  }
  CHECK(guard < 200000, "a reset pulzus lefutott");
  CHECK(g_wdtMaxFeedGap < g_wdtTimeoutMs, "a 90 mp-es pulzus alatt végig etetve volt");
  CHECK(g_wdtMaxFeedGap <= 50, "az etetési köz ~10 ms nagyságrendű");
}

static void scWDT3() {
  // A leghosszabb saját blokkolás: reconnectWifi() 3x20s timeout + 2x20s várakozás
  coldBoot(true, "TestNet", "pw", "", "");
  setup();
  wifiSim.willConnect = false; wifiSim.begun = false;
  g_wdtTrack = true; g_wdtLastFeed = g_millis; g_wdtMaxFeedGap = 0;
  try { reconnectWifi(); } catch (DeepSleepSignal&) {}
  CHECK(g_wdtMaxFeedGap < g_wdtTimeoutMs, "a ~100 mp-es újracsatlakozás alatt is etetve volt");
  CHECK(g_wdtMaxFeedGap <= 50, "etetési köz ~10 ms");
}

static void scWDT4() {
  // A hosszú várakozások delay()-t használnak, nem yield()-pörgetést
  coldBoot(true, "TestNet", "pw", "", "");
  setup();
  g_log.clear();
  const uint32_t t0 = g_millis;
  waitWithButtons(1000);
  CHECK(g_millis - t0 >= 1000, "a várakozás ténylegesen eltelt");
  int feeds = 0;
  for (auto& l : g_log) if (l == "wdt_feed") feeds++;
  CHECK(feeds >= 90 && feeds <= 110, "~100 etetés 1 mp alatt (10 ms-os osztás)");
}


static void scFS1() {
  // Nem csatolható fájlrendszer -> filesystemReady() = false, és végzetes hiba
  // (a részletes viselkedést az FT1 fedi)
  coldBoot(false, "", "", "", "");
  g_fsMountOk = false;
  try { setup(); } catch (DeepSleepSignal&) { CHECK(false, "nem szabadna elaludnia"); }
  CHECK(!filesystemReady(), "a fajlrendszer nem csatolhato");
  CHECK(deviceMode == (DeviceMode)2, "MODE_FATAL - mentés úgysem lenne lehetséges");
  CHECK(g_wdtEnabled, "a watchdog hibajelzés közben is aktív");
}

static void scFS2() {
  // Írásra nem nyitható fájlrendszer
  coldBoot(true, "TestNet", "pw", "", "");
  setup();
  g_fsWritable = false;
  CHECK(!writeConfigValue(LittleFS, "/x.txt", "adat"), "sikertelen megnyitás -> false");
  g_fsWritable = true;
  CHECK(writeConfigValue(LittleFS, "/x.txt", "adat"), "működő FS-en -> true");
}

static void scFS3() {
  // Megtelt fájlrendszer: a rövid írást el kell kapni
  coldBoot(true, "TestNet", "pw", "", "");
  setup();
  g_fs.clear();
  g_fsCapacity = 8;
  CHECK(!writeConfigValue(LittleFS, "/x.txt", "ez tobb mint nyolc bajt"),
        "rövid írás -> false (nem hazudik sikert)");
  CHECK(writeConfigValue(LittleFS, "/x.txt", "rovid"), "ami befér, az sikerül");
  g_fsCapacity = 0;
}

static void scFS4() {
  // A visszaolvasásos ellenőrzés akkor is fog, ha az írás "sikeresnek" tűnt,
  // de a tartalom mégsem került ki (pl. lezáráskori hiba).
  coldBoot(true, "TestNet", "pw", "", "");
  setup();
  CHECK(writeConfigValue(LittleFS, "/v.txt", "helyes"), "normál írás rendben");
  g_fs["/v.txt"] = "serult";   // valaki más elrontja a tartalmat
  CHECK(!fileMatches(LittleFS, "/v.txt", "helyes", 6), "az ellenőrzés kiszúrja az eltérést");
}

static void scFS5() {
  // Törlés: ha a csonkolás nem megy, a fájl törlésére vált
  coldBoot(true, "TestNet", "pw", "", "");
  setup();
  g_fs["/c.txt"] = "valami";
  g_fsWritable = false;          // csonkolni nem lehet
  g_fsRemoveOk = true;           // törölni igen
  CHECK(clearConfigValue(LittleFS, "/c.txt"), "a remove() tartalékra vált");
  CHECK(!g_fs.count("/c.txt"), "a fájl tényleg eltűnt");

  g_fs["/d.txt"] = "valami";
  g_fsRemoveOk = false;          // most semmi sem megy
  CHECK(!clearConfigValue(LittleFS, "/d.txt"), "ha egyik sem megy, false-t ad");
  g_fsWritable = true; g_fsRemoveOk = true;
}

static void scFS6() {
  // Hiányzó és könyvtár-jellegű bemenet olvasáskor
  coldBoot(true, "TestNet", "pw", "", "");
  setup();
  char buf[33];
  memset(buf, 'X', sizeof(buf));
  CHECK(readConfigValue(LittleFS, "/nincs_ilyen.txt", buf, sizeof(buf)) == (ConfigStatus)1, "hiányzó fájl -> CONFIG_MISSING");
  CHECK(buf[0] == '\0', "a buffer akkor is ki lett ürítve");
}


static void scFT1() {
  // Csatolhatatlan fájlrendszer -> végzetes hiba, NEM AP portál
  coldBoot(true, "TestNet", "pw", "", "");
  g_fsMountOk = false;
  setup();
  CHECK(deviceMode == (DeviceMode)2, "MODE_FATAL");
  CHECK(wifiSim.softApCount == 0, "NEM indult AP portál");
  CHECK(wifiSim.beginCount == 0, "meg sem próbált csatlakozni");
  CHECK(g_pinState[PIN_RELAY] == LOW, "a relé LOW - a router kap áramot");
}

static void scFT2() {
  // A fájl létezik, de nem olvasható -> végzetes hiba
  coldBoot(true, "TestNet", "pw", "", "");
  g_fsReadable = false;
  setup();
  CHECK(deviceMode == (DeviceMode)2, "MODE_FATAL");
  CHECK(wifiSim.softApCount == 0, "NEM indult AP portál");
}

static void scFT3() {
  // ELSŐ INDÍTÁS: nincs egyetlen konfig fájl sem -> ez NEM hiba
  coldBoot(false, "", "", "", "");
  g_fs.clear();
  setup();
  CHECK(deviceMode == (DeviceMode)1, "MODE_CONFIG - AP portál, nem hibajelzés");
  CHECK(wifiSim.softApCount == 1, "elindult az AP");
}

static void scFT4() {
  // WIFIRESET UTÁN: a fájlok léteznek, de üresek -> ez sem hiba
  coldBoot(false, "", "", "", "");
  g_fs["/ssid.txt"] = ""; g_fs["/pass.txt"] = "";
  g_fs["/ip.txt"] = "";   g_fs["/gateway.txt"] = "";
  setup();
  CHECK(deviceMode == (DeviceMode)1, "MODE_CONFIG - AP portál, nem hibajelzés");
  CHECK(wifiSim.softApCount == 1, "elindult az AP");
}

static void scFT5() {
  // A villogás: mindkét LED EGYSZERRE, gyorsan
  coldBoot(true, "TestNet", "pw", "", "");
  g_fsMountOk = false;
  setup();
  g_log.clear();
  int toggles = 0;
  const uint32_t t0 = g_millis;
  while (g_millis - t0 < 1000) {
    const int before = g_pinState[6];
    loop();
    if (g_pinState[6] != before) {
      toggles++;
      CHECK(g_pinState[6] == g_pinState[5], "a két LED mindig azonos fázisban");
      if (toggles > 2) break;   // ne árasszuk el a kimenetet
    }
  }
  CHECK(toggles >= 2, "villog (1 mp alatt többször váltott)");

  // periódus ellenőrzése: 100 ms-onként vált -> 1 mp alatt ~10 váltás
  g_pinState[6] = LOW; g_pinState[5] = LOW;
  int t2 = 0;
  const uint32_t t1 = g_millis;
  while (g_millis - t1 < 1000) {
    const int before = g_pinState[6];
    loop();
    if (g_pinState[6] != before) t2++;
  }
  CHECK(t2 >= 8 && t2 <= 12, "~10 váltás másodpercenként (100 ms-os félperiódus)");
}

static void scFT6() {
  // Hibajelzés közben is működjenek a gombok, és NE fusson az állapotgép
  coldBoot(true, "TestNet", "pw", "", "");
  g_fsMountOk = false;
  setup();
  for (int i = 0; i < 50; i++) loop();
  CHECK(pingSim.calls == 0, "nem futott internet teszt");
  CHECK(g_pinState[PIN_RELAY] == LOW, "a relé végig LOW maradt");

  bool restarted = false;
  g_pinRead[3] = LOW;
  try { loop(); g_millis += 100; loop(); }
  catch (RestartSignal&) { restarted = true; }
  CHECK(restarted, "a reset gomb hibajelzés közben is újraindít");
}


static void scFT7() {
  // 5 perc hibajelzés után alvás - IDŐZÍTETT ÉBRESZTÉS NÉLKÜL
  coldBoot(true, "TestNet", "pw", "", "");
  g_fsMountOk = false;
  setup();
  CHECK(deviceMode == (DeviceMode)2, "MODE_FATAL");

  bool slept = false; uint64_t us = 1;
  const uint32_t t0 = g_millis;
  try {
    while (g_millis - t0 < 6u * 60 * 1000) loop();
  } catch (DeepSleepSignal& d) { slept = true; us = d.us; }

  CHECK(slept, "elaludt");
  const uint32_t elapsed = g_millis - t0;
  CHECK(elapsed >= 5u * 60 * 1000, "csak 5 perc után (nem korábban)");
  CHECK(elapsed < 5u * 60 * 1000 + 2000, "és nem sokkal később");
  CHECK(us == 0, "NINCS időzített ébresztés - magától nem ébred fel");
  CHECK(g_gpioWakeMask == (1ULL << 3), "a reset gomb viszont felébreszti");
  CHECK(g_pinState[PIN_RELAY] == LOW, "a relé LOW - a router kap áramot alvás közben is");
  CHECK(logIndex("wakeup_disable_all") < logIndex("DEEP_SLEEP"),
        "előbb minden ébresztőforrást töröltünk");
}

static void scFT8() {
  // Az internet-hiba miatti elalvás (5 sikertelen router reset) TOVÁBBRA IS
  // időzítve ébred - ott a WiFi működik, csak az internet nem.
  coldBoot(true, "TestNet", "pw", "", "");
  setup();
  uint64_t us = 0;
  try {
    for (int c = 0; c < 10; c++) {
      int guard = 0;
      while (!reset_device() && ++guard < 200000) { yield(); }
    }
  } catch (DeepSleepSignal& d) { us = d.us; }
  CHECK(us == 3600ULL * 1000000ULL, "1 órás ébresztés megmaradt az internet-hiba útvonalon");
}


static void scWF1() {
  // Van mentett SSID, de a router nem elérhető: NEM megy azonnal AP módba
  coldBoot(false, "MyNetwork", "titok123", "", "");
  setup();
  CHECK(deviceMode == (DeviceMode)0, "MONITOR mód - kivárja a first start delayt");
  CHECK(wifiSim.softApCount == 0, "nem indult AP portál");
  CHECK(g_pinState[PIN_RELAY] == LOW, "a relé LOW - a router kap áramot");
}

static void scWF2() {
  // Egy teljes kör: 10 perc várakozás + 3 próba + router reset + 10 perc
  // bootolási várakozás + 3 próba, és csak ezután 1 órás alvás
  coldBoot(false, "MyNetwork", "titok123", "", "");
  setup();
  const int beginBefore = wifiSim.beginCount;
  const uint32_t t0 = g_millis;
  bool slept = false; uint64_t us = 0;
  try { while (g_millis - t0 < 20u*60*1000 && deviceMode == (DeviceMode)0) loop(); }
  catch (DeepSleepSignal& d) { slept = true; us = d.us; }
  CHECK(slept, "elaludt (nem AP módba ment)");
  CHECK(us == 3600ULL*1000000ULL, "1 óra múlva magától ébred és újrapróbálja");
  CHECK(rtcRetryRounds == 1, "egy kör elkönyvelve");
  const int begins = wifiSim.beginCount - beginBefore;
  const uint32_t dt = g_millis - t0;
  CHECK(begins >= 6, "megvan a 3 + 3 blokkoló csatlakozási kísérlet");
  // A tobbi begin() az onlineProbe() 60 mp-enkenti ebresztgetese a ket hosszu
  // varakozas alatt. A FELSO KORLAT maga a szerzodes: percenkent legfeljebb
  // egy begin(), tehat sem a radio, sem (a persistent(false) miatt) a flash
  // nem kap tobbet, mint amennyit a dokumentacio iger.
  CHECK(begins <= 6 + (int)(dt / 60000) + 2,
        "a proba percenkent legfeljebb egy begin()-t ad hozza");
  CHECK(logIndex(RELAY_HIGH) >= 0, "a körben lefutott egy router újraindítás");
  CHECK(dt >= 10u*60*1000, "megvárta a 10 perces first start delayt");
  CHECK(dt >= 25u*60*1000, "és a reset + bootolási várakozást is (~25,5 perc)");
  CHECK(dt < 27u*60*1000, "de nem sokkal többet");
}

static void scWF3() {
  // AP mód 5 perc után elalszik, időzített ébresztés nélkül
  coldBoot(false, "", "", "", "");
  setup();
  CHECK(deviceMode == (DeviceMode)1, "AP mód");
  bool slept = false; uint64_t us = 1;
  const uint32_t t0 = g_millis;
  try { while (g_millis - t0 < 8u*60*1000) loop(); }
  catch (DeepSleepSignal& d) { slept = true; us = d.us; }
  CHECK(slept, "elaludt");
  const uint32_t dt = g_millis - t0;
  CHECK(dt >= 5u*60*1000 && dt < 5u*60*1000 + 2000, "pontosan 5 perc után");
  CHECK(us == 0, "NINCS időzített ébresztés");
  CHECK(g_gpioWakeMask == (1ULL << 3), "a reset gomb ébreszti");
}

static void scWF4() {
  // Fájlírás közben SOHA nem alszik el (utolsó pillanatban beírt adatok)
  coldBoot(false, "", "", "", "");
  setup();
  (void)beginConfigWrite();
  bool slept = false;
  const uint32_t t0 = g_millis;
  try { while (g_millis - t0 < 8u*60*1000) loop(); }
  catch (DeepSleepSignal&) { slept = true; }
  CHECK(!slept, "mentés közben NEM aludt el, pedig letelt az 5 perc");
  endConfigWrite();
  try { loop(); } catch (DeepSleepSignal&) { slept = true; }
  CHECK(slept, "a mentés befejeztével viszont elalszik");
}

static void scWF5() {
  // Minden HTTP kérés újraindítja az 5 perces visszaszámlálást
  coldBoot(false, "", "", "", "");
  setup();
  const uint32_t first = apDeadline;
  const uint32_t t0 = g_millis;
  while (g_millis - t0 < 4u*60*1000) loop();
  touchApDeadline();
  CHECK(apDeadline > first, "a kérés kitolta a határidőt");
  bool slept = false;
  const uint32_t t1 = g_millis;
  try { while (g_millis - t1 < 4u*60*1000) loop(); }
  catch (DeepSleepSignal&) { slept = true; }
  CHECK(!slept, "a kérés után újabb teljes időablakot kapott");
}

static void scWF6() {
  // Működés közbeni kapcsolatvesztés: 3 próba, majd AZONNAL router reset
  coldBoot(true, "MyNetwork", "pw", "", "");
  setup();
  loop();  // a firstStart fázis lezárása, innentől valódi monitorozás
  CHECK(deviceMode == (DeviceMode)0, "monitor módban vagyunk");
  const int beginBefore = wifiSim.beginCount;
  wifiSim.willConnect = false; wifiSim.begun = false;   // megszakad a kapcsolat
  g_log.clear();
  int guard = 0;
  try { while (logIndex(RELAY_HIGH) < 0 && ++guard < 200000) loop(); }
  catch (DeepSleepSignal&) {}
  CHECK(wifiSim.beginCount - beginBefore == 3, "3 újrapróbálkozás a reset előtt");
  CHECK(logIndex(RELAY_HIGH) >= 0, "elindult a router újraindítás (relé be)");
}



static void scWD1() {
  // Egy watchdog reset még nem végzetes
  coldBoot(true, "TestNet", "pw", "", "");
  rtcWdtMagic = 0; rtcWdtResets = 0;      // friss bekapcsolás
  g_resetReason = ESP_RST_TASK_WDT;
  setup();
  CHECK(rtcWdtResets == 1, "első watchdog reset elkönyvelve");
  CHECK(deviceMode == (DeviceMode)0, "normálisan fut tovább");
}

static void scWD2() {
  // A 3. watchdog reset után végzetes hibajelzés
  coldBoot(true, "TestNet", "pw", "", "");
  rtcWdtMagic = 0; rtcWdtResets = 0;
  g_resetReason = ESP_RST_TASK_WDT;
  setup();
  CHECK(rtcWdtResets == 1, "1. reset");

  coldBoot(true, "TestNet", "pw", "", "");   // a NOINIT tartalom megmarad
  g_resetReason = ESP_RST_TASK_WDT;
  setup();
  CHECK(rtcWdtResets == 2, "2. reset");

  coldBoot(true, "TestNet", "pw", "", "");
  g_resetReason = ESP_RST_TASK_WDT;
  setup();
  CHECK(deviceMode == (DeviceMode)2, "3. reset -> MODE_FATAL");
  CHECK(wifiSim.softApCount == 0, "nem indult AP portál");
  CHECK(g_pinState[PIN_RELAY] == LOW, "a relé LOW - a router kap áramot");
}

static void scWD3() {
  // A végzetes állapot 5 perc után alszik, időzített ébresztés nélkül
  coldBoot(true, "TestNet", "pw", "", "");
  rtcWdtMagic = 0; rtcWdtResets = 2;       // már volt két reset
  g_resetReason = ESP_RST_TASK_WDT;
  rtcWdtMagic = 0x42415A53UL;              // érvényes számláló
  setup();
  CHECK(deviceMode == (DeviceMode)2, "MODE_FATAL");
  bool slept = false; uint64_t us = 1;
  const uint32_t t0 = g_millis;
  try { while (g_millis - t0 < 8u*60*1000) loop(); }
  catch (DeepSleepSignal& d) { slept = true; us = d.us; }
  CHECK(slept, "elaludt");
  CHECK(us == 0, "NINCS időzített ébresztés - csak gombbal ébred");
  CHECK(g_gpioWakeMask == (1ULL << 3), "a reset gomb ébreszti");
  CHECK(rtcWdtResets == 0, "a számláló nullázva, hogy ébredés után tiszta lap legyen");
}

static void scWD4() {
  // Áramtalanítás / külső reset nullázza a számlálót
  coldBoot(true, "TestNet", "pw", "", "");
  rtcWdtMagic = 0x42415A53UL; rtcWdtResets = 2;
  g_resetReason = ESP_RST_POWERON;
  rtcRetryRounds = 0;
  g_gpioWakeResult = 0;
  setup();
  CHECK(rtcWdtResets == 0, "bekapcsolás -> tiszta lap");
  CHECK(deviceMode == (DeviceMode)0, "normálisan fut");
}

static void scWD5() {
  // Szoftveres újraindítás (reset gomb) NEM számít watchdog hibának,
  // de nem is nulláz - a beragadt hiba így nem tüntethető el véletlenül.
  coldBoot(true, "TestNet", "pw", "", "");
  rtcWdtMagic = 0x42415A53UL; rtcWdtResets = 2;
  g_resetReason = ESP_RST_SW;
  setup();
  CHECK(rtcWdtResets == 2, "szoftveres reset nem növel és nem nulláz");
  CHECK(deviceMode == (DeviceMode)0, "normálisan fut");
}

static void scWD6() {
  // 1 óra hibátlan működés után a számláló nullázódik
  coldBoot(true, "TestNet", "pw", "", "");
  rtcWdtMagic = 0x42415A53UL; rtcWdtResets = 2;
  g_resetReason = ESP_RST_SW;
  g_httpBody = "Microsoft Connect Test";   // a tesztek sikeresek -> egészséges futás
  setup();
  CHECK(rtcWdtResets == 2, "két korábbi reset még számon van tartva");
  // Egy órányi hibátlan futás. Az időt előreugratjuk: a nullázás a loop()
  // elején történik, de a firstStart fázist előbb le kell zárni.
  loop();                       // firstStart lezárása
  g_millis = 61u * 60 * 1000;
  loop();                       // most fut le a nullázás
  CHECK(rtcWdtResets == 0, "1 óra hibátlan működés után nullázódott");
}


static void scE1() {
  // Teljes egészséges ciklus: boot -> teszt -> SUCCESS -> újabb teszt
  coldBoot(true, "TestNet", "pw", "", "");
  g_httpBody = "Microsoft Connect Test";
  setup();
  loop();                                  // firstStart lezárása
  CHECK(deviceMode == (DeviceMode)0, "monitor mód");
  loop();                                  // 1. teszt
  CHECK(currentState == (State)2, "sikeres teszt -> SUCCESS_STATE");
  CHECK(g_pinState[5] == HIGH, "wifi LED világít");
  const uint32_t t0 = g_millis;
  int guard = 0;
  while (currentState == (State)2 && ++guard < 100000) { loop(); g_millis += 10; }
  CHECK(g_millis - t0 >= 60000, "SUCCESS_DELAY teljes 1 perc volt");
  CHECK(g_millis - t0 < 62000, "és nem több");
}

static void scE2() {
  // Internet kiesik, WiFi jó: 4 kör teszt -> router reset -> 10 perc -> vissza
  coldBoot(true, "TestNet", "pw", "", "");
  g_httpBody = "Valami mas";               // minden HTTP teszt bukik
  pingSim.ok = false;                      // a pingek is
  setup();
  loop();
  g_log.clear();
  int guard = 0;
  while (logIndex(RELAY_HIGH) < 0 && ++guard < 300000) { loop(); g_millis += 10; }
  CHECK(guard < 300000, "eljutott a router resetig");
  const int relayOn = logIndex(RELAY_HIGH);
  const int relayOff = logIndex(RELAY_LOW);
  CHECK(relayOn >= 0 && relayOff > relayOn, "relé be, majd ki");
  // a reset után visszatér tesztelni
  guard = 0;
  while (currentState != (State)0 && ++guard < 300000) { loop(); g_millis += 10; }
  CHECK(guard < 300000, "visszatért TESTING_STATE-be a reset után");
  CHECK(deviceMode == (DeviceMode)0, "monitor módban maradt (a WiFi jó volt)");
}

static void scE3() {
  // Router reset után a WiFi sem jön vissza -> AP mód
  coldBoot(true, "TestNet", "pw", "", "");
  setup();
  loop();                                   // firstStart lezárása, monitor mód
  CHECK(deviceMode == (DeviceMode)0, "monitor mód");
  wifiSim.willConnect = false; wifiSim.begun = false;   // elvágjuk a WiFi-t
  g_log.clear();
  int guard = 0;
  bool slept = false;
  try { while (deviceMode == (DeviceMode)0 && ++guard < 500000) { loop(); g_millis += 10; } }
  catch (DeepSleepSignal&) { slept = true; }
  CHECK(slept, "a router reset után sem jött vissza -> alvás és újrapróbálkozás");
  CHECK(deviceMode == (DeviceMode)0, "NEM AP mód (a hálózat csak nem látszik)");
  CHECK(rtcRetryRounds == 1, "egy újrapróbálkozási kör elkönyvelve");
  CHECK(logIndex(RELAY_HIGH) >= 0, "közben lefutott egy router újraindítás");
  CHECK(g_pinState[PIN_RELAY] == LOW, "a relé a végén LOW - a router kap áramot");
}

static void scE4() {
  // startConfigPortal() ismételt hívása nem duplikálja az AP-t
  coldBoot(false, "", "", "", "");
  setup();
  CHECK(wifiSim.softApCount == 1, "egyszer indult");
  startConfigPortal();
  startConfigPortal();
  CHECK(wifiSim.softApCount == 1, "ismételt hívás nem indít újabb AP-t");
}

static void scE5() {
  // Wifireset gomb AP módban: törli a mentett adatokat és újraindít
  coldBoot(false, "RegiHalozat", "regijelszo", "", "");
  setup();   // nem sikerul csatlakozni -> monitor mod, majd handleFirstStart
  g_fs["/ssid.txt"] = "RegiHalozat";
  bool restarted = false;
  g_pinRead[2] = LOW;                      // D0 = GPIO2 wifireset
  try { loop(); g_millis += 100; loop(); }
  catch (RestartSignal&) { restarted = true; }
  CHECK(restarted, "a wifireset gomb újraindított");
  CHECK(g_fs["/ssid.txt"].empty() || !g_fs.count("/ssid.txt"),
        "a mentett SSID törölve lett");
}


// A regisztrált POST handler meghajtása egy hamis kéréssel
static int postConfig(const char* ssidVal, const char* passVal,
                      const char* ipVal, const char* gwVal,
                      std::string* body = nullptr) {
  AsyncWebServerRequest req;
  if (ssidVal) req.addParam("ssid", ssidVal);
  if (passVal) req.addParam("pass", passVal);
  if (ipVal)   req.addParam("ip", ipVal);
  if (gwVal)   req.addParam("gateway", gwVal);
  g_handlers["/#2"](&req);
  if (body) *body = req._body;
  return req._code;
}

static void scP1() {
  // Érvényes mentés: 200, fájlok kiírva, újraindítás beütemezve
  coldBoot(false, "", "", "", "");
  setup();
  CHECK(deviceMode == (DeviceMode)1, "AP mód");
  const int code = postConfig("MyNetwork", "titkosjelszo", "", "");
  CHECK(code == 200, "HTTP 200");
  CHECK(g_fs["/ssid.txt"] == "MyNetwork", "SSID kiírva");
  CHECK(storedPass() == "titkosjelszo", "a jelszó visszaolvasva egyezik");
  CHECK(g_fs["/pass.txt"].find("titkosjelszo") == std::string::npos,
        "de a fájlban NEM szerepel nyílt szöveggel");
  CHECK(g_fs["/ip.txt"].empty(), "üres IP -> DHCP");
  CHECK(restartRequested(), "újraindítás beütemezve");
  CHECK(!configWriteInProgress(), "a mentés jelző visszaállt");
}

static void scP2() {
  // Túl hosszú SSID: NEM szabad sikert jelenteni és NEM szabad újraindulni
  coldBoot(false, "", "", "", "");
  setup();
  std::string body;
  const char* longSsid = "012345678901234567890123456789012345";  // 36 karakter
  const int code = postConfig(longSsid, "jelszo", "", "", &body);
  CHECK(code == 500, "HTTP 500 - nem hazudik sikert");
  CHECK(!restartRequested(), "NEM indul újra, az adatok nem vesznek el");
  CHECK(body.find("SSID") != std::string::npos, "a válasz megnevezi az okot");
}

static void scP3() {
  // Hiányzó SSID: szintén hiba
  coldBoot(false, "", "", "", "");
  setup();
  const int code = postConfig(nullptr, "jelszo", "", "");
  CHECK(code == 500, "HTTP 500 hiányzó SSID esetén");
  CHECK(!restartRequested(), "nem indul újra");
}

static void scP4() {
  // Érvénytelen IP formátum. A mentés két fázisú: hibás mezőnél az ELŐTTE
  // álló érvényes mezők SEM íródnak ki - különben fél-új, fél-régi
  // konfiguráció maradna a flashben.
  coldBoot(false, "", "", "", "");
  setup();
  std::string body;
  const int code = postConfig("MyNetwork", "jelszo", "nem-ip-cim", "", &body);
  CHECK(code == 500, "HTTP 500 rossz IP esetén");
  CHECK(!restartRequested(), "nem indul újra");
  CHECK(body.find("IP") != std::string::npos, "a válasz megnevezi az okot");
  CHECK(!g_fs.count("/ssid.txt") && !g_fs.count("/pass.txt"),
        "az érvényes SSID/jelszó SEM íródott ki (két fázisú mentés)");
  CHECK(ssid[0] == '\0', "a futó konfiguráció (globálisok) is érintetlen");
}

static void scP5() {
  // Írásra képtelen fájlrendszer: 500, nincs újraindulás
  coldBoot(false, "", "", "", "");
  setup();
  g_fsWritable = false;
  const int code = postConfig("MyNetwork", "jelszo", "", "");
  CHECK(code == 500, "HTTP 500 írási hiba esetén");
  CHECK(!restartRequested(), "nem indul újra");
  g_fsWritable = true;
}

static void scP6() {
  // Statikus IP mentése, és a jelszó nem szivárog ki
  coldBoot(false, "", "", "", "");
  setup();
  std::string body;
  const int code = postConfig("MyNetwork", "SzuperTitok", "192.168.1.200",
                              "192.168.1.1", &body);
  CHECK(code == 200, "HTTP 200");
  CHECK(g_fs["/ip.txt"] == "192.168.1.200", "statikus IP kiírva");
  CHECK(g_fs["/gateway.txt"] == "192.168.1.1", "gateway kiírva");
  CHECK(body.find("SzuperTitok") == std::string::npos,
        "a jelszó NEM jelenik meg a válaszban");
  CHECK(body.find("192.168.1.200") != std::string::npos,
        "az IP viszont igen, hogy tudja hova menjen");
}

static void scP7() {
  // A GET oldal kiszolgálása és a határidő kitolása
  coldBoot(false, "", "", "", "");
  setup();
  const uint32_t before = apDeadline;
  g_millis += 60000;
  AsyncWebServerRequest req;
  g_handlers["/#1"](&req);                      // HTTP_GET "/"
  CHECK(req._code == 200, "a beállító oldal kiszolgálva");
  CHECK(apDeadline > before, "a kérés kitolta az 5 perces határidőt");
}


static void scCPU1() {
  // A loop() a várakozó állapotokban átadja a CPU-t (delay), nem pörög.
  // Enélkül a SUCCESS_STATE 1 percig 100%-on járatná a processzort.
  coldBoot(true, "TestNet", "pw", "", "");
  g_httpBody = "Microsoft Connect Test";
  setup();
  loop();                       // firstStart lezárása
  loop();                       // teszt -> SUCCESS_STATE
  CHECK(currentState == (State)2, "SUCCESS_STATE");
  const uint32_t before = g_millis;
  loop();
  CHECK(g_millis > before, "a loop() ténylegesen várakozik (delay), nem pörög");
  CHECK(g_millis - before <= 20, "de csak ~10 ms-ot, a válaszkészség megmarad");
}

static void scCPU2() {
  // A 10 perces first start várakozás alatt sem pörög
  coldBoot(false, "MyNetwork", "pw", "", "");
  setup();
  CHECK(deviceMode == (DeviceMode)0, "monitor mód, first start várakozás");
  const uint32_t before = g_millis;
  loop();
  CHECK(g_millis > before, "a várakozás delay-jel megy");
  CHECK(g_millis - before <= 20, "10 ms-os szemcsézettség");
}


static void scX1() {
  // Reset gomb megnyomása a 90 mp-es relé pulzus KÖZBEN.
  // A router ilyenkor áram nélkül van - az újraindulásnak vissza kell adnia.
  coldBoot(true, "TestNet", "pw", "", "");
  setup();
  bool restarted = false;
  int guard = 0;
  try {
    // elindítjuk a resetet, majd a pulzus alatt lenyomjuk a gombot
    while (!reset_device() && ++guard < 200000) {
      if (guard == 50) g_pinRead[3] = LOW;      // D1 lenyomva
      resetbutton(); wifiresetbutton(); delay(10);
    }
  } catch (RestartSignal&) { restarted = true; }
  CHECK(restarted, "a gomb újraindított a pulzus közben");
  CHECK(g_pinState[PIN_RELAY] == HIGH, "a relé ekkor még HIGH volt (router áram nélkül)");
  // az újraindulás után a setup() azonnal áramot ad a routernek
  g_pinRead[3] = HIGH;
  coldBoot(true, "TestNet", "pw", "", "");
  setup();
  CHECK(g_pinState[PIN_RELAY] == LOW, "az újraindulás után a relé LOW - a router kap áramot");
}

static void scX2() {
  // Nyílt hálózat: üres jelszó érvényes
  coldBoot(false, "", "", "", "");
  setup();
  AsyncWebServerRequest req;
  req.addParam("ssid", "NyiltHalozat");
  req.addParam("pass", "");
  req.addParam("ip", ""); req.addParam("gateway", "");
  g_handlers["/#2"](&req);
  CHECK(req._code == 200, "üres jelszó elfogadva (nyílt hálózat)");
  CHECK(g_fs["/ssid.txt"] == "NyiltHalozat", "SSID mentve");
  CHECK(g_fs.count("/pass.txt") && storedPass().empty(), "üres jelszó mentve");
}

static void scX3() {
  // Határértékek: pontosan 32 karakteres SSID és 63 karakteres jelszó
  coldBoot(false, "", "", "", "");
  setup();
  std::string s32(32, 'A'), s63(63, 'B');
  const int code = postConfig(s32.c_str(), s63.c_str(), "", "");
  CHECK(code == 200, "a pontos maximum még elfogadott");
  CHECK(g_fs["/ssid.txt"].size() == 32, "32 karakteres SSID hiánytalanul mentve");
  CHECK(storedPass().size() == 63, "63 karakteres jelszó hiánytalanul mentve");

  // egy karakterrel több már nem
  coldBoot(false, "", "", "", "");
  setup();
  std::string s33(33, 'A');
  CHECK(postConfig(s33.c_str(), "pw", "", "") == 500, "33 karakter már elutasítva");
}

static void scX4() {
  // Fél-konfigurált statikus IP: van IP, nincs gateway -> DHCP-re esik vissza
  coldBoot(true, "TestNet", "pw", "192.168.1.200", "");
  setup();
  CHECK(deviceMode == (DeviceMode)0, "csatlakozott");
  CHECK(wifiSim.configCount == 0, "nem alkalmazott hiányos statikus configot");
  CHECK(!wifiSim.staticApplied, "DHCP-t használ");
}

static void scX5() {
  // Csak whitespace-t tartalmazó konfig fájl -> nincs érték, AP mód
  coldBoot(false, "", "", "", "");
  g_fs["/ssid.txt"] = "   \r\n";
  g_fs["/pass.txt"] = "";
  setup();
  CHECK(ssid[0] == '\0', "a whitespace levágás után üres az SSID");
  CHECK(deviceMode == (DeviceMode)1, "AP mód, nem végzetes hiba");
}

static void scX6() {
  // Sikertelen mentés után is kitolódik az AP határidő (van idő újrapróbálni)
  coldBoot(false, "", "", "", "");
  setup();
  g_millis += 4u * 60 * 1000;                 // majdnem lejárt
  const uint32_t before = apDeadline;
  postConfig("Halozat", "pw", "rossz-ip", "");   // validáció bukik
  CHECK(apDeadline > before, "a sikertelen mentés is kitolta a határidőt");
  bool slept = false;
  const uint32_t t0 = g_millis;
  try { while (g_millis - t0 < 4u*60*1000) loop(); }
  catch (DeepSleepSignal&) { slept = true; }
  CHECK(!slept, "van ideje kijavítani az adatokat");
}


// A router X perc mulva jelenik meg. Visszaadja: sikerult-e csatlakozni,
// es hany perc mulva dolt el a dolog.
static bool routerAppearsAt(uint32_t appearMs, uint32_t* decidedAtMs) {
  coldBoot(false, "MyNetwork", "titok123", "", "");
  // A rádió maga tudja, mikortól elérhető a hálózat - így a blokkoló
  // hívásokon belül is helyesen viselkedik.
  wifiSim.willConnect = true;
  wifiSim.availableFrom = appearMs;
  g_serialLog.clear();
  setup();
  int guard = 0;
  bool slept = false;
  try {
    while (++guard < 2000000) {
      if (deviceMode != (DeviceMode)0) break;                 // AP modba ment
      if (serialHas("Beginning Test.")) break;   // elkezdett monitorozni
      loop();
    }
  } catch (DeepSleepSignal&) { slept = true; }
  *decidedAtMs = g_millis;
  return !slept && deviceMode == (DeviceMode)0 && WiFi.status() == WL_CONNECTED;
}

static void scPO1() {
  // ÁRAMSZÜNET: a router 8 perc mulva all fel -> az eszkoznek ki kell varnia
  uint32_t at = 0;
  const bool ok = routerAppearsAt(8u * 60 * 1000, &at);
  printf("     [info] dontes %u perckor\n", at / 60000);
  CHECK(ok, "8 perces router indulást kivár és csatlakozik");
  CHECK(deviceMode == (DeviceMode)0, "monitor módban működik tovább");
}

static void scPO2() {
  // A router csak 11 perc mulva all fel - a first start delay alatt nem, de az
  // ezt koveto 3 probalkozas alatt igen
  uint32_t at = 0;
  const bool ok = routerAppearsAt(11u * 60 * 1000, &at);
  printf("     [info] dontes %u perckor\n", at / 60000);
  CHECK(ok, "11 percnél is elkapja az újrapróbálkozási ablakban");
}

static void scPO3() {
  // A router 20 perc mulva all fel - ez mar tul keso, AP modba megy
  uint32_t at = 0;
  bool ok = false;
  try { ok = routerAppearsAt(20u * 60 * 1000, &at); } catch (DeepSleepSignal&) {}
  printf("     [info] dontes %u perckor, mode=%d\n", at / 60000, (int)deviceMode);
  // A router reset utani bootolasi varakozas (10 perc) atnyulik a 20 percen,
  // igy az ezt koveto probalkozas mar elkapja - meg az ELSO korben.
  CHECK(ok, "a router reset utani próbálkozás elkapja, még az első körben");
  CHECK(deviceMode == (DeviceMode)0, "monitor módban működik tovább");
}


static void scR1() {
  // Rossz jelszó (hitelesítési hiba) -> AZONNAL AP mód, nem 2 nap várakozás.
  // authFail, nem failStatus: a core az elso disconnect-nel meg nem ad
  // WL_CONNECT_FAILED-et (STA.cpp:148), tehat a hu modell szigorubb.
  coldBoot(false, "MyNetwork", "rosszjelszo", "", "");
  wifiSim.authFail = true;
  setup();
  g_log.clear();
  bool slept = false;
  const uint32_t t0 = g_millis;
  try { while (g_millis - t0 < 20u*60*1000 && deviceMode == (DeviceMode)0) loop(); }
  catch (DeepSleepSignal&) { slept = true; }
  CHECK(!slept, "nem aludt el");
  CHECK(deviceMode == (DeviceMode)1, "AP beállító módba ment");
  CHECK(rtcRetryRounds == 0, "nem számolt újrapróbálkozási kört");
  CHECK(logIndex(RELAY_HIGH) < 0, "rossz jelszónál NEM indítja újra a routert");
  // A setup() egyetlen probat tesz; a dontes csak a handleFirstStart() utani
  // 3 probat kovetoen szuletik meg. Ez nem veletlen: a core az elso disconnect
  // esemenynel meg WL_DISCONNECTED-et ad (STA.cpp:148), tehat EGYETLEN
  // probalkozasbol a rossz jelszo felismerhetetlen lenne.
  printf("     [info] csatlakozasi probalkozasok az AP modig: %d\n", wifiSim.beginCount);
  CHECK(wifiSim.beginCount >= 2, "egynel tobb probalkozas kellett a felismereshez");
}

// A rossz jelszo felismerese a core egy nem dokumentalt reszletetol fugg:
// az ELSO disconnect esemenynel a status meg WL_DISCONNECTED (STA.cpp:148,
// "AUTH_FAIL && !first_connect"), es csak a masodiktol WL_CONNECT_FAILED.
// Ezert nem eleg egyetlen probalkozas - ezt a fuggest rogziti ez az eset,
// hogy egy kesobbi "eleg egy proba is" egyszerusites ne csuszhasson at.
static void scR5() {
  coldBoot(false, "MyNetwork", "rosszjelszo", "", "");
  wifiSim.authFail = true;
  WiFi.begin("MyNetwork", "rosszjelszo");
  CHECK(WiFi.status() != WL_CONNECT_FAILED,
        "egyetlen probalkozas utan a rossz jelszo meg lathatatlan");
  WiFi.begin("MyNetwork", "rosszjelszo");
  CHECK(WiFi.status() == WL_CONNECT_FAILED,
        "a masodik probalkozastol viszont megkulonboztetheto");
}

// A README/MUKODES konkret szamot igér az ujraprobalkozasi korre: 25,5 perc
// ebren + 60 perc alvas = 85,5 perc, es 33 kor = 47 ora. Az ebren toltott reszt
// meg lehet merni - ha barmelyik idozites elmozdul, ez a teszt bukik, nem a
// dokumentacio rohad el csendben.
static void scR6() {
  coldBoot(false, "MyNetwork", "titok123", "", "");   // a halozat nincs ott
  setup();
  const uint32_t t0 = 0;                              // a boot a 0. ms
  bool slept = false;
  try { while (g_millis < 3u*60*60*1000) loop(); }
  catch (DeepSleepSignal&) { slept = true; }
  const uint32_t awake = g_millis - t0;
  printf("     [info] boot -> deep sleep: %.1f perc\n", awake/60000.0);
  CHECK(slept, "egy ora alvasra ment, nem AP modba");
  CHECK(awake > 25u*60*1000 && awake < 26u*60*1000,
        "az ebren toltott resz 25 es 26 perc kozott van (a doksi 25,5-ot ir)");
}

// A doksi ket konkret felismerelesi idot igér: 123 mp, ha a nevek feloldodnak
// es csak a szerverek hallgatnak (5 x 15 mp + 4 x 12 mp), es 213 mp halott DNS
// mellett (5 x 33 mp + 4 x 12 mp). Meressel ellenorizzuk, kulonben az elso
// idozites-valtoztatasnal a README csendben hazudni kezdene.
//
// A relet NEM a g_log-bol figyeljuk: a reset_device() a 90 mp-es pulzust
// blokkolva futtatja le, tehat mire a ciklus visszakapja a vezerlest, a
// szimulalt ora mar 90 mp-cel tovabb jar. A soros napló "Uptime: XhYmZs" sorai
// viszont pontosan azt a pillanatot rogzitik, amikor a dontes megszuletett.
static int uptimeSecAt(size_t idx) {
  // a legkozelebbi MEGELOZO "Uptime: 0h 2m 4s" sor masodpercben
  for (size_t i = idx + 1; i-- > 0;) {
    int h, m, sec;
    if (sscanf(g_serialLog[i].c_str(), "Uptime: %dh %dm %ds", &h, &m, &sec) == 3) {
      return h * 3600 + m * 60 + sec;
    }
    if (i == 0) break;
  }
  return -1;
}

static void scR7() {
  auto merd = [](uint32_t failMs) -> int {
    coldBoot(true, "MyNetwork", "titok123", "", "");
    setup();
    loop();                       // a firstStart lezarasa
    g_httpCode = -1;              // innentol minden teszt bukik
    g_httpFailMs = failMs;
    g_serialLog.clear(); g_log.clear();
    int guard = 0;
    try { while (logIndex(RELAY_HIGH) < 0 && ++guard < 500000) loop(); }
    catch (DeepSleepSignal&) {}
    g_httpFailMs = 15000; g_httpCode = 200;
    const int elsoTeszt = serialIndex("Beginning Test.");
    const int reset     = serialIndex("Beginning Reset in FAILURE_STATE.");
    if (elsoTeszt < 0 || reset < 0) return -1;
    return uptimeSecAt((size_t)reset) - uptimeSecAt((size_t)elsoTeszt);
  };
  const int elo = merd(15000);
  printf("     [info] elo DNS, hallgato szerver: %d mp\n", elo);
  CHECK(elo >= 121 && elo <= 125, "elo DNS mellett 123 mp (a doksi szama)");
  const int halott = merd(33000);
  printf("     [info] halott DNS: %d mp\n", halott);
  CHECK(halott >= 211 && halott <= 215, "halott DNS mellett 213 mp");
}

// Hany teljes kort var ki az eszkoz, mielott feladja? A doksi 33 kort ir es
// ebbol 47 orat szamol - de a wifiGiveUp() ELOSZOR novel, AZTAN ellenoriz,
// tehat az UTOLSO kor mar nem alszik egyet. Ezt vegigjatsszuk.
static void scR8() {
  int alvasok = 0, korok = 0;
  bool apMod = false;
  for (int i = 0; i < 40 && !apMod; i++) {
    coldBoot(false, "MyNetwork", "titok123", "", "", 500, i > 0);
    korok++;
    bool slept = false;
    try { setup(); while (g_millis < 3u*60*60*1000 && deviceMode == (DeviceMode)0) loop(); }
    catch (DeepSleepSignal&) { slept = true; }
    if (slept) alvasok++;
    if (deviceMode == (DeviceMode)1) apMod = true;
  }
  printf("     [info] %d kor, ebbol %d alvassal; AP mod: %s\n",
         korok, alvasok, apMod ? "igen" : "nem");
  const double oraban = (korok * 25.5 + alvasok * 60.0) / 60.0;
  printf("     [info] osszes turelem: %d x 25,5 perc + %d x 60 perc = %.1f ora\n",
         korok, alvasok, oraban);
  CHECK(apMod, "vegul AP beallito modba ment");
  CHECK(korok == 33, "pontosan 33 kort probalt");
  CHECK(alvasok == 32, "de csak 32-szer aludt: az utolso kor mar nem alszik");
  CHECK(oraban > 45.5 && oraban < 46.5, "a tenyleges turelem ~46 ora, nem 47");
}

static void scR2() {
  // A 40. kör után feladja és AP módba megy (2 nap)
  coldBoot(false, "MyNetwork", "titok123", "", "");
  rtcRetryRounds = 32;                      // az utolsó kör előtt vagyunk
  setup();
  bool slept = false;
  const uint32_t t0 = g_millis;
  try { while (g_millis - t0 < 20u*60*1000 && deviceMode == (DeviceMode)0) loop(); }
  catch (DeepSleepSignal&) { slept = true; }
  CHECK(!slept, "a 33. körnél már nem alszik el");
  CHECK(deviceMode == (DeviceMode)1, "AP beállító mód");
  CHECK(rtcRetryRounds == 0, "a számláló nullázva a következő ciklushoz");
}

static void scR3() {
  // A kör hossza tizedpercben, hogy a 90 mp-es pulzus is beleférjen
  const uint32_t roundTenths = 100   // 10,0 perc firstStartDelay
                             + 20    //  2,0 perc 3 próba
                             + 15    //  1,5 perc RESET_PULSE
                             + 100   // 10,0 perc RESET_DELAY
                             + 20    //  2,0 perc újabb 3 próba
                             + 600;  // 60,0 perc alvás
  CHECK(roundTenths == 855, "egy kör 85,5 perc");
  CHECK(33u * roundTenths == 28215u, "33 kör = 2821,5 perc");
  CHECK(28215u < 48u * 60u * 10u, "és ez kevesebb, mint 2 nap (28800 tizedperc)");
  CHECK(34u * roundTenths > 48u * 60u * 10u, "34 kör viszont már túllépné");
}

static void scR4() {
  // Sikeres csatlakozás nullázza a 2 napos ablakot
  coldBoot(true, "MyNetwork", "titok123", "", "");
  rtcRetryRounds = 17;
  setup();
  CHECK(deviceMode == (DeviceMode)0, "csatlakozott");
  CHECK(rtcRetryRounds == 0, "új 2 napos ablak indul");
}

static void scL1() {
  // Az eseménynapló rögzít és a /log oldal kiírja
  coldBoot(false, "", "", "", "");
  rtcEvMagic = 0; rtcEvNext = 0;
  setup();
  CHECK(rtcEvNext > 0, "rögzített eseményt");

  AsyncWebServerRequest req;
  g_handlers["/log#1"](&req);
  CHECK(req._code == 200, "a /log oldal kiszolgálva");
  CHECK(req._body.find("BOOT") != std::string::npos, "a BOOT esemény megjelenik");
  CHECK(req._body.find("Ujraprobalkozasi korok") != std::string::npos,
        "a kör számláló látszik");
  CHECK(req._body.find("Watchdog ujraindulasok") != std::string::npos,
        "a watchdog számláló látszik");
}

static void scL2() {
  // A napló túléli az újraindulást és a körpuffer nem csordul túl
  coldBoot(false, "", "", "", "");
  rtcEvMagic = 0; rtcEvNext = 0;
  setup();
  const uint32_t afterFirst = rtcEvNext;
  CHECK(afterFirst > 0, "első boot rögzítve");

  for (int i = 0; i < 50; i++) logEvent((EventCode)EV_TEST_FAIL_C, (uint16_t)i);
  CHECK(rtcEvNext == afterFirst + 50, "minden esemény számolva");

  AsyncWebServerRequest req;
  g_handlers["/log#1"](&req);
  CHECK(req._code == 200, "a /log továbbra is működik túlcsordulás után");
  // csak az utolsó 32 fér el
  CHECK(req._body.find(">TEST FAIL<") != std::string::npos, "a friss események láthatók");
  // Pontosan táblázatcellára illesztünk: a "BOOT" szó a magyarázó
  // szövegben is szerepel az oldalon.
  // A REGI BOOT KISZORULT A GYURUBOL - de a fajl megorizte. Ez a valtozas
  // lenyege: korabban itt egyszeruen elveszett volna.
  CHECK(req._body.find("<td>fajl</td>") != std::string::npos,
        "a lap a mentett fajl sorait is mutatja");
  CHECK(rtcEvNext > EVLOG_SIZE_C, "az RTC gyuru tenyleg tulcsordult");
  CHECK(req._body.find(">BOOT<") != std::string::npos,
        "a régi BOOT már kicsúszott a körpufferből");
}

static void scL3() {
  // A végzetes hiba oka is bekerül a naplóba
  coldBoot(true, "TestNet", "pw", "", "");
  rtcEvMagic = 0; rtcEvNext = 0;
  g_fsMountOk = false;
  setup();
  CHECK(deviceMode == (DeviceMode)2, "MODE_FATAL");
  bool found = false;
  for (uint32_t i = 0; i < rtcEvNext && i < 32; i++) {
    if (rtcEvents[i].code == EV_FATAL_C && rtcEvents[i].param == 1) found = true;
  }
  CHECK(found, "a FATAL esemény a LittleFS okkal (param=1) rögzítve");
}


static void scSB1() {
  // Beragadt RESET gomb -> 60 mp alvas, gombebresztes nelkul
  coldBoot(true, "TestNet", "pw", "", "");
  g_pinRead[3] = LOW;                       // D1 = GPIO3
  bool slept = false; uint64_t us = 0;
  try { setup(); } catch (DeepSleepSignal& d) { slept = true; us = d.us; }
  CHECK(slept, "elaludt");
  CHECK(us == 60ULL * 1000000ULL, "60 másodperces ébresztés");
  CHECK(g_gpioWakeMask == 0, "gomb-ébresztés NINCS armolva (boot loop ellen)");
  CHECK(g_pinState[PIN_RELAY] == LOW, "a relé LOW - a router kap áramot");
}

static void scSB2() {
  // Beragadt WIFIRESET gomb -> ugyanaz a kezeles
  coldBoot(true, "TestNet", "pw", "", "");
  g_pinRead[2] = LOW;                       // D0 = GPIO2
  bool slept = false; uint64_t us = 0;
  try { setup(); } catch (DeepSleepSignal& d) { slept = true; us = d.us; }
  CHECK(slept, "a wifireset gomb beragadását is elkapja");
  CHECK(us == 60ULL * 1000000ULL, "60 másodperces ébresztés");
  CHECK(g_gpioWakeMask == 0, "gomb-ébresztés NINCS armolva");
}

static void scSB3() {
  // A ket LED FELVALTVA villog (ellentetes fazis) - ez kulonbozteti meg a
  // vegzetes hibatol, ahol egyszerre villognak.
  coldBoot(true, "TestNet", "pw", "", "");
  g_pinRead[3] = LOW;
  g_log.clear();
  try { setup(); } catch (DeepSleepSignal&) {}

  // A firmware egymas utan irja a ket labat, ezert a naplo szomszedos parjait
  // nezzuk: a valtakozo mintat a "led BE + wifiled KI" es a forditottja adja.
  int alternating = 0, simultaneous = 0;
  for (size_t i = 0; i + 1 < g_log.size(); i++) {
    if (g_log[i] == "pin6=HIGH" && g_log[i+1] == "pin5=LOW") alternating++;
    else if (g_log[i] == "pin6=LOW" && g_log[i+1] == "pin5=HIGH") alternating++;
    else if (g_log[i] == "pin6=HIGH" && g_log[i+1] == "pin5=HIGH") simultaneous++;
    else if (g_log[i] == "pin6=LOW" && g_log[i+1] == "pin5=LOW") simultaneous++;
  }
  printf("     [info] valtakozo par: %d, egyutt-villogo par: %d\n",
         alternating, simultaneous);
  CHECK(alternating >= 10, "sokszor váltottak FELVÁLTVA (ellentétes fázis)");
  CHECK(simultaneous == 0, "egyszer sem villogtak EGYÜTT (az a végzetes hiba jele)");
  CHECK(g_pinState[6] == LOW && g_pinState[5] == LOW, "alvás előtt mindkettő lekapcsolva");
}

static void scSB4() {
  // A beragadt gomb bekerul a diagnosztikai naploba
  coldBoot(true, "TestNet", "pw", "", "");
  rtcEvMagic = 0; rtcEvNext = 0;
  g_pinRead[2] = LOW;                       // wifireset
  try { setup(); } catch (DeepSleepSignal&) {}
  bool found = false, bootLogged = false;
  for (uint32_t i = 0; i < rtcEvNext && i < 32; i++) {
    if (rtcEvents[i].code == 11 && rtcEvents[i].param == 1) found = true;
    if (rtcEvents[i].code == 1) bootLogged = true;
  }
  CHECK(bootLogged, "a BOOT esemény is bekerült (a gombellenőrzés előtt)");
  CHECK(found, "STUCK BUTTON esemény a wifireset gombbal (param=1)");
}


static void scWDT5() {
  // A setup() blokkoló ciklusai a watchdog bekapcsolása ELŐTT futnak.
  // Ott nem szabad etetni: a task még nincs feliratkozva, az
  // esp_task_wdt_reset() ESP_ERR_NOT_FOUND-ot ad, amire a core log_e()-t hív.
  // Egy sikertelen indulási csatlakozás 20 mp-e ~2000 hibasort jelentene.
  coldBoot(false, "MyNetwork", "pw", "", "");   // nem sikerül csatlakozni
  g_wdtFeedBeforeEnable = 0;
  setup();
  printf("     [info] etetes a feliratkozas elott: %u\n",
         (unsigned)g_wdtFeedBeforeEnable);
  CHECK(g_wdtEnabled, "a watchdog bekapcsolt a setup() végén");
  CHECK(g_wdtFeedBeforeEnable == 0,
        "a feliratkozás ELŐTT egyszer sem etettünk");
}


static void scSN1() {
  // Ha a gomb-ébresztés armolása HIBÁZIK (pl. valaki nem RTC-képes lábra tette
  // a gombot), az időzítő nélküli alvás örökre elérhetetlenné tenné az eszközt.
  // Ilyenkor biztonsági hálóként mégis armolunk egy hosszú időzítőt.
  coldBoot(true, "TestNet", "pw", "", "");
  g_fsMountOk = false;                  // -> MODE_FATAL
  g_gpioWakeResult = -1;                // az armolás elbukik
  setup();
  CHECK(deviceMode == (DeviceMode)2, "MODE_FATAL");
  bool slept = false; uint64_t us = 1;
  const uint32_t t0 = g_millis;
  try { while (g_millis - t0 < 8u*60*1000) loop(); }
  catch (DeepSleepSignal& d) { slept = true; us = d.us; }
  CHECK(slept, "elaludt");
  CHECK(g_gpioWakeMask == 0, "a gomb-ébresztés tényleg nem armolódott");
  CHECK(us == 3600ULL*1000000ULL,
        "helyette 1 órás időzítő - az eszköz nem válik elérhetetlenné");
}

static void scSN2() {
  // Ha az armolás sikerül, marad az eredeti viselkedés: NINCS időzítő
  coldBoot(true, "TestNet", "pw", "", "");
  g_fsMountOk = false;
  setup();
  bool slept = false; uint64_t us = 1;
  const uint32_t t0 = g_millis;
  try { while (g_millis - t0 < 8u*60*1000) loop(); }
  catch (DeepSleepSignal& d) { slept = true; us = d.us; }
  CHECK(slept, "elaludt");
  CHECK(g_gpioWakeMask == (1ULL << 3), "gomb-ébresztés armolva");
  CHECK(us == 0, "és NINCS időzített ébresztés");
}


// Hany soros sor keletkezett a megadott szimulalt ido alatt?
static uint32_t serialLinesPerMinute(uint32_t durMs) {
  const size_t before = g_serialLog.size();
  const uint32_t t0 = g_millis;
  int guard = 0;
  try { while (g_millis - t0 < durMs && ++guard < 3000000) loop(); }
  catch (DeepSleepSignal&) {} catch (RestartSignal&) {}
  const uint32_t mins = (g_millis - t0) / 60000;
  return mins ? (uint32_t)((g_serialLog.size() - before) / mins) : 0;
}

static void scSER1() {
  // Normal mukodes: a soros kimenet ne arassza el a konzolt
  coldBoot(true, "TestNet", "pw", "", "");
  g_httpBody = "Microsoft Connect Test";
  setup();
  loop();
  const uint32_t lpm = serialLinesPerMinute(30u * 60 * 1000);
  printf("     [info] %u sor/perc\n", lpm);
  CHECK(lpm <= 30, "normál működésben max ~30 sor/perc");
  CHECK(lpm > 0, "de azért ír valamit (nem néma)");
}

static void scSER2() {
  // Internet kiesett: a hibasorozat se generaljon aradatot
  coldBoot(true, "TestNet", "pw", "", "");
  g_httpBody = "Rossz"; pingSim.ok = false;
  setup();
  loop();
  const uint32_t lpm = serialLinesPerMinute(30u * 60 * 1000);
  printf("     [info] %u sor/perc\n", lpm);
  CHECK(lpm <= 30, "internet kiesésnél is max ~30 sor/perc");
}

// SER3 segedje: hany olyan sort irt a loop, ami NEM a ritkitott heap-allapot?
static size_t nemHeapSorok(size_t from) {
  size_t n = 0;
  for (size_t i = from; i < g_serialLog.size(); i++) {
    const std::string& l = g_serialLog[i];
    if (l.find("Heap: szabad") != std::string::npos) continue;
    if (l.find("Uptime:") != std::string::npos) continue;   // a heap sor fejlece
    n++;
  }
  return n;
}

static void scSER3() {
  // AP mod es hibajelzo mod: a villogo ciklus ne irjon semmit.
  //
  // A KOVETELMENY PONTOSITVA. Korabban ez "egyetlen sort sem" volt. A heap
  // felugyelet bevezetesevel ez mar nem igaz - es SZANDEKOSAN nem: a heap
  // allapotsora minden uzemmodban kimegy, mert epp ott kell a diagnosztika,
  // ahol baj van (az AP modban fut a webszerver, ami a legtobbet allokal).
  //
  // Amit viszont TOVABBRA IS garantalunk, es ami a teszt valodi lenyege volt:
  // a villogo ciklus SEMMIT nem ir KORONKENT. Az egyetlen kivetel a
  // ritkitott, felorankenti heap-sor - a merese alabb kulon szerepel.
  coldBoot(false, "", "", "", "");
  setup();
  const size_t before = g_serialLog.size();
  const uint32_t t0 = g_millis;
  try { while (g_millis - t0 < 4u*60*1000) loop(); } catch (DeepSleepSignal&) {}
  CHECK(nemHeapSorok(before) == 0,
        "AP módban a loop() a heap-soron kívül egy sort sem ír");
  { const uint32_t lpm = (uint32_t)((g_serialLog.size() - before) * 60000
                                    / (g_millis - t0 ? g_millis - t0 : 1));
    printf("     [info] AP mod: %u sor/perc\n", lpm);
    CHECK(lpm <= 1, "és a teljes kimenet is legfeljebb 1 sor/perc"); }

  coldBoot(true, "TestNet", "pw", "", "");
  g_fsMountOk = false;
  setup();
  const size_t before2 = g_serialLog.size();
  const uint32_t t1 = g_millis;
  try { while (g_millis - t1 < 4u*60*1000) loop(); } catch (DeepSleepSignal&) {}
  CHECK(nemHeapSorok(before2) == 0,
        "hibajelző módban sem ír a villogó ciklus a heap-soron kívül");
}

// SER8 segedje: a heap a figyelmeztetesi kuszob KORUL ingadozik.
static uint32_t ser8Fazis = 0;
static void ser8Hook() {
  // 20 mp-enkent vult a kuszob ala es fole - gyorsabban, mint a 10 mp-es
  // mintaveteli koz, tehat minden meres masik oldalon talalja.
  const bool alacsony = ((g_millis / 20000) % 2) == 0;
  g_freeHeap = alacsony ? 20000 : 40000;
  g_maxAllocHeap = g_freeHeap;
  ser8Fazis++;
}

static void scSER8() {
  // ELLENSEGES ESET: A HEAP A KUSZOB KORUL INGADOZIK.
  //
  // A figyelmeztetes csak ATLEPESKOR szol, es a visszaallashoz 10% tartalek
  // kell - de mi van, ha a heap ENNEL nagyobbat ugral? Akkor minden ugras egy
  // "FIGYELEM" es egy "visszaallt" sort adhat. A mintaveteli koz 10 mp, tehat
  // elmeletileg 12 sor/perc is lehetne. Megmerjuk, hogy tenyleg belefer-e a
  // koltsegvetesbe.
  coldBoot(true, "TestNet", "pw", "", "");
  g_httpBody = "Microsoft Connect Test";
  setup();
  int guard = 0;
  while (uiFlags.firstStart && ++guard < 2000000) loop();
  ser8Fazis = 0;
  g_onDelay = ser8Hook;
  const uint32_t lpm = serialLinesPerMinute(30u * 60 * 1000);
  g_onDelay = nullptr;
  printf("     [info] a kuszob korul ingadozo heap: %u sor/perc\n", lpm);
  CHECK(lpm <= 30, "a kuszob korul ingadozo heap sem lepi tul a 30 sor/percet");
  CHECK(serialHas("FIGYELEM: alacsony"), "de a figyelmeztetes tenyleg megszolal");
}

static void scSER9() {
  // ELLENSEGES ESET: A NAPLO MENTESE MINDIG BUKIK.
  //
  // Megtelt fajlrendszer mellett a saveEventLog() minden router resetnel es
  // minden alvas elott lefut - es minden alkalommal 4-5 sort ir a hibarol.
  // Ez a teljes eszkalacio alatt megsokszorozodhat. Megmerjuk.
  coldBoot(true, "TestNet", "pw", "", "");
  g_httpBody = "Rossz"; pingSim.ok = false;   // tartos internetkieses
  g_fsCapacity = 24;                          // a naplo mentese mindig bukik
  setup();
  const uint32_t lpm = serialLinesPerMinute(90u * 60 * 1000);
  printf("     [info] tartos kieses + mindig buko naplomentes: %u sor/perc\n", lpm);
  CHECK(lpm <= 30, "a buko naplomentes sem arasztja el a soros portot");
  CHECK(serialHas("rovid iras") || serialHas("NEM sikerult"),
        "kozben a hibat tenyleg jelezte");
}

static void scSER10() {
  // ELLENSEGES ESET: A 33 KORES, KETNAPOS LETRA.
  //
  // A leghosszabb menet, amit a program egyaltalan lejatszik: a halozat
  // egyaltalan nem latszik, es 33 koron at probalkozunk. Minden kor
  // ujracsatlakozasi probakat es router resetet is tartalmaz - ez az a menet,
  // ahol a legtobb sor keletkezik.
  coldBoot(false, "TestNet", "pw", "", "");
  setup();
  const size_t elotte = g_serialLog.size();
  const uint32_t t0 = g_millis;
  int guard = 0;
  int alvasok = 0;
  // Tobb kort vegigjatszunk: minden alvas utan "ebredunk" (a harness a deep
  // sleepet kivetellel modellezi, es a coldBoot ebredeskent indit ujra).
  try {
    while (alvasok < 5 && ++guard < 5000000) {
      try { loop(); }
      catch (DeepSleepSignal&) {
        alvasok++;
        const uint32_t rounds = rtcRetryRounds;
        const uint32_t most = g_millis;
        coldBoot(false, "TestNet", "pw", "", "", 500, true);
        g_millis = most + 3600u * 1000;      // egy ora alvas
        rtcRetryRounds = rounds;
        setup();
      }
    }
  } catch (RestartSignal&) {}
  const uint32_t percek = (g_millis - t0) / 60000;
  const uint32_t lpm = percek ? (uint32_t)((g_serialLog.size() - elotte) / percek) : 0;
  printf("     [info] %d kor a ketnapos letrabol (%u perc, %u sor osszesen): "
         "%u sor/perc\n", alvasok, percek,
         (unsigned)(g_serialLog.size() - elotte), lpm);
  CHECK(alvasok == 5, "ot teljes kort lejatszottunk");
  CHECK(lpm <= 30, "a ketnapos letra sem lepi tul a 30 sor/percet");
  CHECK(rtcRetryRounds >= 5, "es a korszamlalo tenyleg no");
}

static void scOV1() {
  // A szamlalok nem csordulnak tul: az internet tartos kieseseben a
  // failedCount / cycleIndex korlatos marad, mert a router reset nullazza oket.
  coldBoot(true, "TestNet", "pw", "", "");
  g_httpBody = "Rossz"; pingSim.ok = false;
  setup();
  loop();
  int guard = 0;
  uint32_t resets = 0;
  try {
    while (++guard < 400000) {
      const size_t before = g_log.size();
      loop(); g_millis += 10;
      for (size_t i = before; i < g_log.size(); i++)
        if (g_log[i] == RELAY_HIGH) resets++;
      if (resets >= 3) break;
    }
  } catch (DeepSleepSignal&) {}
  CHECK(resets >= 3, "több router reset ciklus lefutott");
  CHECK(guard < 400000, "nem ragadt be végtelen ciklusba");
}


// --- A watchdog feliratkozas tenyleges ellenorzese ---------------------------
// Az enableLoopWDT() (esp32-hal-misc.c) void: ha az esp_task_wdt_add() hibazik,
// csak egy log_e() jelzi. Ha vakon feltetelezzuk a sikert, ket baj tortenik:
// (1) azt hisszuk, vedve vagyunk, kozben egy lefagyas eszrevetlen marad,
// (2) minden feedLoopWDT() ESP_ERR_NOT_FOUND-ot kap -> 10 ms-onkent egy
//     log_e() sor a soros portra.
static void scWDT6() {
  // A TWDT nincs inicializalva (ESP_TASK_WDT_INIT=n). A sketchnek fel kell
  // huznia, es utana tenylegesen vedenie a loop()-ot.
  coldBoot(true, "TestNet", "pw", "", "");
  g_wdtInited = false; g_wdtEnabled = false;
  setup();
  CHECK(logIndex("wdt_init") >= 0, "a sketch inicializalta a TWDT-t");
  CHECK(g_wdtEnabled, "a loop task VEGUL fel van iratkozva");
  CHECK(g_wdtTimeoutMs == 90000 && g_wdtPanic, "90 mp-es timeout, panic bekapcsolva");
  CHECK(serialHas("Watchdog enabled"), "csak most jelenti sikeresnek");

  // A masik fele: feliratkozas nelkul minden etetes ESP_ERR_NOT_FOUND lenne,
  // amire a core log_e()-t hiv - 10 ms-onkent egy sor a soros portra.
  g_wdtFeedNotSubscribed = 0;
  const uint32_t t0 = g_millis;
  int guard = 0;
  try { while (g_millis - t0 < 60u * 1000 && ++guard < 500000) loop(); }
  catch (...) {}
  CHECK(g_wdtFeedNotSubscribed == 0, "nincs feliratkozas nelkuli etetes (nincs log_e() aradat)");
}

static void scWDT7() {
  // A TWDT nincs inicializalva ES nem is huzhato fel. A feliratkozas tehat
  // sikertelen - ilyenkor TILOS etetni (az lenne az elarasztott konzol), es
  // tilos vedelmet allitani.
  coldBoot(true, "TestNet", "pw", "", "");
  g_wdtInited = false; g_wdtEnabled = false; g_wdtInitFails = true;
  setup();
  g_wdtFeedNotSubscribed = 0;
  const size_t before = g_serialLog.size();
  const uint32_t t0 = g_millis;
  int guard = 0;
  try { while (g_millis - t0 < 60u * 1000 && ++guard < 500000) loop(); }
  catch (...) {}
  CHECK(!g_wdtEnabled, "a loop task NINCS feliratkozva");
  CHECK(!serialHas("Watchdog enabled"), "nem allitja, hogy vedve van");
  CHECK(serialHas("FIGYELEM"), "kiirja, hogy a watchdog nem vedi a loop()-ot");
  CHECK(g_wdtFeedNotSubscribed == 0,
        "egyetlen feliratkozas nelkuli etetes sincs (nincs log_e() aradat)");
  CHECK(g_serialLog.size() - before < 60,
        "1 perc alatt sem arasztja el a konzolt");
}

static void scWDT8() {
  // A feliratkozas sikerul, de a konfiguralas nem. Feliratkozva maradni a be
  // nem allitott (tipikusan 5 mp-es) timeouttal maga lenne a csapda: a
  // http.GET() akar 33 mp-ig blokkol etetes nelkul, tehat MINDEN teszt
  // watchdog-panicba es ujrainditasi hurokba futna. Ilyenkor a helyes lepes
  // a leiratkozas: vedelem nincs, de a program legalabb fut.
  coldBoot(true, "TestNet", "pw", "", "");
  g_wdtReconfigureFails = true;
  setup();
  CHECK(!serialHas("Watchdog enabled"), "nem jelent sikeres 90 mp-es timeoutot");
  CHECK(serialHas("FIGYELEM"), "figyelmeztet, hogy nincs vedelem");
  CHECK(!g_wdtEnabled, "leiratkozott: az 5 mp-es default nem valhat csapdava");
  CHECK(logIndex("disableLoopWDT") > logIndex("enableLoopWDT"),
        "a leiratkozas a sikertelen konfiguralas KOVETKEZMENYE");
  // Etetes nelkuli mukodes: a feedWatchdog() kapuzva van, nincs log_e() aradat.
  g_wdtFeedNotSubscribed = 0;
  const uint32_t t0 = g_millis;
  int guard = 0;
  try { while (g_millis - t0 < 30u * 1000 && ++guard < 300000) loop(); }
  catch (...) {}
  CHECK(g_wdtFeedNotSubscribed == 0,
        "leiratkozas utan egyetlen etetes sincs (nincs hibasor-aradat)");
}

// --- Diagnosztikai naplo: a dokumentalt esemenykodok tenyleg keletkeznek ----
static void scL4() {
  // Elso indulas mentett halozat nelkul -> AP mod. A naplobol ennek ki kell
  // derulnie, kulonben soros kabel nelkul nem tudni, miert all AP modban.
  coldBoot(false, "", "", "", "");
  rtcEvMagic = 0; rtcEvNext = 0;
  setup();
  CHECK(deviceMode == (DeviceMode)1, "AP mod");
  bool found = false;
  for (uint32_t i = 0; i < rtcEvNext && i < 32; i++) {
    if (rtcEvents[i].code == 6 && rtcEvents[i].param == 1) found = true;
  }
  CHECK(found, "AP MODE esemeny a 'nincs mentett SSID' okkal (param=1)");
}

static void scL5() {
  // Vegzetes hiba utani elalvas: ez az utolso dolog, ami tortent - a naplobol
  // meg kell latszania, hogy nem magatol halt meg az eszkoz.
  coldBoot(true, "TestNet", "pw", "", "");
  rtcEvMagic = 0; rtcEvNext = 0;
  g_fsMountOk = false;
  setup();
  CHECK(deviceMode == (DeviceMode)2, "MODE_FATAL");
  bool slept = false;
  int guard = 0;
  try { while (++guard < 500000) loop(); }
  catch (DeepSleepSignal&) { slept = true; }
  CHECK(slept, "5 perc utan elaludt");
  CHECK(g_wakeupUs == 0, "idozitett ebresztes NINCS");
  bool found = false;
  for (uint32_t i = 0; i < rtcEvNext && i < 32; i++) {
    if (rtcEvents[i].code == 8 && rtcEvents[i].param == 4) found = true;
  }
  CHECK(found, "SLEEP esemeny a vegzetes hiba okkal (param=4)");
}

// --- Felig kitoltott statikus IP --------------------------------------------
static void scP8() {
  // IP gateway nelkul: az initWiFi() ilyenkor DHCP-re esik vissza, tehat a
  // "menj a megadott fix cimre" uzenet hazugsag lenne.
  coldBoot(false, "", "", "", "");
  setup();
  std::string body;
  int code = postConfig("Halozat", "jelszo123", "192.168.1.200", "", &body);
  CHECK(code == 500, "IP gateway nelkul -> 500, nem hamis siker");
  CHECK(body.find("gateway") != std::string::npos, "az indoklas megnevezi a gateway-t");
  CHECK(!restartRequested(), "nem indul ujra a hianyos konfiggal");

  code = postConfig("Halozat", "jelszo123", "", "192.168.1.1", &body);
  CHECK(code == 500, "gateway IP nelkul -> szinten 500");

  code = postConfig("Halozat", "jelszo123", "192.168.1.200", "192.168.1.1", &body);
  CHECK(code == 200, "mindketto megadva -> 200");
  CHECK(restartRequested(), "es most mar ujraindul");
}

static void scP9() {
  // A csonkolatlan indoklas: a snprintf() puffere eleg nagy hozza.
  coldBoot(false, "", "", "", "");
  setup();
  std::string body;
  postConfig("Halozat", "jelszo123", "192.168.1.200", "", &body);
  CHECK(body.find("probald meg ismet") != std::string::npos,
        "a hibauzenet vege sem csonkolodik le");
}

// --- Beragadt szerver: a sajat hatarido tartson ------------------------------
// ============ CHUNKED VALASZ ============
//
// A HTTPClient a darabhatarokat csak a getString() / writeToStream() utjan
// bontja le; mi egyiket sem hasznaljuk (korlatlanul foglalnanak), tehat a nyers
// streamben ott vannak a keretbajtok. Ezek nelkul a jol mukodo vegpont valasza
// is "Hamis ertek" lenne - vagyis egy atkeretezo proxy internetkimaradasnak
// latszana.

static void scCH1() {
  g_httpCode = 200; g_httpBeginOk = true;
  g_httpChunked = true; g_httpChunkSize = 0;   // egyetlen darab
  g_httpBody = "Microsoft NCSI";
  CHECK(testInternetHTTP("http://x/", "Microsoft NCSI"), "chunked valasz is egyezik");
  CHECK(!testInternetHTTP("http://x/", "Valami mas"), "de a tartalmat tovabbra is nezi");
}

static void scCH2() {
  g_httpCode = 200; g_httpBeginOk = true;
  g_httpChunked = true; g_httpChunkSize = 3;   // 5 darabra vagva
  g_httpBody = "Microsoft NCSI";
  CHECK(testInternetHTTP("http://x/", "Microsoft NCSI"), "tobb darabot is osszefuz");
  g_httpChunkSize = 1;
  CHECK(testInternetHTTP("http://x/", "Microsoft NCSI"), "bajtonkent darabolva is");
}

static void scCH3() {
  // Nagybetus hexa es darab-kiterjesztes: az RFC 9112 mindkettot engedi.
  g_httpCode = 200; g_httpBeginOk = true; g_httpChunked = true;
  g_httpRawOverride = "E;padding=xyz\r\nMicrosoft NCSI\r\n0\r\n\r\n";
  CHECK(testInternetHTTP("http://x/", "Microsoft NCSI"), "kiterjesztest es nagybetus hexat is kezel");
  g_httpRawOverride = "e\r\nMicrosoft NCSI\r\n0\r\n\r\n";
  CHECK(testInternetHTTP("http://x/", "Microsoft NCSI"), "kisbetus hexa is jo");
  g_httpRawOverride.clear();
}

static void scCH4() {
  // Szabalytalan keretezes: nem talalgatunk, a teszt elbukik - ez a biztonsagos
  // irany (egy captive portal soha ne szamitson sikeres internettesztnek).
  g_httpCode = 200; g_httpBeginOk = true; g_httpChunked = true;
  const uint32_t t0 = g_millis;
  g_httpRawOverride = "zz\r\nMicrosoft NCSI\r\n0\r\n\r\n";
  CHECK(!testInternetHTTP("http://x/", "Microsoft NCSI"), "hexa helyett szemet -> nem egyezik");
  // A meret sor 5 bajtot iger, de a kapcsolat 3 utan veget er.
  g_httpRawOverride = "5\r\nMic";
  CHECK(!testInternetHTTP("http://x/", "Microsoft NCSI"), "csonka darab -> nem egyezik");
  // Tulcsordulasra hajto meret: a 32 bites szamlalo korbefordulna, es egy
  // "kicsi" meretet kapnank egy oriasi darabra.
  g_httpRawOverride = "FFFFFFFFFFFF\r\nMicrosoft NCSI\r\n0\r\n\r\n";
  CHECK(!testInternetHTTP("http://x/", "Microsoft NCSI"), "tulcsordulo darabmeret -> nem egyezik");
  CHECK(g_millis - t0 < 5000, "es egyik esetben sem var ki timeoutot");
  g_httpRawOverride.clear();
}

static void scCH5() {
  // Egy captive portal darabokban is kuldhet szazezer bajtot. A getSize() ilyenkor
  // -1, tehat a meret-alapu korai elutasitas nem vedi meg: a darabolvasonak kell
  // megallnia a puffer hataran.
  g_httpCode = 200; g_httpBeginOk = true; g_httpChunked = true;
  g_httpChunkSize = 100;
  g_httpBody = std::string(50000, 'x');
  const uint32_t t0 = g_millis;
  CHECK(!testInternetHTTP("http://x/", "Microsoft NCSI"), "nem egyezik, es nem is szallt el");
  CHECK(g_millis - t0 < 5000, "nem olvassa vegig az 50 kB-ot");
  g_httpChunkSize = 0; g_httpBody = "Microsoft NCSI";
}

static void scH5() {
  // A kapcsolat el, de nem jon tobb adat. A readBounded() nem varhat a socket
  // sajat fogadasi timeoutjara, mert az nem a mienk - a sajat hataridejevel
  // kell kilepnie, jocskan a watchdog timeout alatt.
  coldBoot(true, "TestNet", "pw", "", "");
  setup();
  g_httpCode = 200; g_httpSize = -1; g_httpBody = "Micro";  // fel valasz
  g_httpStall = true;
  const uint32_t t0 = g_millis;
  const bool ok = testInternetHTTP("http://pelda/x", "Microsoft NCSI");
  const uint32_t elapsed = g_millis - t0;
  g_httpStall = false;
  CHECK(!ok, "a csonka valasz nem egyezik");
  CHECK(elapsed < 5000, "a hatarido ~1,5 mp korul tart, nem 10 mp-ig var");
  CHECK(elapsed < 90000, "biztosan a watchdog timeout alatt marad");
}

// --- "generate_204" stilusu vegpont -----------------------------------------
// Ures elvart valasz eseten nem szoveget egyeztetunk, hanem a 204 No Content
// statuszkodot varjuk. Ez szigorubb: egy captive portal nem tud 204-et adni,
// mert neki eppenseggel tartalmat kell kuldenie (bejelentkezo oldal vagy
// atiranyitas). Ugyanezt a dontest hozza a NetworkManager is.
static void scH6() {
  g_httpBeginOk = true; g_httpSize = -2;
  g_httpCode = 204; g_httpBody = "";
  CHECK(testInternetHTTP("http://x/generate_204", ""), "204 + üres elvárás -> siker");

  g_httpCode = 200; g_httpBody = "";
  CHECK(!testInternetHTTP("http://x/generate_204", ""),
        "üres törzsű 200 nem elég, ha 204-et várunk");

  g_httpCode = 200; g_httpBody = "<html>Jelentkezzen be a WiFi hasznalatahoz</html>";
  CHECK(!testInternetHTTP("http://x/generate_204", ""),
        "captive portal 200 + HTML -> elbukik");

  g_httpCode = 302; g_httpBody = "";
  CHECK(!testInternetHTTP("http://x/generate_204", ""), "átirányítás -> elbukik");

  g_httpCode = -1; g_httpBody = "";
  CHECK(!testInternetHTTP("http://x/generate_204", ""), "kapcsolódási hiba -> elbukik");

  // A szoveges ag nem lazul fel: ott tovabbra is 200 kell.
  g_httpCode = 204; g_httpBody = "Microsoft Connect Test";
  CHECK(!testInternetHTTP("http://x/", "Microsoft Connect Test"),
        "a szöveges teszt nem fogad el 204-et");
  g_httpCode = 200; g_httpSize = -2;
}

static void scH7() {
  // 204-nel a torzs olvasasaba bele sem szabad kezdeni: ures streamnel a
  // readBounded() a sajat 1,5 mp-es hataridejeig varna a semmire.
  g_httpBeginOk = true; g_httpCode = 204; g_httpBody = ""; g_httpSize = -1;
  const uint32_t t0 = g_millis;
  CHECK(testInternetHTTP("http://x/generate_204", ""), "204 -> siker");
  CHECK(g_millis - t0 < 1500,  // HTTP_READ_TIMEOUT_MS
        "a törzset el sem kezdi olvasni, nincs 1,5 mp várakozás");
  g_httpCode = 200; g_httpSize = -2;
}

// --- Az eszkalacio tenyleg kulonbozo vegpontokat probal ----------------------
// Regresszio arra, hogy egyetlen uzemelteto kiesese ne dontson a router
// ujrainditasarol: az 5 teszt 5 kulonbozo cel, 5 kulonbozo uzemelteto.
// ICMP nincs kozottuk - lasd scH9.
static void scH8() {
  coldBoot(true, "TestNet", "pw", "", "");
  g_httpCode = -1; pingSim.ok = false;
  setup();
  g_httpUrls.clear(); pingSim.targets.clear();

  int guard = 0; bool relay = false;
  try {
    while (++guard < 400000 && !relay) {
      const size_t before = g_log.size();
      loop();
      for (size_t i = before; i < g_log.size(); i++)
        if (g_log[i] == RELAY_HIGH) relay = true;
    }
  } catch (DeepSleepSignal&) {}

  CHECK(relay, "az eszkaláció végén elindul a router reset");
  CHECK(g_httpUrls.size() == 5, "mind az 5 teszt HTTP volt");
  if (g_httpUrls.size() == 5) {
    CHECK(g_httpUrls[0] == "http://www.msftconnecttest.com/connecttest.txt",
          "0: Microsoft");
    CHECK(g_httpUrls[1] == "http://cp.cloudflare.com/generate_204",
          "1: Cloudflare");
    CHECK(g_httpUrls[2] == "http://detectportal.firefox.com/success.txt",
          "2: Mozilla");
    CHECK(g_httpUrls[3] == "http://nmcheck.gnome.org/check_network_status.txt",
          "3: GNOME / NetworkManager");
    CHECK(g_httpUrls[4] == "http://connectivitycheck.gstatic.com/generate_204",
          "4: Google");
    std::set<std::string> uniq(g_httpUrls.begin(), g_httpUrls.end());
    CHECK(uniq.size() == 5, "öt különböző végpont, egyik sem ismétlődik");
  }
  // A ping MOSTANTOL letezik a programban - de csak a hosszu varakozasok korai
  // lezarasahoz (onlineProbe), sosem az internetteszt reszekent. A szerzodes
  // tehat nem az, hogy "nincs ping", hanem hogy egyetlen ping sem HELYETTESIT
  // egy HTTP tesztet: az eszkalacio mind az ot vegpontot vegigprobalta.
  bool csakProbeCel = true;
  for (auto& t : pingSim.targets) {
    if (t != "1.1.1.1") csakProbeCel = false;
  }
  CHECK(csakProbeCel,
        "minden ping a proba celpontjara ment, egyik sem az internetteszt resze");
}

// --- Befagyott router-DNS: HTTP semmi, ICMP tokeletes -----------------------
// Ez a leggyakoribb "csatlakozva, de nincs internet" hiba olcso routereken
// (a dnsmasq beragad). Amig a ping is szavazhatott, az eszkoz orakon at
// tetlen maradt: 41 bukott HTTP teszt mellett 0 router reset. Mostantol
// mind az ot teszt nevfeloldast igenyel, tehat ezt eszreveszi.
static void scH9() {
  coldBoot(true, "TestNet", "pw", "", "");
  g_httpCode = -1;      // egyetlen nev sem oldodik fel
  pingSim.ok = true;    // de az IP szintu utvonal hibatlan
  setup();

  int guard = 0, relays = 0;
  const uint32_t t0 = g_millis;
  size_t before = g_log.size();
  try {
    while (++guard < 400000 && g_millis - t0 < 30u * 60 * 1000 && relays == 0) {
      loop();
      for (size_t i = before; i < g_log.size(); i++)
        if (g_log[i] == RELAY_HIGH) relays++;
      before = g_log.size();
    }
  } catch (DeepSleepSignal&) {}
  CHECK(relays == 1, "a befagyott DNS-t router resettel kezeli");
  CHECK(g_millis - t0 < 5u * 60 * 1000, "5 percen belül, nem órákon át tétlenül");
  // A regi teszt azt kotötte ki, hogy egyaltalan NINCS ping. Az onlineProbe()
  // ota van - es epp ezert lett ez a teszt ERŐSEBB: most azt allitjuk, hogy a
  // ping tenyleg lefutott ES SIKERULT (pingSim.ok = true), a router reset
  // megis megtortent. Vagyis a ping semmilyen uton nem tud "atszavazni" a
  // HTTP tesztek felett - ez a H9 eredeti lenyege.
  CHECK(!pingSim.targets.empty(), "a proba tenyleg pingelt (es sikerult is)");
  CHECK(g_httpUrls.size() >= 5, "es mind az ot HTTP teszt lefutott");
}


// --- Csak IPv4 hasznalhato --------------------------------------------------
// Az IPAddress::fromString() az IPv4 utan IPv6-ot is megprobal, ezert a "::1"
// is ervenyesnek latszik - de a WiFi.config() az uint32_t konverziot hasznalja,
// ami IPv6-ra 0-t ad. Igy egy IPv6 cim csendben DHCP-t, vegyes paros eseten
// pedig gateway es DNS nelkuli statikus IP-t eredmenyezne.
static void scIP1() {
  // Eloszor: a stub tenyleg ugy viselkedik, mint a core.
  IPAddress a;
  CHECK(a.fromString("::1"), "a core-hoz huen a '::1' ervenyes cimnek szamit");
  CHECK((uint32_t)a == 0, "de az uint32_t konverzio 0-t ad (IPAddress.h:83)");
  IPAddress b;
  CHECK(b.fromString("192.168.1.5") && (uint32_t)b != 0, "IPv4 viszont nem nulla");
}

static void scIP2() {
  coldBoot(false, "", "", "", "");
  setup();
  std::string body;
  int code = postConfig("Halozat", "jelszo123", "::1", "fe80::1", &body);
  CHECK(code == 500, "IPv6 cimparos -> 500, nem csendes DHCP");
  CHECK(!restartRequested(), "nem indul ujra ervenytelen cimmel");

  // A vegyes paros a rosszabb eset: IPv4 IP + IPv6 gateway eseten a config()
  // 0.0.0.0-s gateway-t ES 0.0.0.0-s elsodleges DNS-t allitana be.
  code = postConfig("Halozat", "jelszo123", "192.168.1.200", "fe80::1", &body);
  CHECK(code == 500, "IPv4 IP + IPv6 gateway -> 500");

  code = postConfig("Halozat", "jelszo123", "0.0.0.0", "192.168.1.1", &body);
  CHECK(code == 500, "0.0.0.0 sem fogadhato el (a config() DHCP-nek venne)");

  code = postConfig("Halozat", "jelszo123", "192.168.1.200", "192.168.1.1", &body);
  CHECK(code == 200, "ervenyes IPv4 paros -> 200");
}

static void scIP3() {
  // Regebbi firmware IPv6 cimet is elmenthetett: az initWiFi()-nek akkor is
  // DHCP-re kell esnie, nem gateway nelkuli statikus IP-t beallitania.
  coldBoot(true, "TestNet", "pw", "192.168.1.200", "fe80::1");
  setup();
  CHECK(wifiSim.configCount == 0, "nem hivott config()-ot a hibas parossal");
  CHECK(!wifiSim.staticApplied, "DHCP-re esett vissza");
  CHECK(serialHas("Invalid gateway format"), "es meg is mondja, miert");
  CHECK(wifiSim.beginCount == 1, "de csatlakozni azert megprobalt");
}

// --- Fajliras kozben nincs ujrainditas --------------------------------------
static void scP10() {
  // A felhasznalo eppen menteskor nyomja meg a reset gombot. A mentes kozbeni
  // ujrainditas felig kiirt konfiguraciot hagyna - ugyanaz a szabaly, mint az
  // elalvasnal.
  coldBoot(false, "", "", "", "");
  setup();
  (void)beginConfigWrite();
  g_pinRead[3] = LOW;                      // D1 = GPIO3, reset gomb
  bool restarted = false;
  try {
    for (int i = 0; i < 50; i++) { resetbutton(); delay(10); }
  } catch (RestartSignal&) { restarted = true; }
  CHECK(!restarted, "mentes kozben NEM indul ujra");

  endConfigWrite();
  try {
    // A mentes alatt a debounce sem indult el, tehat itt egy teljes 50 ms-os
    // lenyomas kell - nehany tized masodperc bosegesen eleg ra.
    for (int i = 0; i < 20; i++) { resetbutton(); delay(10); }
  } catch (RestartSignal&) { restarted = true; }
  CHECK(restarted, "a mentes utan viszont lefut (uj 50 ms debounce utan)");
}

static void scP11() {
  // Ugyanez a wifireset gombra: az mentes kozben a fajlokat is torolne, mikozben
  // az aszinkron task eppen irja oket.
  coldBoot(false, "", "", "", "");
  setup();
  g_fs["/ssid.txt"] = "RegiHalozat";
  (void)beginConfigWrite();
  g_pinRead[2] = LOW;                      // D0 = GPIO2, wifireset gomb
  bool restarted = false;
  try {
    for (int i = 0; i < 50; i++) { wifiresetbutton(); delay(10); }
  } catch (RestartSignal&) { restarted = true; }
  CHECK(!restarted, "mentes kozben NEM indul ujra");
  CHECK(g_fs["/ssid.txt"] == "RegiHalozat", "es nem is torolte a fajlokat");

  endConfigWrite();
  try {
    for (int i = 0; i < 20; i++) { wifiresetbutton(); delay(10); }
  } catch (RestartSignal&) { restarted = true; }
  CHECK(restarted, "a mentes utan viszont torol es ujraindit");
}


// --- Amit beirsz, azt is hasznalja -----------------------------------------
static void scP12() {
  // A readConfigValue() beolvasaskor levagja a whitespace-t. Ha mentéskor nem
  // vagnank, a fajlban mas lenne, mint amivel az eszkoz csatlakozik - es a
  // portal is a nyers erteket visszhangozna.
  coldBoot(false, "", "", "", "");
  setup();
  const int code = postConfig("  MyNetwork  ", "  titok123  ", "", "");
  CHECK(code == 200, "elfogadja");
  CHECK(g_fs["/ssid.txt"] == "MyNetwork", "az elmentett SSID mar vagott");
  CHECK(storedPass() == "titok123", "a jelszo is");
  CHECK(serialHas("SSID set to: MyNetwork"), "es a visszajelzes is a vagott ertek");
}

static void scP13() {
  // Csupa szokozbol allo SSID: a vagas utan ures marad. Ilyet nem szabad
  // sikerkent elfogadni - ujraindulas utan ugyanitt, AP modban kotnenk ki.
  coldBoot(false, "", "", "", "");
  setup();
  std::string body;
  const int code = postConfig("     ", "jelszo123", "", "", &body);
  CHECK(code == 500, "csupa szokoz SSID -> 500");
  CHECK(!restartRequested(), "nem indul ujra hasznalhatatlan SSID-vel");
}


// --- A LED-ek ne hazudjanak -------------------------------------------------
static void scLED1() {
  // A reset pulzus alatt a STATUSZ LED VILLOG (2 Hz), a Wi-Fi LED viszont
  // vegig sotet: a router ilyenkor aram nelkul van, tehat kapcsolat sincs.
  //
  // A korabbi valtozat mindket LED-et sotetre kapcsolta, es ez a teszt azt
  // rogzitette. 90 masodpercnyi sotet LED viszont ranezesre a HALOTT
  // eszkoztol sem kulonboztetheto meg - ezert villog most a statusz LED.
  // FIGYELEM a teszt erejere: a regi "volt-e pin6=LOW" allitas a villogasra
  // is IGAZ lenne, tehat csendben tovabb ment volna. Ezert nezzuk MINDKET
  // irany valtasait, es szamoljuk is oket.
  coldBoot(true, "TestNet", "pw", "", "");
  setup();
  CHECK(g_pinState[PIN_WIFILED] == HIGH, "csatlakozas utan vilagit a Wi-Fi LED (GPIO5)");

  int guard = 0;
  while (!reset_device() && ++guard < 200000) { feedLoopWDT(); delay(10); }
  CHECK(guard < 200000, "a reset pulzus lefutott");

  const int relayOn = logIndex(RELAY_HIGH);
  CHECK(relayOn >= 0, "a rele bekapcsolt");
  bool wifiLedOnInPulse = false;
  int statusLow = 0, statusHigh = 0;
  for (size_t i = (size_t)relayOn; i < g_log.size(); i++) {
    if (g_log[i] == RELAY_LOW && (int)i > relayOn) break;
    if (g_log[i] == "pin5=HIGH") wifiLedOnInPulse = true;
    if (g_log[i] == LED_LOW)  statusLow++;
    if (g_log[i] == LED_HIGH) statusHigh++;
  }
  CHECK(statusLow > 100 && statusHigh > 100,
        "a statusz LED VILLOG a pulzus alatt (90 mp / 2 Hz -> tobb szaz valtas)");
  CHECK(!wifiLedOnInPulse, "a Wi-Fi LED egyszer sem gyullad ki - nincs halozat");
  CHECK(g_pinState[PIN_LED] == HIGH, "a pulzus utan folyamatosra all vissza");
}


// ===========================================================================
// A kovetkezo esetek a lefedettseg-meres (gcov) alapjan keszultek: ezeket az
// agakat a 111 forgatokonyv egyike sem futtatta le, tehat semmi nem vedte oket.
// ===========================================================================

// --- A halasztott ujrainditas tenyleg lefut ---------------------------------
static void scP14() {
  // A sikeres mentes utan a loop() feladata ujrainditani, miutan a valasz
  // kiment. Eddig csak azt ellenoriztuk, hogy a jelzo beall - azt nem, hogy
  // az ujrainditas valoban megtortenik, es hogy a turelmi ido elotte NEM.
  coldBoot(false, "", "", "", "");
  setup();
  CHECK(postConfig("Halozat", "jelszo123", "", "") == 200, "mentes OK");
  CHECK(restartRequested(), "ujrainditas beutemezve");

  bool early = false;
  try {
    // A turelmi ido (2 mp) alatt meg nem szabad ujraindulnia: a valasznak
    // ki kell mennie a bongeszo fele.
    for (int i = 0; i < 150; i++) { loop(); }     // ~1,5 mp
  } catch (RestartSignal&) { early = true; }
  CHECK(!early, "a 2 mp-es turelmi ido alatt NEM indul ujra");

  bool restarted = false;
  try {
    for (int i = 0; i < 200; i++) { loop(); }     // tovabbi ~2 mp
  } catch (RestartSignal&) { restarted = true; }
  CHECK(restarted, "a turelmi ido utan viszont ujraindul");
}

// --- A naplo cimkei ---------------------------------------------------------
static void scL6() {
  // A /log oldal emberi olvasasra szant resze. Ha egy cimke elcsuszna, a
  // naplo felrevezetne - es eddig csak a BOOT sor volt tesztelve.
  coldBoot(false, "", "", "", "");
  rtcEvMagic = 0; rtcEvNext = 0;
  setup();
  logEvent((EventCode)2, 7);    // WIFI OK
  logEvent((EventCode)3, 3);    // WIFI LOST
  logEvent((EventCode)4, 1);    // TEST FAIL
  logEvent((EventCode)5, 2);    // ROUTER RESET
  logEvent((EventCode)7, 0);    // CONFIG SAVED
  logEvent((EventCode)8, 4);    // SLEEP
  logEvent((EventCode)9, 3);    // FATAL
  logEvent((EventCode)10, 2);   // WDT RESET
  logEvent((EventCode)11, 1);   // STUCK BUTTON
  logEvent((EventCode)12, 1);   // GW UNREACH
  logEvent((EventCode)13, 24);  // LOW HEAP
  logEvent((EventCode)14, 11);  // HEAP RESTART
  // A 6-os (AP MODE) sort a coldBoot(SSID nelkul) + setup() mar beirta.
  // A 12-es viszont eddig KIMARADT: a test/README azt allitotta, hogy ez a
  // teszt MINDEN kodot lefed, a lefedettseg-meres pedig azt mutatta, hogy a
  // "GW UNREACH" cimke sora sosem fut le. Az allitas es a teszt szetcsuszott.
  //
  // ...es UGYANEZ ismetlodott meg a 13-14-es kodoknal (LOW HEAP, HEAP
  // RESTART): a teszt tovabbra is "MIND a 12"-t allitott, mikozben mar 14 kod
  // volt. A tanulsag: ha uj esemenykod kerul az enumba, EZT a listat is
  // bovitteni kell - kulonben a teszt cime hazudik.

  AsyncWebServerRequest req;
  g_handlers["/log#1"](&req);
  const std::string& b = req._body;
  const char* want[] = { ">BOOT<", ">WIFI OK<", ">WIFI LOST<", ">TEST FAIL<",
                         ">ROUTER RESET<", ">AP MODE<", ">CONFIG SAVED<",
                         ">SLEEP<", ">FATAL<", ">WDT RESET<", ">STUCK BUTTON<",
                         ">GW UNREACH<", ">LOW HEAP<", ">HEAP RESTART<" };
  bool all = true;
  for (const char* w : want) if (b.find(w) == std::string::npos) { all = false; printf("     [info] hianyzik: %s\n", w); }
  CHECK(all, "MIND a 14 esemenykod olvashato cimket kap");
  CHECK(b.find(">?<") == std::string::npos, "nincs ismeretlen kod a naplóban");
}

static void scL7() {
  // Ures naplo: a /log oldal ne dobjon tablat fejlec nelkul.
  //
  // A KOVETELMENY BOVULT. Amiota a naplo a fajlrendszerre is kimegy, ket
  // forras van, es a lap csak akkor nema, ha MINDKETTO ures. Ez pontosan az a
  // viselkedes, amit el is varunk: ha egyik sem letezik vagy mindketto ures,
  // egyszeruen nincs naplo az AP mod weboldalan - nem hibauzenet, nem ures
  // tablazat.
  coldBoot(false, "", "", "", "");
  setup();
  rtcEvMagic = 0; rtcEvNext = 0;      // a setup() BOOT sora utan uritjuk
  g_fs.erase("/evlog.bin");           // ...es a mentett fajlt is
  AsyncWebServerRequest req;
  g_handlers["/log#1"](&req);
  CHECK(req._body.find("Nincs rogzitett esemeny") != std::string::npos,
        "ures naplonal ezt irja ki");
  CHECK(req._body.find("<table") == std::string::npos, "es nem rajzol ures tablat");
}

// --- A tobbi HTTP vegpont ---------------------------------------------------
static void scF2() {
  // A portal a LittleFS-rol SEMMIT nem szolgal ki. Ez a legfontosabb
  // biztonsagi tulajdonsaga: a /pass.txt ugyanabban a gyokerben van, mint
  // barmi mas, amit valaha kiszolgalnank. A teszt ezert szandekosan olyan
  // fajlokat tesz fel, amiket a regi valtozat MEG kiadott volna.
  coldBoot(false, "", "", "", "");
  setup();
  g_fs["/wifimanager.html"] = "<html>REGI FAJL</html>";
  g_fs["/style.css"] = "body{}";
  g_fs["/favicon.png"] = "png";

  AsyncWebServerRequest a; g_handlers["/#1"](&a);
  CHECK(a._code == 200, "/ -> 200");
  CHECK(a._body.find("REGI FAJL") == std::string::npos,
        "a / a BEEPITETT urlapot adja, nem a fajlrendszeren talalt HTML-t");
  CHECK(a._body.find("name=\"ssid\"") != std::string::npos,
        "es ez tenyleg a beallito urlap");

  // Egyetlen olyan utvonal sincs regisztralva, ami a LittleFS-bol olvasna.
  int fsUtvonalak = 0;
  for (auto& kv : g_handlers) {
    if (kv.first.rfind("/style.css", 0) == 0) fsUtvonalak++;
    if (kv.first.rfind("/favicon", 0) == 0)   fsUtvonalak++;
    if (kv.first.rfind("/wifimanager", 0) == 0) fsUtvonalak++;
  }
  CHECK(fsUtvonalak == 0, "nincs egyetlen fajlkiszolgalo utvonal sem");
}

static void scF3() {
  // Ismeretlen utvonal: 404, es semmikepp nem szivarog ki fajltartalom.
  coldBoot(false, "", "", "", "");
  setup();
  g_fs["/pass.txt"] = "szupertitkos";
  AsyncWebServerRequest req;
  g_handlers["404"](&req);
  CHECK(req._code == 404, "ismeretlen utvonal -> 404");
  CHECK(req._body.find("szupertitkos") == std::string::npos, "nem szivarog jelszo");
}

static void scF4() {
  // Minden vegpont kitolja az AP hataridot - kulonben olvasgatas kozben
  // elaludna az eszkoz.
  coldBoot(false, "", "", "", "");
  setup();
  const uint32_t first = apDeadline;
  g_millis += 60u * 1000;
  AsyncWebServerRequest a; g_handlers["/ping#1"](&a);
  CHECK(apDeadline > first, "a /ping is kitolja a hataridot");
  const uint32_t second = apDeadline;
  g_millis += 60u * 1000;
  AsyncWebServerRequest b; g_handlers["/log#1"](&b);
  CHECK(apDeadline > second, "a /log is kitolja");

  // A doksi "minden HTTP kerest" iger. A 404 is interakcio: a bongeszo
  // magatol keri a /favicon.ico-t, es egy elgepelt cim sem jelenti azt,
  // hogy a felhasznalo elment.
  const uint32_t third = apDeadline;
  g_millis += 60u * 1000;
  AsyncWebServerRequest c; g_handlers["404"](&c);
  CHECK(c._code == 404, "ismeretlen utvonal tovabbra is 404");
  CHECK(apDeadline > third, "es a 404 is kitolja a hataridot");

  // A kitolas ABSZOLUT: mindig uj 5 perc, nem kumulativ.
  CHECK(apDeadline == g_millis + 5u * 60 * 1000,
        "a hatarido pontosan 5 perccel a keres utanra kerul");
}

// --- Tovabbi validacio ------------------------------------------------------
static void scP15() {
  // A HTML maxlength csak a bongeszot koti; egy sajat POST barmit kuldhet.
  coldBoot(false, "", "", "", "");
  setup();
  std::string body;
  std::string longPass(80, 'x');
  const int code = postConfig("Halozat", longPass.c_str(), "", "", &body);
  CHECK(code == 500, "tul hosszu jelszo -> 500");
  CHECK(body.find("jelszo") != std::string::npos, "az indoklas a jelszot nevezi meg");
  CHECK(!restartRequested(), "nem indul ujra");
}

// --- Monitorozas: a kapcsolat visszajon -------------------------------------
static void scE6() {
  // A kapcsolat kiesik, majd a reconnectWifi() visszahozza. Ilyenkor NEM szabad
  // routert ujrainditani - eddig ez az ag teljesen tesztelet len volt.
  coldBoot(true, "TestNet", "pw", "", "");
  setup();
  g_httpBody = "Microsoft Connect Test";
  loop();                                   // firstStart lezarasa
  rtcRetryRounds = 3;                       // legyen mit nullazni
  wifiSim.begun = false;                    // a kapcsolat kiesett
  wifiSim.willConnect = true;               // de azonnal visszajon
  g_log.clear();
  int guard = 0;
  try { while (++guard < 100000 && logIndex(RELAY_HIGH) < 0
               && !serialHas("Beginning Test.")) loop(); }
  catch (...) {}
  CHECK(logIndex(RELAY_HIGH) < 0, "NEM indit routert, ha visszajott a WiFi");
  CHECK(serialHas("WIFI RECONNECTED!"), "ujracsatlakozott");
  CHECK(rtcRetryRounds == 0, "a sikeres teszt nullazza a 2 napos ablakot");
}


// --- A wifireset a legfontosabbat torli eloszor -----------------------------
static void scX7() {
  // A "wifireset" celja, hogy az eszkoz a beallito portalon jojjon fel, es ezt
  // egyedul a /ssid.txt donti el. Ha a torles kozben elmegy az aram, akkor is
  // a kivant vegallapotban kell maradni - tehat az SSID megy eloszor.
  coldBoot(true, "TestNet", "pw", "192.168.1.5", "192.168.1.1");
  setup();
  g_log.clear(); g_serialLog.clear();       // a setup() sorai ne zavarjanak
  g_pinRead[2] = LOW;                       // D0 = GPIO2, wifireset
  try { for (int i = 0; i < 20; i++) { wifiresetbutton(); delay(10); } }
  catch (RestartSignal&) {}
  // A clearConfigValue() minden fajlt bejelent ("Clearing file: ..."), tehat
  // a soros naplo sorrendje mutatja a torles sorrendjet.
  int iSsid = serialIndex("Clearing file: /ssid.txt");
  int iPass = serialIndex("Clearing file: /pass.txt");
  int iIp   = serialIndex("Clearing file: /ip.txt");
  int iGw   = serialIndex("Clearing file: /gateway.txt");
  CHECK(iSsid >= 0 && iPass >= 0 && iIp >= 0 && iGw >= 0, "mind a negy fajlt erinti");
  CHECK(iSsid < iPass && iSsid < iIp && iSsid < iGw, "az SSID torlese az ELSO");
}

static void scX8() {
  // Ha a fajlrendszer nem irhato, az eszkoz NEM mukodhet tovabb: a konfiguracio
  // mentese ugyanigy elbukna, az ujrainditas pedig a regi adatokkal jonne fel.
  // Ugyanaz a hibaosztaly, mint a tobbi LittleFS hiba -> ugyanaz a kezeles.
  coldBoot(true, "TestNet", "pw", "", "");
  setup();
  rtcEvMagic = 0; rtcEvNext = 0;
  g_fsWritable = false; g_fsRemoveOk = false;   // se irni, se torolni nem tud
  g_pinRead[2] = LOW;
  g_log.clear();
  bool restarted = false, slept = false;
  const uint32_t t0 = g_millis;
  try { for (int i = 0; i < 200000; i++) { wifiresetbutton(); delay(10); } }
  catch (RestartSignal&) { restarted = true; }
  catch (DeepSleepSignal&) { slept = true; }

  CHECK(!restarted, "NEM indul ujra a regi adatokkal");
  CHECK(slept, "hanem vegzetes hibat jelez, majd elalszik");
  CHECK(deviceMode == (DeviceMode)2, "MODE_FATAL");
  CHECK(serialHas("VEGZETES HIBA"), "a soros porton is vegzetes hibat jelent");
  CHECK(g_wakeupUs == 0, "idozitett ebresztes NINCS - csak gomb vagy aramtalanitas");

  const uint32_t elapsed = g_millis - t0;
  CHECK(elapsed >= 5u * 60 * 1000 && elapsed < 6u * 60 * 1000,
        "5 percig jelez, csak utana alszik el");

  bool logged = false;
  for (uint32_t i = 0; i < rtcEvNext && i < 32; i++)
    if (rtcEvents[i].code == EV_FATAL_C && rtcEvents[i].param == 4) logged = true;
  CHECK(logged, "a naploba is bekerul (FATAL, param=4)");
}

static void scX12() {
  // A jelzes ugyanaz, mint a tobbi vegzetes hibanal: a ket LED EGYUTT villog
  // (a beragadt gombnal felvaltva) - igy ranezesre megkulonboztetheto.
  coldBoot(true, "TestNet", "pw", "", "");
  setup();
  g_fsWritable = false; g_fsRemoveOk = false;
  g_pinRead[2] = LOW;
  g_log.clear();
  try { for (int i = 0; i < 200000; i++) { wifiresetbutton(); delay(10); } }
  catch (...) {}
  int together = 0, opposite = 0;
  for (size_t i = 0; i + 1 < g_log.size(); i++) {
    // A ket digitalWrite egymas utan jon; a parokat nezzuk.
    if (g_log[i] == "pin6=HIGH" && g_log[i+1] == "pin5=HIGH") together++;
    if (g_log[i] == "pin6=LOW"  && g_log[i+1] == "pin5=LOW")  together++;
    if (g_log[i] == "pin6=HIGH" && g_log[i+1] == "pin5=LOW")  opposite++;
    if (g_log[i] == "pin6=LOW"  && g_log[i+1] == "pin5=HIGH") opposite++;
  }
  CHECK(together > 100, "a ket LED EGYUTT villog (vegzetes hiba jelzese)");
  CHECK(opposite == 0, "sosem ellentetes fazisban (az a beragadt gomb jele)");
}

static void scX13() {
  // A vegzetes jelzes alatt a reset gomb az egyetlen kiut - annak viszont
  // mukodnie kell, kulonben csak aramtalanitassal lehetne kimaszni.
  coldBoot(true, "TestNet", "pw", "", "");
  setup();
  g_fsWritable = false; g_fsRemoveOk = false;
  g_pinRead[2] = LOW;
  // A reset gombot is nyomva tartjuk. A fatalHalt() blokkol es nem ter vissza,
  // ezert a teszt ciklusabol menet kozben nem lehetne "megnyomni" - a
  // felhasznalo viszont barmikor lenyomhatja, tehat eleve nyomva modellezzuk.
  g_pinRead[3] = LOW;
  const uint32_t t0 = g_millis;
  bool restarted = false, slept = false;
  try { for (int i = 0; i < 200000; i++) { wifiresetbutton(); delay(10); } }
  catch (RestartSignal&) { restarted = true; }
  catch (DeepSleepSignal&) { slept = true; }
  CHECK(restarted, "a reset gomb a hibajelzes alatt is ujraindit");
  CHECK(!slept, "tehat nem varja ki az 5 percet");
  CHECK(g_millis - t0 < 5u * 60 * 1000, "meg az 5 perces hatarido elott");
}

static void scX14() {
  // Regresszio: a SIKERES torles tovabbra is egyszeru ujrainditas legyen.
  coldBoot(true, "TestNet", "pw", "", "");
  setup();
  g_pinRead[2] = LOW;
  bool restarted = false, slept = false;
  try { for (int i = 0; i < 20; i++) { wifiresetbutton(); delay(10); } }
  catch (RestartSignal&) { restarted = true; }
  catch (DeepSleepSignal&) { slept = true; }
  CHECK(restarted && !slept, "sikeres torles -> ujrainditas, nem hibajelzes");
  CHECK(deviceMode != (DeviceMode)2, "nem megy MODE_FATAL-ba");
}

// --- A query-string parameter nem konfiguralhat -----------------------------
static void scX9() {
  // A request->params() a GET query parametereket IS visszaadja. Ha ezeket nem
  // szurnenk ki, egy sima link (/?ssid=...) atirhatna a konfiguraciot.
  coldBoot(false, "", "", "", "");
  setup();
  g_fs["/ssid.txt"] = "EredetiHalozat";
  AsyncWebServerRequest req;
  req.addParam("ssid", "TamadoHalozat", false);   // isPost() == false
  req.addParam("pass", "tamado", false);
  g_handlers["/#2"](&req);
  CHECK(g_fs["/ssid.txt"] == "EredetiHalozat", "a query parameter NEM irja at az SSID-t");
  CHECK(req._code == 500, "SSID nelkuli mentes -> 500");
  CHECK(!restartRequested(), "es nem indit ujra");
}
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
