manszabi/bazsi-router-reboot/test/stubs/Arduino.h

#pragma once
#include <cstdint>
#include <cstdio>
#include <cstring>
#include <strings.h>  // strcasecmp - a String::equalsIgnoreCase mogott
#include <cctype>
#include <cstdlib>
#include <string>
#include <vector>
#include <map>

// ---------------------------------------------------------------------------
// A core makroi. NEM azert vannak itt, mert a sketch mind hasznalja, hanem
// hogy a harness elkapja a NEVUTKOZESEKET. Ezek makrok, tehat barmely azonos
// nevu lokalis valtozobol vagy fuggvenybol a valodi forditason szemet lesz -
// pl. "static const char HEX[]" -> "static const char 16[]". A hoston enelkul
// csendben lefordul, az eszkozon meg elhasal; pontosan ezt a kulonbseget
// zarjuk ki. Az ertekek a 3.3.11 fejleceibol szo szerint valok.
//
// esp32-hal-gpio.h
#define LOW               0x0
#define HIGH              0x1
#define INPUT             0x01
#define OUTPUT            0x03
#define PULLUP            0x04
#define INPUT_PULLUP      0x05
#define PULLDOWN          0x08
#define INPUT_PULLDOWN    0x09
#define OPEN_DRAIN        0x10
#define OUTPUT_OPEN_DRAIN 0x13
#define ANALOG            0xC0
#define DISABLED          0x00
// Megszakitas modok (Arduino.h / esp32-hal-gpio.h)
#define RISING   0x01
#define FALLING  0x02
#define CHANGE   0x03
#define ONLOW    0x04
#define ONHIGH   0x05
// Print.h szamrendszerek
#define DEC 10
#define HEX 16
#define OCT 8
#define BIN 2
// Arduino.h konstansok
#define PI         3.1415926535897932384626433832795
#define HALF_PI    1.5707963267948966192313216916398
#define TWO_PI     6.283185307179586476925286766559
#define EULER      2.718281828459045235360287471352
#define DEG_TO_RAD 0.017453292519943295769236907684886
#define RAD_TO_DEG 57.295779513082320876798154814105
#define LSBFIRST 0
#define MSBFIRST 1
#define DEFAULT  1
#define EXTERNAL 0
#define SERIAL   0x0
#define DISPLAY  0x1
#define NOT_A_PIN        -1
#define NOT_A_PORT       -1
#define NOT_AN_INTERRUPT -1
#define NOT_ON_TIMER     0
// ---------------------------------------------------------------------------
// A valodi variants/XIAO_ESP32C3/pins_arduino.h szo szerint. Ott ezek NEM
// makrok, hanem static const uint8_t-k - itt is azok, hogy a tipusuk is
// egyezzen (a #define int-et adna). Mind a 11 lab szerepel, nem csak az
// altalunk hasznaltak: igy egy kesobbi D2/D6... hasznalat is a valos szamot
// kapja, es egy azonos nevu sajat valtozo itt is utkozne.
static const uint8_t TX = 21;
static const uint8_t RX = 20;
static const uint8_t SDA = 6;
static const uint8_t SCL = 7;
static const uint8_t SS = 20;
static const uint8_t MOSI = 10;
static const uint8_t MISO = 9;
static const uint8_t SCK = 8;
static const uint8_t A0 = 2;
static const uint8_t A1 = 3;
static const uint8_t A2 = 4;
static const uint8_t D0 = 2;
static const uint8_t D1 = 3;
static const uint8_t D2 = 4;
static const uint8_t D3 = 5;
static const uint8_t D4 = 6;
static const uint8_t D5 = 7;
static const uint8_t D6 = 21;
static const uint8_t D7 = 20;
static const uint8_t D8 = 8;
static const uint8_t D9 = 9;
static const uint8_t D10 = 10;

// --- megszakitasok ---
// A sketch attachInterrupt()-tel reteszeli a gombnyomasokat. A harness NEM
// szimulal valodi megszakitasokat: a regisztralt kezelot a teszt hivja meg
// kezzel (simIsr), miutan beallitotta a lab allapotat. Igy pontosan az
// ellenorizheto, amit a valodi ISR is latna.
typedef void (*IsrFn)();
extern std::map<int, IsrFn> g_isr;
extern std::map<int, int>   g_isrMode;
void attachInterrupt(uint8_t pin, IsrFn fn, int mode);
void detachInterrupt(uint8_t pin);
static inline uint8_t digitalPinToInterrupt(uint8_t p) { return p; }
// A teszt ezzel "sut el" egy elt: eloszor allitsd be a g_pinRead[pin]-t.
void simIsr(int pin);

// --- gomb-mintavetelezes merese (lasd main_stub.cpp) ---
extern bool     g_btnTrack;
extern uint32_t g_btnLastPoll;
extern uint32_t g_btnMaxGap;

// --- szimulált idő / naplózás ---
extern uint32_t g_millis;
extern std::vector<std::string> g_log;
extern std::vector<std::string> g_serialLog;  // a soros kimenet sorai
extern std::map<int,int> g_pinState;
extern std::map<int,int> g_pinRead;
extern bool g_serialOn;
void simLog(const std::string& s);

struct RestartSignal { };
struct DeepSleepSignal { uint64_t us; };

// FONTOS: az ESP32-C3 32 bites, ott az `unsigned long` = 32 bit, tehat a
// millis() uint32_t-t ad. A hoston viszont az `unsigned long` 64 BITES - ha a
// stub is azt adna vissza, a "millis() - start" korbefordulas-biztos idiomak
// MASKEPP viselkednenek, mint a celhardveren, es a wrap koruli viselkedes
// tesztelese ertelmetlen lenne. Ezert itt kifejezetten uint32_t.
uint32_t millis();
void pinMode(uint8_t, uint8_t);
void digitalWrite(uint8_t, uint8_t);
int digitalRead(uint8_t);
void yield();
void delay(uint32_t ms);
// Minden delay()-nel meghivodik, ha be van allitva: ezzel modellezik a tesztek,
// hogy egy masik task kozben befejez valamit (lasd main_stub.cpp).
extern void (*g_onDelay)();
void feedLoopWDT();
void enableLoopWDT();
void disableLoopWDT();
// FreeRTOS kritikus szakasz (a valodiban makro + spinlock). A hoston nincs
// valodi parhuzamossag; a stub a hivasok kiegyensulyozottsagat szamolja, hogy
// egy kritikus szakaszban felejtett return kimutathato legyen.
struct portMUX_TYPE { int dummy; };
#define portMUX_INITIALIZER_UNLOCKED {0}
void portENTER_CRITICAL(portMUX_TYPE*);
void portEXIT_CRITICAL(portMUX_TYPE*);
extern int g_criticalDepth;     // aktualis beagyazottsag (0 = nincs nyitva)
extern int g_criticalMaxDepth;
extern int g_criticalEnters;  // megnyitott kritikus szakaszok szama
extern bool     g_wdtEnabled;
extern uint32_t g_wdtTimeoutMs;
extern uint32_t g_wdtIdleMask;
extern bool     g_wdtPanic;
extern uint32_t g_wdtMaxFeedGap;   // leghosszabb szakasz etetés nélkül
extern uint32_t g_wdtLastFeed;
extern uint32_t g_wdtFeedBeforeEnable;  // etetes a feliratkozas ELOTT
extern bool     g_wdtInited;            // fut-e mar a TWDT (ESP_TASK_WDT_INIT)
extern bool     g_wdtInitFails;         // az esp_task_wdt_init() hibat adjon
extern bool     g_wdtReconfigureFails;  // az esp_task_wdt_reconfigure() hibazzon
extern uint32_t g_wdtFeedNotSubscribed; // ennyi log_e() sor menne ki
extern bool     g_wdtTrack;
extern bool g_wdtInProgram;        // a setup()/loop() belsejeben vagyunk?
void feedLoopWDT_fromCore();       // a core per-iteracios etetese (nem naploz)
void wdtAdvanceTime(uint32_t ms);  // eltelt ido bejelentese az etetes-meresnek
// --- a rele behuzott allapotanak merese (lasd main_stub.cpp) ---
extern uint32_t g_relayMaxHighMs;   // a leghosszabb HIGH szakasz
extern uint32_t g_relayHighSince;
extern bool     g_relayIsHigh;
void relayTrackTime();
void wdtNoteTime();
int64_t esp_timer_get_time();
void esp_sleep_enable_timer_wakeup(uint64_t);
void esp_deep_sleep_start();
void esp_sleep_disable_wakeup_source(int);
#define ESP_SLEEP_WAKEUP_ALL 0
// Mindket nev letezik, hogy a sketch mindket aga leforduljon.
int esp_sleep_enable_gpio_wakeup_on_hp_periph_powerdown(uint64_t, int);
int esp_deep_sleep_enable_gpio_wakeup(uint64_t, int);
extern int g_gpioWakeResult;   // 0 = sikeres armolas, mas = hiba
#define ESP_GPIO_WAKEUP_GPIO_LOW 0
#define BIT(n) (1ULL << (n))
#define F(x) (x)
// A valódi RTC_DATA_ATTR deep sleepet túlélő memóriába tesz. A teszt egyetlen
// processzben fut, ezért itt sima globális - a persztenciát kézzel modellezzük.
#define RTC_DATA_ATTR
extern uint64_t g_wakeupUs;
extern uint64_t g_gpioWakeMask;
extern int g_gpioWakeMode;
extern bool g_serialEcho;
size_t strlcpy(char*, const char*, size_t);

class String {
public:
  String() {}
  String(const char* s) : s_(s ? s : "") {}
  String(int v) { char b[24]; snprintf(b, sizeof(b), "%d", v); s_ = b; }
  String(unsigned v) { char b[24]; snprintf(b, sizeof(b), "%u", v); s_ = b; }
  const char* c_str() const { return s_.c_str(); }
  size_t length() const { return s_.size(); }
  bool equals(const char* o) const { return s_ == o; }
  // core: String::equalsIgnoreCase(const String&) - a fejlecek erteke tetszoleges
  // kis/nagybetus lehet, a HTTP fejlecek ertekei nem case-sensitive-ek.
  bool equalsIgnoreCase(const char* o) const {
    return strcasecmp(s_.c_str(), o ? o : "") == 0;
  }
  void trim() {}
  String& operator+=(const char* o) { s_ += o; return *this; }
  String& operator+=(const String& o) { s_ += o.s_; return *this; }
  bool operator==(const char* o) const { return s_ == o; }
private:
  std::string s_;
};

class Stream {
public:
  virtual ~Stream() {}
  virtual int read() { return -1; }
  virtual int available() { return 0; }
  size_t readBytes(char*, size_t) { return 0; }
  size_t readBytesUntil(char, char*, size_t) { return 0; }
  void setTimeout(unsigned long) {}
};

class IPAddress;

class Print {
public:
  size_t print(const IPAddress&);
  size_t println(const IPAddress&);
  size_t print(const char* s) { buf_ += s; return 0; }
  size_t print(const String& s) { buf_ += s.c_str(); return 0; }
  size_t print(int v) { buf_ += std::to_string(v); return 0; }
  size_t print(unsigned v) { buf_ += std::to_string(v); return 0; }
  size_t print(unsigned long v) { buf_ += std::to_string(v); return 0; }
  size_t print(long v) { buf_ += std::to_string(v); return 0; }
  size_t println(const char* s) { buf_ += s; flushLine(); return 0; }
  size_t println(const String& s) { buf_ += s.c_str(); flushLine(); return 0; }
  size_t println(int v) { buf_ += std::to_string(v); flushLine(); return 0; }
  size_t println(unsigned v) { buf_ += std::to_string(v); flushLine(); return 0; }
  size_t println(unsigned long v) { buf_ += std::to_string(v); flushLine(); return 0; }
  size_t println(long v) { buf_ += std::to_string(v); flushLine(); return 0; }
  size_t println() { flushLine(); return 0; }
  // A valodi Print::printf formaz es kiir. Ha ezt no-opkent hagyjuk, a
  // Serial.printf()-fel irt diagnosztika (konfig fajlok irasa/olvasasa/torlese,
  // POST parameterek) LATHATATLAN a tesztek szamara - vagyis ellenorizhetetlen.
  size_t printf(const char* f, ...);
protected:
  void flushLine();
  void emit(const char* s);
  std::string buf_;
};

// A soros port ELETCIKLUSA merheto: mikor indult, mikor ment ki az elso sor
// (a CDC beallasa utan kell), lezarult-e rendezetten (flush, majd end), es
// irtunk-e barmit a lezaras UTAN (az elveszne).
extern unsigned long g_serialBaud;
extern uint32_t g_serialFirstWriteMs;   // az elso kiirt sor ideje
extern int      g_serialWritesAfterEnd; // end() utani irasok szama
extern bool     g_serialFlushedAll;     // az utolso iras ota volt-e flush

// A SOROS BEMENET. A parancs-feldolgozashoz (serialCommands) modellezni kell
// azt is, ami a portra ERKEZIK - eddig a stub csak a kimenetet ismerte. A
// teszt a g_serialIn-be teszi a bejovo bajtokat.
extern std::string g_serialIn;
// Az available() > 0, de a read() -1-et ad. Valodi UART-on ez elofordulhat:
// a FIFO-t egy megszakitas a ket hivas KOZOTT is kiuritheti.
extern bool g_serialReadLies;

class HardwareSerial : public Print {
public:
  void begin(unsigned long b) { g_serialOn = true; g_serialBaud = b; }
  void end();
  void flush();
  operator bool() const { return true; }
  int available() { return (int)g_serialIn.size(); }
  int read() {
    if (g_serialReadLies) return -1;
    if (g_serialIn.empty()) return -1;
    const int c = (unsigned char)g_serialIn[0];
    g_serialIn.erase(0, 1);
    return c;
  }
};
extern HardwareSerial Serial;

// A core IPAddress-e IPv6-ot is kezel, es ez itt szamit:
//  - fromString() eloszor IPv4-kent, majd IPv6-kent probal (IPAddress.cpp),
//    tehat a "::1" is ervenyes cimnek szamit;
//  - az uint32_t konverzio viszont IPv6-ra 0-t ad (IPAddress.h:83), es a
//    WiFi.config() pont ezt hasznalja (NetworkInterface.cpp:390).
// A stub ezt a ketto egyuttest modellezi.
enum IPType { IPv4, IPv6 };

class IPAddress : public Print {
public:
  IPAddress() { o[0]=o[1]=o[2]=o[3]=0; }
  IPAddress(uint32_t) { o[0]=o[1]=o[2]=o[3]=0; }
  IPAddress(uint8_t a, uint8_t b, uint8_t c, uint8_t d) { o[0]=a;o[1]=b;o[2]=c;o[3]=d; }
  bool fromString(const char* s) {
    if (!s) return false;
    unsigned a,b,c,d; char extra;
    if (sscanf(s, "%u.%u.%u.%u%c", &a,&b,&c,&d,&extra) == 4
        && a<=255 && b<=255 && c<=255 && d<=255) {
      o[0]=(uint8_t)a;o[1]=(uint8_t)b;o[2]=(uint8_t)c;o[3]=(uint8_t)d;
      t_ = IPv4; return true;
    }
    return fromString6(s);
  }
  // Csak annyira reszletes, amennyire a viselkedes szamit: hexa csoportok
  // kettosponttal, legfeljebb egy "::" tomoritessel.
  bool fromString6(const char* s) {
    bool sawColon = false, sawDouble = false;
    for (const char* p = s; *p; p++) {
      if (*p == ':') {
        if (p[1] == ':') { if (sawDouble) return false; sawDouble = true; p++; }
        sawColon = true;
      } else if (!isxdigit((unsigned char)*p)) {
        return false;
      }
    }
    if (!sawColon) return false;
    o[0]=o[1]=o[2]=o[3]=0;
    t_ = IPv6; return true;
  }
  IPType type() const { return t_; }
  // IPAddress.h:83 - IPv6-ra szandekosan 0
  operator uint32_t() const {
    return t_ == IPv4 ? ((uint32_t)o[0]<<24 | (uint32_t)o[1]<<16 | (uint32_t)o[2]<<8 | o[3]) : 0u;
  }
  std::string str() const {
    if (t_ == IPv6) return "<ipv6>";
    char t[20]; snprintf(t,sizeof(t),"%u.%u.%u.%u",o[0],o[1],o[2],o[3]); return t;
  }
  bool isZero() const { return !o[0] && !o[1] && !o[2] && !o[3]; }
  uint8_t o[4];
private:
  IPType t_ = IPv4;
};

inline size_t Print::print(const IPAddress& a) { buf_ += a.str(); return 0; }
inline size_t Print::println(const IPAddress& a) { buf_ += a.str(); flushLine(); return 0; }

// A valodi getEfuseMac() az esp_efuse_mac_get_default()-tel 6 bajtot ir egy
// uint64_t-be (Esp.cpp), a felso 2 bajt nulla marad. A tesztekben allithato,
// hogy a "masik lapkan nem mukodik" viselkedes ellenorizheto legyen.
extern uint64_t g_efuseMac;

// A heap merhetove tetele. A valodi ertekeket a forgatokonyv allitja; a
// g_heapDrainPerCall-lal modellezheto egy LASSU SZIVARGAS is (minden lekerdezes
// ennyivel kevesebbet ad vissza), ami nelkul a kuszob atlepese nem lenne
// jatszhato.
extern uint32_t g_freeHeap;
extern uint32_t g_minFreeHeap;
extern uint32_t g_maxAllocHeap;
extern uint32_t g_heapDrainPerCall;
extern int      g_heapQueries;

class EspClass {
public:
  void restart() { simLog("ESP.restart"); throw RestartSignal{}; }
  const char* getChipModel() { return "ESP32-C3"; }
  uint64_t getEfuseMac() { return g_efuseMac; }
  uint32_t getFreeHeap();
  uint32_t getMinFreeHeap() { return g_minFreeHeap; }
  uint32_t getMaxAllocHeap();
};
extern EspClass ESP;

// --- Ido (NTP) modell ------------------------------------------------------
// A valodi eszkozon a configTzTime() elinditja az SNTP klienst, es a
// rendszerora a hatterben all be. A harness ezt egyetlen valtozoval modellezi:
// g_epochNow = 0 -> nincs szinkron (a time() 1970-et ad), egyebkent ennyi.
extern uint32_t g_epochNow;
extern int      g_ntpStarts;
void configTzTime(const char* tz, const char* server);

// A time() ATIRANYITASA. A hoston a valodi time() a mai datumot adna, es
// azzal a "nincs meg oraszinkron" ag SOSEM futna le - epp az, amit meg kell
// merni. A <time.h>-t ITT hozzuk be, es CSAK utana definialjuk a makrot: a
// sketch kesobbi #include <time.h> sora igy az include guard miatt ures, tehat
// a makro sosem ir at egy fejlecbeli deklaraciot.
#include <time.h>
time_t stub_time(time_t* out);
#define time(p) stub_time(p)
