manszabi/bazsi-router-reboot/test/stubs/WiFi.h

#pragma once
#include <Arduino.h>
#define WL_CONNECTED 3
#define WL_DISCONNECTED 6
#define WL_NO_SSID_AVAIL 1
#define WL_CONNECT_FAILED 4
typedef int wl_status_t;
#define WIFI_STA 1
#define WIFI_AP 2

// Olvasható HTTP-törzset hordozó kliens (a HTTPClient stub tölti fel)
// A "beragadt szerver" modellezese: a kapcsolat EL, de nem jon tobb adat.
// available() = 0 es connected() = true - ilyenkor a valodi socket olvasas a
// sajat fogadasi timeoutjaig blokkolna, a sketchnek a sajat hataridejevel kell
// kilepnie.
extern bool g_httpStall;

class WiFiClient : public Stream {
public:
  virtual bool connected() { return g_httpStall ? true : (pos_ < data_.size()); }
  int read() override { return pos_ < data_.size() ? (unsigned char)data_[pos_++] : -1; }
  int available() override { return (int)(data_.size() - pos_); }
  void setData(const std::string& d) { data_ = d; pos_ = 0; }
private:
  std::string data_; size_t pos_ = 0;
};

// Wi-Fi rádió szimuláció.
struct WifiSim {
  bool willConnect = false;      // sikerül-e a csatlakozás
  // A hálózat csak ettől az időponttól elérhető (0 = azonnal). Ezzel
  // modellezhető, hogy a router az ESP után percekkel áll fel.
  uint32_t availableFrom = 0;
  // Mit adjon vissza a status() amikor nincs kapcsolat (WL_CONNECT_FAILED-del
  // modellezheto a rossz jelszo).
  int failStatus = WL_DISCONNECTED;
  // Rossz jelszo. NEM egyszeruen failStatus = WL_CONNECT_FAILED, mert a core
  // az ELSO disconnect esemenyt meg nem minositi hitelesitesi hibanak:
  // STA.cpp:148 szerint a feltetel "(reason == WIFI_REASON_AUTH_FAIL) &&
  // !first_connect", a first_connect (STA.cpp:117) pedig csak az elso
  // disconnect utan valt false-ra - es sosem all vissza true-ra. Addig a
  // status WL_DISCONNECTED marad, vagyis EGYETLEN probalkozasbol a rossz
  // jelszo lathatatlan lenne.
  bool authFail = false;
  uint32_t latencyMs = 500;      // mennyi idő alatt jön létre
  bool begun = false;            // fut-e a begin() óta kapcsolódás
  uint32_t beginAt = 0;
  int mode = 0;
  bool radioOff = true;
  // A netif statikus IP konfigja. disconnect(true) leállítja a WiFi-t,
  // ilyenkor a valódi ESP32 core-ban ez elveszik -> DHCP.
  bool staticApplied = false;
  IPAddress cfgIp, cfgGw, cfgDns1, cfgDns2;
  int beginCount = 0;
  int configCount = 0;
  bool configFails = false;      // a WiFi.config() hibat adjon vissza
  int softApCount = 0;
  std::string apPass;            // amivel a softAP()-ot hivtuk
  std::string lastPass, lastSsid;  // amivel a WiFi.begin()-t hivtuk
  void reset() { *this = WifiSim(); }
};
extern WifiSim wifiSim;

class WiFiClass {
public:
  void mode(int m) {
    wifiSim.mode = m;
    simLog(m == WIFI_AP ? "WiFi.mode(AP)" : "WiFi.mode(STA)");
    if (m == WIFI_AP) { wifiSim.begun = false; }
  }
  void begin(const char* s, const char* p) {
    // A jelszot ROGZITJUK: enelkul semmi nem ellenorizne, hogy a radioig a
    // NYILT jelszo jut-e el, es nem a fajlban tarolt kodolt forma.
    wifiSim.lastPass = p ? p : "";
    wifiSim.lastSsid = s ? s : "";
    wifiSim.begun = true; wifiSim.beginAt = g_millis; wifiSim.radioOff = false;
    wifiSim.beginCount++;
    simLog(std::string("WiFi.begin(") + (s ? s : "") + ")");
  }
  // A sikertelen csatlakozas statusza. Az authFail agat lasd a WifiSim-nel.
  wl_status_t failNow() {
    if (wifiSim.authFail) {
      return wifiSim.beginCount >= 2 ? WL_CONNECT_FAILED : WL_DISCONNECTED;
    }
    return (wl_status_t)wifiSim.failStatus;
  }
  wl_status_t status() {
    if (!wifiSim.begun || !wifiSim.willConnect) return failNow();
    if (g_millis < wifiSim.availableFrom) return failNow();
    // a társítás a begin() vagy a hálózat megjelenése közül a későbbitől indul
    const uint32_t from = wifiSim.beginAt > wifiSim.availableFrom
                          ? wifiSim.beginAt : wifiSim.availableFrom;
    return (g_millis - from) >= wifiSim.latencyMs ? WL_CONNECTED : failNow();
  }
  String SSID() { return String("TestNet"); }
  IPAddress localIP() { return wifiSim.staticApplied ? wifiSim.cfgIp : IPAddress(192,168,1,77); }
  int RSSI() { return -50; }
  bool config(IPAddress ip, IPAddress gw, IPAddress sn, IPAddress d1 = IPAddress(), IPAddress d2 = IPAddress()) {
    (void)sn;
    // A valodi NetworkInterface::config() false-t ad, ha nincs netif, vagy ha
    // a DNS beallitasa hibazik (NetworkInterface.cpp:378, :411).
    if (wifiSim.configFails) { wifiSim.configCount++; simLog("WiFi.config_FAIL"); return false; }
    wifiSim.staticApplied = true; wifiSim.configCount++;
    wifiSim.cfgIp = ip; wifiSim.cfgGw = gw; wifiSim.cfgDns1 = d1; wifiSim.cfgDns2 = d2;
    simLog("WiFi.config(ip=" + ip.str() + ",gw=" + gw.str() + ",dns1=" + d1.str() + ",dns2=" + d2.str() + ")");
    return true;
  }
  void disconnect(bool off) {
    wifiSim.begun = false;
    if (off) {
      wifiSim.radioOff = true;
      // esp_wifi_stop() -> a netif statikus IP konfigja elveszik
      wifiSim.staticApplied = false;
    }
    simLog(off ? "WiFi.disconnect(true)" : "WiFi.disconnect(false)");
  }
  void persistent(bool v) { simLog(v ? "WiFi.persistent(true)" : "WiFi.persistent(false)"); }
  bool softAP(const char* n, const char* p) {
    wifiSim.apPass = p ? p : "";
    // A valodi APClass::create() 8 karakter alatt hibat ad es NEM indit AP-t.
    if (!wifiSim.apPass.empty() && wifiSim.apPass.size() < 8) {
      simLog("softAP_FAIL_short_passphrase");
      return false;
    }
    wifiSim.softApCount++;
    simLog(std::string("WiFi.softAP(") + n + ")"); return true;
  }
  IPAddress softAPIP() { return IPAddress(192,168,4,1); }
};
extern WiFiClass WiFi;
