manszabi/bazsi-router-reboot/test/stubs/esp_idf_version.h

#pragma once
// Alapertelmezes: IDF 5.x - ezt hasznalja az ESP32 Arduino 3.3.11
// (esp32-arduino-libs-idf-release_v5.5). A Makefile a masik agat is
// leforditja -DESP_IDF_VERSION_MAJOR=6 -tal.
#ifndef ESP_IDF_VERSION_MAJOR
#define ESP_IDF_VERSION_MAJOR 5
#endif
