manszabi/bazsi-router-reboot/test/stubs/esp_system.h

#pragma once
#include <Arduino.h>
// Az IDF v5.5 esp_reset_reason_t felsorolásának releváns része
typedef enum {
  ESP_RST_UNKNOWN, ESP_RST_POWERON, ESP_RST_EXT, ESP_RST_SW, ESP_RST_PANIC,
  ESP_RST_INT_WDT, ESP_RST_TASK_WDT, ESP_RST_WDT, ESP_RST_DEEPSLEEP,
  ESP_RST_BROWNOUT, ESP_RST_SDIO, ESP_RST_USB, ESP_RST_JTAG,
  ESP_RST_EFUSE, ESP_RST_PWR_GLITCH, ESP_RST_CPU_LOCKUP
} esp_reset_reason_t;
extern esp_reset_reason_t g_resetReason;
esp_reset_reason_t esp_reset_reason(void);
