manszabi/bazsi-router-reboot/(commit log)

2026-03-03 Fix 17 bugs, dead code issues, and security problems in ESP32-C3 router reboot firmware
    [bazsi_router_reboot.ino]
2026-08-26 Fix reset-pulse, config-portal and DNS bugs; modernize firmware
    Bugfixes:
    - reset_device(): the pulse-end check compared a timestamp taken *before*
    the serial prints against the pulse start taken *after* them. The unsigned
    subtraction underflowed, so the 90 s power-off pulse usually ended on the
    very first call and the router was never actually power-cycled. The first
    step now returns early.
    - Static IP config passed no DNS servers, so name resolution (and therefore
    both HTTP tests) always failed when a static IP was configured. Gateway is
    now DNS1 with 1.1.1.1 as DNS2.
    - AP config portal died after ~3 minutes: loop() ran handleFirstStart() in
    AP mode, which called reconnectWif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
    [bazsi_router_reboot.ino]
2026-08-26 Longer boot/reset waits, second ping target on Google DNS
    - firstStartDelay: 3 -> 10 perc
    - RESET_DELAY: 6 -> 10 perc (több idő a router bootolásához)
    - testInternet3() -> testInternetPing(target, name): a ping cél paraméter
    lett, így a 3-as ciklus a Google 8.8.8.8-at pingeli a Cloudflare 1.1.1.1
    helyett. Két külön szolgáltató esetén az egyikük kiesése nem tűnik
    internetkimaradásnak.
    Claude-Session: https://claude.ai/code/session_01T9e4FeVLQQfDBZU8KrKVeh
    [bazsi_router_reboot.ino]
2026-08-26 Fix static IP loss on reconnect, add button wake, document relay float
    Wi-Fi (mind ellenőrizve az arduino-esp32 forrásában, nem emlékezetből):
    - A router reset utáni újracsatlakozás elvesztette a statikus IP-t és a DNS-t.
    WiFi.disconnect(true) -> STA.end() -> enableSTA(false) -> mode(0) ->
    STAClass::onDisable(), ami _esp_netif = NULL; destroyNetif(). Ezzel a netif
    IP/DNS beállítása és az ESP_NETIF_HAS_STATIC_IP_BIT is eltűnik, a következő
    STAClass::connect() pedig a bit hiányában config()-ot hív -> DHCP. A nyers
    WiFi.begin() helyett most initWiFi() fut, ami újra alkalmazza a konfigot.
    - initWiFi() nem bontja le a már élő kapcsolatot: ha a status() már
    WL_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
    [bazsi_router_reboot.ino]
2026-08-26 Guard deep sleep GPIO wakeup against the ESP-IDF 6.0 API rename
    Az arduino-esp32 idf_component.yml-je idf ">=5.3,<6.2" tartományt deklarál,
    tehát IDF 6.x-alapú core-ral is fordulhat a sketch. Az IDF 6 viszont
    eltávolította az esp_deep_sleep_enable_gpio_wakeup() nevet, helyette
    esp_sleep_enable_gpio_wakeup_on_hp_periph_powerdown() van (a v5.4-ben még a
    régi név él). ESP_IDF_VERSION_MAJOR alapján most mindkét ág fordul.
    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
2026-08-26 Document the verified target configuration (core 3.3.11 / IDF v5.5)
    A felhasználó által használt board package: ESP32 Arduino 3.3.11, amely az
    esp32-arduino-libs-idf-release_v5.5-b774170f csomagot tartalmazza. A firmware
    viselkedését meghatározó feltételezések ezen a konkrét verzión lettek
    ellenőrizve a core és az ESP-IDF forrásában, nem a master ágon:
    - WiFiSTAClass::disconnect(bool wifioff, bool eraseap, ...) - a disconnect(true)
    nem törli a mentett hálózatot
    - NetworkInterface::config() STA ága a DNS-t szó szerint veszi, gateway-fallback
    nélkül
    - STAClass::onDisable() megsemmisíti a netifet, ezért veszik el a statikus IP
    - esp_deep_sleep_enable_gpio_wakeup()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
2026-08-26 Add host test suite; fallback config form; verify APIs against core 3.3.11
    Tesztek (test/, `make test`):
    - A tényleges sketch-et fordítja host gcc-vel, stub ESP32 API-k felett.
    81 ellenőrzés, 24 forgatókönyv, hardver nélkül futtatható.
    - A stub szignatúrák az ESP32 Arduino 3.3.11 / ESP-IDF v5.5 forrásából
    származnak, a pin-számok a valódi XIAO_ESP32C3 variantból.
    - Minden forgatókönyv külön processzben fut (fork), mert a sketch globális
    állapota egyébként átszivárogna az esetek között. A fejlesztés közben ez
    két hamis pozitívot is leleplezett a tesztekben.
    - Lefedve: Wi-Fi (portál, DHCP/statikus IP, DNS, timeout, netif-elvesztés),
    deep sleep (ber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
2026-08-26 Add watchdog protection against firmware hangs
    Ha a program megakad, a legrosszabb eset az, hogy a relé bekapcsolt
    állapotban ragad és a router tartósan áram nélkül marad. Az újraindítás ezt
    megoldja, mert a setup() a relét azonnal LOW-ra állítja.
    Az ESP-IDF task watchdogja alapból fut, de három okból nem védett meg
    (mind ellenőrizve a 3.3.11 / IDF v5.5 forrásában):
    - az Arduino loop taskja nincs ráiratkozva (main.cpp: loopTaskWDTEnabled=false)
    - ESP_TASK_WDT_PANIC alapértéke 'n', azaz timeoutkor csak figyelmeztet
    - az 5 mp-es alap timeout rövidebb, mint a firmware szándékos blokkolásai
    initWatchdog() ezért explicit módon: 60 mp timeout (a nem etethető http.GE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
2026-08-26 Raise watchdog timeout to 90 s
    Kérésre nagyobb tartalék: 60 -> 90 mp. A leghosszabb nem etethető blokkolás
    továbbra is a http.GET() (~15 mp), így a tartalék négyszeresről hatszorosra nő.
    A WDT2/WDT3 tesztek mostantól a ténylegesen beállított g_wdtTimeoutMs-hez
    mérik a leghosszabb etetés nélküli szakaszt, nem beégetett számhoz, így a
    konstans további hangolása nem teszi hamis zöldre őket.
    Dokumentálva, hogy a TWDT timeoutja globális, tehát az AsyncTCP saját
    taskjának figyelése is 5 mp-ről 90 mp-re lazul (CONFIG_ASYNC_TCP_USE_WDT=1
    ESP32-n; a könyvtár csak LibreTiny alatt kapcsolja ki). Gyakorlati hatása
    nincs, mert az aszinkron szerver csak AP konfigurác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
2026-08-26 Harden LittleFS error handling
    Eddig minden fájlművelet hibája csak a soros portra került ki, a hívók pedig
    figyelmen kívül hagyták. A legkellemetlenebb következmény: ha a beállító
    oldalról mentés elbukott, az eszköz akkor is "Done"-t válaszolt és újraindult,
    majd - mivel semmit nem mentett - ismét AP módban jött fel. A felhasználó
    végtelen körben próbálkozott volna, magyarázat nélkül.
    - writeConfigValue() a writeFile() helyett: ellenőrzi a print() visszatérési
    értékét, majd VISSZAOLVASSA és összeveti a tartalmat. Erre azért van
    szükség, mert a File::close() és a File::flush() is void a core-ban, tehát
    a lezáráskor jelentkező hiba (pl. m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
    [LittleFS.h, bazsi_router_reboot.ino, main_stub.cpp, test_main.cpp]
2026-08-26 Halt with fast LED blink when the config cannot be loaded
    A wifi beallitasok a LittleFS-en vannak. Ha nem tolthetok be, a program eddig
    ugy futott tovabb, mintha nem lenne konfiguracio: AP modba lepett, ahol a
    mentes is elbukott volna. Most megkulonbozteti a ket helyzetet.
    readConfigValue() harom allapotot ad vissza:
    - CONFIG_MISSING: a fajl nem letezik. Ez NEM hiba - elso indataskor es a
    wifireset gomb utan is ez a helyzet -> AP beallito portal.
    - CONFIG_OK: beolvasva. Az ures ertek is ervenyes, mert a wifireset csonkolt
    fajlt hagy hatra -> AP beallito portal.
    - CONFIG_ERROR: a fajl letezik, de nem nyithato meg vagy rovid olvasas jott.
    Ez valodi hiba.
    CONFIG_ERROR eseten (es ha a Li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
2026-08-26 Retry the saved network instead of dropping straight into AP mode
    Eddig ha a mentett halozathoz nem sikerult csatlakozni, az eszkoz 20 masodperc
    utan AP beallito modba lepett - es ott is maradt. Teszttel igazolva: 30 perc
    alatt egyetlen ujabb WiFi.begin() sem tortent.
    Ez pont a legfontosabb esetben hibas. Aramszunet utan az ESP masodpercek alatt
    elindul, a router viszont percekig bootol; az eszkoz igy emberi beavatkozasig
    hasznalhatatlan maradt volna, holott epp ilyenkor kellene dolgoznia.
    Mostantol harom eset kulonul el:
    - nincs mentett SSID -> azonnal AP portal (mas nem is segitene)
    - van SSID, de nem erheto el -> NEM megy AP modba: firstStartDelay varakozas,
    reconnectWifi, majd 1 oras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
2026-08-26 Unify the Wi-Fi retry policy across every path
    Minden agon ugyanaz: 3 proba, koztuk 30 masodperc szunet.
    - reconnectWifi() mar nem dont az alvasrol, csak visszater; a folytatasrol a
    hivo dont, es mindenhol AP beallito mod a vegallomas.
    - Induláskor mentett SSID-vel: 10 perc firstStartDelay varakozas, majd 3 proba,
    es csak utana AP mod. Az RTC-alapu korszamlalo (MAX_CONNECT_ROUNDS) es a
    hozza tartozo 1 oras alvas megszunt - ezt valtja fel ez az egyszerubb,
    minden agon azonos szabaly.
    - Mukodes kozbeni kapcsolatvesztesnel azonnal 3 proba fut, es sikertelenseg
    eseten rogton router ujrainditas kovetkezik, nem varunk tovabbi teszt
    ciklusokat.
    - Router reset utan szinten 3 proba; ha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
    [bazsi_router_reboot.ino, test_main.cpp]
2026-08-26 Stop after repeated watchdog resets
    Ha a program ismetelten megakad, az ujrainditgatas onmagaban nem megoldas.
    3 watchdog/panic miatti ujraindulas utan az eszkoz ugyanugy leall, mint a tobbi
    vegzetes hibanal: mindket LED villog, 5 perc utan deep sleep, csak gombbal
    ebreszthető.
    A szamlalo RTC_NOINIT_ATTR-ben van, NEM RTC_DATA_ATTR-ben. Az esp_attr.h szerint
    az utobbi csak a deep sleepet eli tul, egy watchdog reset ujrainicializalna -
    epp azt veszitenenk el, amit szamolni akarunk. A NOINIT terulet viszont
    bekapcsolaskor hatarozatlan, ezert magic ertekkel ellenorizzuk.
    Rendellenesnek szamit: ESP_RST_TASK_WDT, ESP_RST_INT_WDT, ESP_RST_WDT,
    ESP_RST_PANIC, ESP_RST_CPU_LOCKUP. Ellenorizve az ID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
    [bazsi_router_reboot.ino, esp_attr.h, esp_system.h, main_stub.cpp, test_main.cpp]
2026-08-26 Add MUKODES.md: complete behaviour and timing reference
    Az eszkoz teljes mukodese egy helyen: uzemmodok, indulas, internet figyeles,
    router reset, wifi kapcsolatvesztes, AP mod, vegzetes hiba, watchdog, gombok,
    alvasok es LED jelzesek. Minden ertek a sketch konstansaibol szarmazik.
    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
2026-08-26 Fix silently accepted invalid form input; cover the save path with tests
    Bugkereso kor a 3.3.11-es core forrasai ellen ellenorizve.
    Javitott hiba: a beallito oldal POST kezeloje a validacios hibakat csak
    naplozta, a saveOk valtozot nem allitotta hamisra. Tul hosszu SSID, tul hosszu
    jelszo, rossz IP vagy gateway formatum eseten az eszkoz "Done"-t valaszolt es
    ujraindult, majd - mivel semmit nem mentett - ismet AP modban jott fel. Ez
    ugyanaz a zsakutca, amit korabban az irasi hibaknal javitottunk, csak masik
    uton. Hianyzo SSID-t sem utasitott el. Most mindegyik HTTP 500-at ad, megnevezi
    az okot, es nem indit ujra.
    Watchdog inicializalas sorrendje: eloszor enableLoopWDT(), utana
    esp_task_wdt_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
    [ESPAsyncWebServer.h, bazsi_router_reboot.ino, main_stub.cpp, test_main.cpp]
2026-08-26 Reduce RAM and CPU use; fix stale messages found in review
    Bugkereso/konzisztencia kor, minden a 3.3.11-es core es az IDF v5.5 forrasai
    ellen ellenorizve.
    CPU (a legnagyobb nyereseg):
    - A loop() a monitor ag varakozo allapotaiban (SUCCESS 1 perc, FAILURE 12 mp)
    eddig delay nelkul tert vissza, azaz 1. prioritason 100% CPU-val porgott.
    Most delay(BUTTON_POLL_MS) zarja a kort: a vTaskDelay tenylegesen
    felfuggeszti a taskot. Minden idozites ezredmasodpercben mer, tehat a 10 ms
    szemcsezettseg nem szamit.
    - Ugyanez a 10 perces first start varakozasban is (ott yield() volt).
    RAM:
    - A hat IPAddress globalis (~28 bajt/db a core 3.x-ben: 16 bajtos unio + tipus
    + zona + vptr) megszunt. A lo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
    [bazsi_router_reboot.ino, test_main.cpp]
2026-08-26 Add adversarial and power-outage tests; time-based Wi-Fi simulator
    Ujabb bugkereso kor. A firmware-ben ezuttal nem talaltam hibat - a 17 uj
    hataresetbol egy sem bukott el.
    Uj tesztek:
    - X1-X6 hataresetek: reset gomb a 90 mp-es rele pulzus kozben (az ujraindulas
    utan a router visszakapja az aramot), nyilt halozat ures jelszoval, SSID/
    jelszo pontos hatarertekei (32 / 63 karakter meg jo, 33 mar nem), fel-
    konfiguralt statikus IP (csak IP, gateway nelkul) -> DHCP, csak whitespace-t
    tartalmazo konfig fajl, es hogy a sikertelen mentes is kitolja az AP hataridot.
    - PO1-PO3: mekkora aramszunetet el tul felugyelet nelkul. Kimerve ~12 perc a
    hatar: 8 es 11 perces router-indulast meg kivar,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
    [Arduino.h, WiFi.h, main_stub.cpp, test_main.cpp]
2026-08-26 Retry for 2 days unless the password is wrong; add RTC diagnostic log
    Ket valtozas, mindketto a 3.3.11-es core forrasaiban ellenorizve.
    1) A csatlakozasi hiba OKA dont, nem az eltelt ido
    A core meg tudja kulonboztetni a ket esetet (libraries/WiFi/src/STA.cpp):
    WIFI_REASON_NO_AP_FOUND -> WL_NO_SSID_AVAIL (a halozat nem is latszik),
    WIFI_REASON_AUTH_FAIL -> WL_CONNECT_FAILED (rossz jelszo). A 3 sikertelen proba
    utan ezt nezzuk meg:
    - WL_CONNECT_FAILED -> azonnal AP beallito mod (tenyleg rossz a jelszo)
    - barmi mas -> 1 oras alvas, majd uj kor
    Konzervativan dontunk: CSAK az explicit hitelesitesi hiba kuld AP modba. A
    teves "varjunk tovabb" ara kesleltetett ujrakonfiguralas, a teves "AP mod"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
    [Arduino.h, ESPAsyncWebServer.h, WiFi.h, bazsi_router_reboot.ino, test_main.cpp]
2026-08-26 Pre-size log response buffer; keep the event log readable
    Bugkereso kor az uj funkciokon, minden a 3.3.11 / ESPAsyncWebServer forrasaiban
    ellenorizve.
    - A /log valasz puffere elore 4096 bajtra meretezve. Az AsyncResponseStream
    cbuf-ja resizeAdd()-del no (WebResponses.cpp), tehat nem csonkolt volna, de
    soronkent ujraallokalt; igy egyetlen foglalas lesz.
    - A TEST FAIL esemenyek kozul csak a hibasorozat elso tagja kerul naploba.
    A PROBE_DELAY 12 masodperc, tehat az ismetlodo bejegyzesek percek alatt
    kiszoritottak volna a fontos esemenyeket (BOOT ok, FATAL, AP MODE) a 32 elemu
    korpufferbol.
    - A /log oldal jelzi, hogy az uptime minden indulaskor nullarol indul, ezert a
    BOOT sorok jel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
    [bazsi_router_reboot.ino, test_main.cpp]
2026-08-26 Power-cycle the router in every retry round
    A 2 napos ujraprobalkozasi korben eddig EGYSZER SEM kapcsolt a rele - ezt teszt
    is igazolta. Ha a wifi nem lathato, a router is lehet lefagyva, es a
    helyrehozasa pontosan ennek az eszkoznek a dolga; a korabbi viselkedes ehelyett
    ket napig varakozott tetlenul.
    Mostantol az indulasi ag ugyanazt csinalja, mint a mukodes kozbeni: 3 proba ->
    router ujrainditas -> 10 perc bootolasi varakozas -> ujabb 3 proba -> alvas.
    Ujraszamolt kor:
    10,0 perc firstStartDelay
    + 2,0 perc 3 proba
    + 1,5 perc RESET_PULSE
    + 10,0 perc RESET_DELAY
    + 2,0 perc ujabb 3 proba
    + 60,0 perc alvas
    = 85,5 perc
    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
    [bazsi_router_reboot.ino, test_main.cpp]
2026-08-26 Signal a stuck button with alternating LEDs before sleeping
    A wifireset gomb ellenorzese mar korabban is megvolt (setup(), mindket labat
    nezzuk) - a MUKODES.md fogalmazott csak altalanosan, ez most pontositva lett.
    Uj: elalvas elott a ket LED 3 masodpercig FELVALTVA villog (ellentetes
    fazisban). Ez szandekosan mas, mint a vegzetes hiba jelzese, ahol a ket LED
    EGYUTT villog - igy rane­zesre megkulonboztetheto, hogy beragadt gombrol vagy
    serult konfiguraciorol van szo.
    A beragadt gomb bekerul a diagnosztikai naploba is (STUCK BUTTON esemeny, a
    parameter mondja meg melyik gomb). Ehhez a BOOT esemeny naplozasa a
    gombellenorzes ELE kerult, kulonben a beragadt gombos indulasrol nem lenne
    boot b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
    [bazsi_router_reboot.ino, test_main.cpp]
2026-08-26 Remove the last busy-wait loops; make delays tick-rate independent
    Atnezesi kor. A firmware-ben ket helyen maradt yield() alapu porgetes:
    - readBounded(): a HTTP valaszra varva akar 1,5 masodpercig porgott
    - setup(): a soros port felallasara varva akar 3 masodpercig
    Mindketto delay(BUTTON_POLL_MS)-re valtott. Szandekosan BUTTON_POLL_MS (10 ms)
    es nem delay(1): az IDF v5.5 Kconfig szerint a FREERTOS_HZ alapertelmezese 100,
    es az arduino-esp32 Kconfig.projbuild-ja nem irja felul. Az esz32-arduino-libs
    binaris sdkconfig-jat nem sikerult megszereznem, tehat a tenyleges tick nem
    igazolt - 100 Hz-en viszont a delay(1) NULLA tick lenne, azaz megint porgetes.
    A 10 ms mindket tick-raten pontosan 10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
2026-08-26 Fix premature watchdog feeding; add wake-source safety net; test both IDF branches
    Harom talalat ebben a korben.
    1) A setup() a watchdog bekapcsolasa ELOTT etetett
    Az esp_task_wdt_reset() ESP_ERR_NOT_FOUND-ot ad, ha a hivo task nincs
    feliratkozva (task_wdt.c: find_entry_from_task_handle...), es a core
    feedLoopWDT()-je erre log_e()-t hiv. A setup() blokkolo ciklusai viszont az
    initWatchdog() elott futnak: egy sikertelen indulasi csatlakozas 20 masodperce
    ~2000 hibasort jelentett volna, ha be van kapcsolva a debug log - ami a soros
    porton at onmagaban is lassitana. Mostantol egy feedWatchdog() wrapper csak
    akkor etet, ha a loop task mar feliratkozott. A WDT5 teszt meri: 0 etetes a
    feliratkoz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
    [Arduino.h, bazsi_router_reboot.ino, esp_idf_version.h, esp_task_wdt.h, main_stub.cpp, test_main.cpp]
2026-08-27 Audit serial output rate, loop bounds and counter overflow
    Serial console load, measured with a purpose-built harness (not estimated):
    monitor, minden rendben 328 sor / 30 perc = 10.9 sor/perc
    monitor, internet kiesett 196 sor / 30 perc = 6.5 sor/perc
    AP konfig mod 0 sor / 4 perc = 0.0 sor/perc
    vegzetes hiba (LED villogas) 0 sor / 4 perc = 0.0 sor/perc
    Nowhere near flooding, so no rate limiter was added -- one would only
    hide information without saving anything.
    Loop audit: all 11 while loops in the sketch were checked for a bounded
    exit. Every one terminates on a string length, a millis() deadline, or
    reset_device() returning true after RES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
    [test_main.cpp]
2026-08-27 Verify watchdog subscription; fix silent failures and doc drift
    Everything below was checked against the real arduino-esp32 3.3.11 /
    ESP-IDF v5.5 sources, not from memory.
    Watchdog: enableLoopWDT() is void (esp32-hal-misc.c) -- when
    esp_task_wdt_add() fails it only emits an internal log_e(). initWatchdog()
    assumed success, so with an uninitialised TWDT (ESP_TASK_WDT_INIT=n) the
    device printed "Watchdog enabled, timeout 90 s" while the loop task was
    never subscribed: no hang protection at all, and every feedWatchdog() hit
    ESP_ERR_NOT_FOUND, which the core turns into a log_e() line. Measured with
    the old code: 100 error lines per minute in normal operation, against
    10 lines/min of legitimate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
    [Arduino.h, WiFi.h, bazsi_router_reboot.ino, esp_task_wdt.h, esp_timer.h, main_stub.cpp, test_main.cpp]
2026-08-27 Stop the Wi-Fi LED from lying during a router reset; harden the test suite
    Ran the sketch through stricter tooling this round rather than only
    re-reading it.
    clang-tidy (bugprone/cert/clang-analyzer/misc) and g++ with -Wconversion,
    -Wsign-conversion, -Wformat=2, -Wcast-qual, -Wlogical-op,
    -Wduplicated-cond, -Wnull-dereference and friends found nothing
    substantive: the conversion warnings are all millis() returning
    unsigned long, which is 32-bit on the ESP32, and the ignored return
    values are snprintf into deliberately sized buffers.
    The whole suite now also runs under AddressSanitizer + UndefinedBehavior
    Sanitizer via a new "make san" target. All 111 scenarios pass clean --
    no buffer overr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
    [bazsi_router_reboot.ino, test_main.cpp]
2026-08-27 Cover the untested branches; clear SSID first on wifireset
    Measured line coverage this round instead of only reading the code, to
    find the branches nothing was watching. gcov over the suite reported
    94.12% of 901 lines, leaving ~53 lines that no scenario ever executed.
    Working through them found two firmware issues and one documentation
    error, and proved the rest correct.
    wifiresetbutton() cleared the four config files in the order gateway,
    ip, pass, ssid. The whole point of that button is that the device comes
    back up in the config portal, and only /ssid.txt decides that (setup()
    starts the portal when the SSID is empty). Clearing it last means a
    power loss mid-sequence can leave a half-co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
    [Arduino.h, LittleFS.h, WiFi.h, bazsi_router_reboot.ino, main_stub.cpp, test_main.cpp]
2026-08-27 Treat a failed wifireset erase as a fatal error, not a restart
    Per the device owner: if the saved Wi-Fi data cannot be erased, the
    device must not keep running.
    That is the right call, and it makes the four failure causes one class.
    If LittleFS cannot be written, saving a new configuration would fail the
    same way, so restarting only brings the device back on the old network
    with the button appearing to do nothing -- and on a headless device
    nobody sees the serial warning. The previous commit only logged it.
    The signalling could not simply set MODE_FATAL. The button handlers run
    from deep inside blocking loops -- waitWithButtons(RESET_DELAY) does not
    return to loop() for ten minutes -- so t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
    [bazsi_router_reboot.ino, test_main.cpp]
2026-08-27 Model missing files faithfully in the web server stub
    Walking through the "flashed but forgot to upload data/" scenario showed
    the stub answered 200 with a placeholder body for every
    request->send(LittleFS, path, type), whether or not the file existed. So
    no test could tell a served file from a missing one.
    The real library never answers 200 for a missing file. Which error it
    gives depends on the ESPAsyncWebServer version: where
    beginResponse(FS&,...) checks exists() it returns NULL and
    AsyncWebServerRequest::_send() sends 501 ("Handler did not handle the
    request"); where it does not, AsyncFileResponse's constructor falls
    through to the .gz lookup and sets _code = 404. Neither hangs the
    req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
    [ESPAsyncWebServer.h, test_main.cpp]
2026-08-27 Keep the config portal awake while its page is open
    Walking the "first boot, forgot to upload data/" scenario on the real
    sketch turned up a usable-but-sharp edge. The AP mode sleeps after five
    minutes of idleness, but "idleness" was measured from the last HTTP
    request -- and typing into the form generates no requests. Measured: with
    the page loaded and six minutes of slow typing, the device deep-sleeps
    mid-typing, Submit never reaches it, the AP disappears from the phone's
    Wi-Fi list, the browser gives no reason, and recovery needs a physical
    press of the reset button. Realistic trigger: switching to a password
    manager or walking to read the password off the router.
    Both forms and the log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
2026-08-27 Set the AP password to 12345678; guard its length at compile time
    Requested change to the config portal's access point password.
    While making it, looked up what the core does with a bad length:
    APClass::create() rejects a passphrase shorter than 8 characters with
    "passphrase too short!" and returns false. startConfigPortal() ignores
    WiFi.softAP()'s return value, so a too-short password would mean the AP
    never comes up at all -- the device would be unreachable, and five
    minutes later it would deep-sleep with button-only wakeup. Two
    static_asserts on sizeof(AP_PASSWORD) now catch 8..63 at compile time;
    verified they fire by building with a 7- and a 64-character password.
    KA5 covers the runtim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
    [WiFi.h, bazsi_router_reboot.ino, test_main.cpp]
2026-08-27 Obfuscate the stored Wi-Fi password, bound to the chip's eFuse MAC
    Scoped deliberately: make `strings` on a flash dump useless and stop a
    copied /pass.txt from working on another board. Not a defence against
    an attacker who can run code on the device -- that is stated plainly in
    the README rather than left implied.
    /pass.txt now holds "v1:" plus lowercase hex of the password XORed with
    an xorshift32 keystream. The seed mixes a constant with ESP.getEfuseMac()
    (esp_efuse_mac_get_default(), Esp.cpp -- checked it reads eFuse directly
    and needs no initialisation, so it is safe this early in setup()). The
    eFuse is not part of a flash dump, so the dump alone does not decode, and
    a generic decoder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
2026-08-27 Verify the plaintext password actually reaches the radio
    Answering "does decoding and then connecting really work" turned up a
    hole in the harness rather than in the firmware: the WiFi stub's begin()
    discarded its password argument, so nothing had ever checked that
    WiFi.begin() gets the decoded plaintext instead of the "v1:..." form
    stored in the file. The stub now records both arguments.
    SE8 checks the boot path, SE9 the reconnect after a dropped link, and
    SE10 the reconnect after a router reset -- that last one matters because
    WiFi.disconnect(true) destroys the netif, so initWiFi() runs from
    scratch. All three see the plaintext.
    Second harness fix, found while writing those: coldBoot() d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
    [WiFi.h, test_main.cpp]
2026-08-27 Detect a mistyped static IP instead of power-cycling the router forever
    Walking the "I mistyped an IP in the portal" scenario found the sharp
    edge. Malformed input is already rejected cleanly -- 500 with a specific
    reason, no restart, AP still up so you can retry. But a typo that is
    still a valid address (192.168.0.200 for 192.168.1.200) passes every
    check. Measured what followed: WPA2 association succeeds, so the device
    reports connected with the Wi-Fi LED on, while nothing is reachable at
    IP level. It then power-cycles the router at 2.4, 14.8, 27.2 and 39.6
    minutes, sleeps an hour at 50.4, and repeats that cycle indefinitely.
    There is a clean signal for this. Under a static configuration,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
2026-08-27 Never sleep or restart while a config write is in flight
    Requirement: neither a sleep nor a restart may interrupt a file write --
    the write completes first in both cases.
    Auditing every path found one real gap. The buttons were already guarded
    and the AP timeout was already gated on savingConfig, but the deferred
    restart in loop() was not. After a successful save the device waits a
    two-second grace so the response reaches the browser; a second submit
    inside that window -- a double tap on a phone is routine -- sets
    savingConfig and starts writing four files, and the restart then fires
    mid-write.
    Added waitForConfigWrite() and put it at the two choke points:
    enterDeepSleep(), which every sle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
2026-08-28 Make the harness model the 32-bit millis() wrap faithfully
    Asked what happens when the device has been up 169 days -- 3.4 millis()
    wraps -- and the SSID disappears. Measuring it exposed a flaw in the test
    harness, not in the firmware.
    The stub declared `unsigned long millis()`, matching the Arduino
    signature. On the ESP32-C3 `unsigned long` is 32 bits, so `millis() -
    start` wraps and the wrap-safe idioms work. On an x86-64 host it is 64
    bits, so the subtraction never wraps and those idioms behave differently
    from the target. Every wrap-related conclusion drawn from this harness
    was therefore untrustworthy -- and it showed: measuring the relay pulse
    across a wrap reported 60 seconds instead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
2026-08-28 Measure the watchdog feed gap; make ping and HTTP block in the harness
    Asked whether the watchdog holds under all circumstances. Measuring it
    first required fixing the harness: the ping and HTTPClient stubs returned
    instantly, so the two longest unfed stretches in the firmware -- exactly
    what the 90 second timeout was sized for -- did not exist in simulation.
    No test could ever have caught a watchdog timeout caused by a slow
    network call. Ping now costs its timeout (1 s failing, 50 ms succeeding)
    and http.GET() costs 15 s when it fails (5 s connect + 10 s response),
    both without feeding, as on hardware.
    With that, the longest stretch without a feed, per mode, modelling the
    real loopTask whi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
    [ESPping.h, HTTPClient.h, main_stub.cpp, test_main.cpp]
2026-08-28 Arm the watchdog before Wi-Fi init, not at the end of setup()
    initWatchdog() ran as the last statement of setup(), so everything before
    it was unprotected -- including WiFi.mode() and WiFi.begin(), the most
    likely place for a driver to block forever. On a device meant to run
    unattended for months, a hang there would have stopped it permanently
    with no recovery.
    Moved to just after the LittleFS mount and config load, before
    WiFi.persistent(). The LittleFS step is deliberately left outside the
    watchdog's reach: LittleFS.begin(true) formats the partition on a first
    boot, and erasing ~1.5 MB at 30-50 ms per 4 KB sector is 15-20 seconds
    with no feeding. A first power-up must never be able to run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
2026-08-28 Document the watchdog config actually compiled into the Arduino libs
    The watchdog section stated the ESP-IDF Kconfig defaults, not the values
    the prebuilt esp32-arduino-libs are compiled with. Two of them differ.
    Verified against espressif/esp32-arduino-lib-builder (the repo the
    prebuilt libraries are built from):
    - configs/defconfig.common:21 sets CONFIG_ESP_TASK_WDT_PANIC=y, while
    the IDF default is n. The README claimed n.
    - configs/defconfig.common:17 sets CONFIG_ESP_INT_WDT_TIMEOUT_MS=300 and
    nothing in the tree disables CONFIG_ESP_INT_WDT, so the interrupt
    watchdog is on at 300 ms in this build - previously this was only
    inferred from the IDF default.
    - configs/defconfig.esp3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
2026-08-28 Replace msftncsi with two independent connectivity endpoints
    Cycle indices 2 and 4 both probed http://www.msftncsi.com/ncsi.txt, so of the
    five escalation tests three depended on Microsoft. A single operator's outage
    therefore drove most of the router-reset decision.
    Endpoint table is now five distinct targets over four operators:
    0 HTTP msftconnecttest.com/connecttest.txt -> "Microsoft Connect Test"
    1 ping 1.1.1.1 (Cloudflare)
    2 HTTP detectportal.firefox.com/success.txt -> "success"
    3 ping 8.8.8.8 (Google)
    4 HTTP connectivitycheck.gstatic.com/generate_204 -> 204 No Content
    Both replacements are endpoints t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
    [ESPping.h, HTTPClient.h, bazsi_router_reboot.ino, main_stub.cpp, test_main.cpp]
2026-08-28 Drop ICMP from the internet test; all five probes are now HTTP
    The two ping probes could declare "internet OK" on their own, and that made
    the device blind to the most common real failure: a cheap router whose DNS
    forwarder wedges. ICMP to 1.1.1.1 keeps working perfectly while nothing in the
    house resolves a name. Measured on the simulator against the previous
    firmware: one hour of frozen router DNS produced 41 failed HTTP tests and
    0 router resets, because index 1 always succeeded and zeroed the counters.
    ICMP proves neither name resolution nor TCP, which is why no major
    implementation validates with it - NetworkManager uses libcurl HTTP, Firefox
    probes detectportal, Windows NCSI does DNS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
    [bazsi_router_reboot.ino, test_main.cpp]
2026-08-28 Size the watchdog against a dead DNS, not a silent server
    Bug hunt on the new all-HTTP internet test. One real finding, in the
    watchdog's sizing rationale rather than in the test logic itself.
    WDT_TIMEOUT_MS was justified as "http.GET() blocks at most 5 s connect +
    10 s response = 15 s, so 90 s is a sixfold margin". That reasoning misses
    name resolution, which is now in the path of all five probes and is exactly
    what fails in the scenario the new design targets:
    - NetworkClient::connect(host, port, timeout) resolves the name FIRST, via
    Network.hostByName(), which takes no timeout at all
    (NetworkClient.cpp:310-315). setConnectTimeout() does not bound it.
    - An lwIP query gives up after ~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
    [bazsi_router_reboot.ino, test_main.cpp]
2026-08-28 Correct the timing figures MUKODES.md still quotes from the ping era
    The previous commit established that a failed probe costs up to 33 s, not
    15 s, because name resolution runs before connect() and no HTTPClient
    timeout bounds it. README.md and the sketch were corrected; MUKODES.md was
    not, so the user-facing document still promised the old numbers:
    - "TESTING_STATE: 1-15 mp" -> 1-33 mp.
    - The endpoint table's "Max. időtartam" column said ~15 mp for all five
    probes. Now 15 / 33 mp, with the two failure modes spelled out and a
    pointer to the derivation in README and to WD13.
    - Detection time was given as a flat "Mérve 123 mp", worst case 183 mp.
    That holds only when DNS answers and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
2026-08-28 Decode chunked responses; the raw stream still carries the frame bytes
    Real bug in the HTTP internet test. A working endpoint that answers with
    Transfer-Encoding: chunked was scored as a failed probe.
    testInternetHTTP() reads the WiFiClient it handed to http.begin() directly,
    into a fixed 96-byte buffer, deliberately avoiding getString() and
    writeToStream() because both allocate or write without a bound - the whole
    point on a captive portal's several-hundred-kilobyte reply. But those two
    are also the only paths where HTTPClient strips the chunk framing
    (HTTPClient.cpp, _transferEncoding == HTTPC_TE_CHUNKED). Reading the raw
    stream gets the frame bytes as well:
    7\r\nsuccess\r\n0\r\n\r\n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
    [Arduino.h, HTTPClient.h, bazsi_router_reboot.ino, main_stub.cpp, test_main.cpp]
2026-08-28 Make the reset condition state the guarantee it actually enforces
    The reset fired on `cycleIndex > 3 && failedCount >= 3`. The second half
    never decided anything: both counters advance by one per failed probe and
    both reset together, so `failedCount == cycleIndex + 1` holds at every
    evaluation. The index condition is therefore equivalent to failedCount >= 5,
    which is strictly stronger than >= 3 - and the constant named 3, so the code
    claimed a threshold that was never the real one. README needed a footnote to
    explain the discrepancy away.
    The two halves also do not protect the same thing. Endpoint coverage is the
    safety property: never power-cycle a working router because one provider is
    do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
    [bazsi_router_reboot.ino]
2026-08-28 Rename the HEX array; it collided with the core's #define HEX 16
    Compile error on the real toolchain (ESP32 Arduino 3.3.11):
    Print.h:31:13: error: expected unqualified-id before numeric constant
    31 | #define HEX 16
    bazsi_router_reboot.ino:429:21: note: in expansion of macro 'HEX'
    429 | static const char HEX[] = "0123456789abcdef";
    Print.h is pulled in by Arduino.h, so `#define HEX 16` applies to every
    sketch, and the local table in encodeSecret() expanded to
    `static const char 16[]`. Renamed to kHexDigits, with a comment saying why
    the name is off limits.
    The host harness compiled it fine, which is the more interesting half of
    this bug: the stub Arduino.h did not define the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
    [Arduino.h, bazsi_router_reboot.ino]
2026-08-28 Mirror the core's macros and pin constants in the stub Arduino.h
    Follow-up to the HEX collision: audited which other core names could bite
    the same way, against the real 3.3.11 headers rather than from memory.
    Pulled Arduino.h, Print.h, binary.h, esp32-hal*.h, io_pin_remap.h,
    WString.h, Stream.h, WCharacter.h, HardwareSerial.h and the XIAO_ESP32C3
    pins_arduino.h, extracted every #define, and intersected the 364 names with
    every identifier in the sketch.
    Result: 14 matches, all of them deliberate uses (HIGH, LOW, OUTPUT,
    INPUT_PULLUP, D0-D5, Serial, pinMode, digitalRead, digitalWrite, F). No
    accidental collision is left in the sketch - HEX was the only one.
    What the audit did turn up in the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
    [Arduino.h]
2026-08-28 Model the core's first_connect rule; the wrong-password test was faking it
    Audit of the comments' source citations turned up a real dependency the code
    relies on without saying so.
    wifiGiveUp() sends the device to AP mode only on WL_CONNECT_FAILED. In the
    core that status comes from STA.cpp:148, whose condition is
    } else if ((reason == WIFI_REASON_AUTH_FAIL) && !first_connect) {
    and first_connect (STA.cpp:117) is a function-level static that starts true,
    flips to false after the first disconnect event, and is never set back. So
    the FIRST failed association reports WL_DISCONNECTED even for a bad
    passphrase - a single attempt cannot tell a wrong password from a missing
    router.
    The code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
    [WiFi.h, bazsi_router_reboot.ino, test_main.cpp]
2026-08-28 Pin the documented timings with measurements instead of arithmetic
    The docs promise three concrete numbers a reader would act on: a retry round
    is 25,5 minutes awake (85,5 with the hour of sleep, so 33 rounds = 47 hours),
    and the internet outage is noticed in 123 s with live DNS or 213 s with a
    dead one. All three were derived on paper and nothing checked them, so the
    first timing change would have made the README quietly wrong.
    Checked the derivations against the constants first - firstStartDelay 10 min,
    3 attempts at 20 s with 30 s gaps, RESET_PULSE 90 s, RESET_DELAY 10 min,
    another 3 attempts, SLEEP_DURATION_US 1 h - and they add up. Then measured
    them:
    - R6 runs a full round with the n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
    [test_main.cpp]
2026-08-28 Comment pass: drop rename archaeology, fix two claims that had gone stale
    Went through every comment in the sketch, checked what it asserts, and cut
    what no longer earns its line.
    Two claims were actually wrong:
    - isUsableIPv4()'s comment justified rejecting IPv6 by listing what the
    device does over IPv4, including "ping 1.1.1.1 and 8.8.8.8". Those probes
    were removed when the internet test went all-HTTP; 1.1.1.1 survives only
    as the fallback DNS. Now lists what the device actually does.
    - The watchdog's failure path said a default 5 s timeout "would restart
    during the 15 s HTTP test". The established worst case is 33 s, so the
    sentence understated its own point. Now 15-33 s, poi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
    [bazsi_router_reboot.ino]
2026-08-28 Line-by-line review: the patience window is 46 hours, not 47
    Read the sketch top to bottom against the actual sources. Three real findings,
    one of them a documented number that was simply wrong.
    **The two-day patience is 46,0 hours, not 47,0.** wifiGiveUp() increments
    rtcRetryRounds and *then* tests it against MAX_RETRY_ROUNDS, so the 33rd round
    goes straight to AP mode instead of sleeping. The documented total counted 33
    sleeps: 33 x 85,5 = 2821,5 min. There are only 32: 33 x 25,5 + 32 x 60 =
    2761,5 min = 46,0 h. The derivation of why 33 was wrong too - under the correct
    formula 34 rounds would still fit in two days (47,5 h), so 33 is a
    conservative choice, not the maximum. Corrected in th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
    [bazsi_router_reboot.ino, test_main.cpp]
2026-08-29 Code review javítások: relé hold alváskor, napló-race, IP trim, strapping figyelmeztetés
    A code review során talált hibák és inkonzisztenciák javítása:
    - Relé láb (GPIO7) rögzítése deep sleep idejére (gpio_hold_en +
    gpio_deep_sleep_hold_en): az alvás alatt a láb többé nem lebeg, a hold
    feloldása ébredéskor a meghajtott LOW beállítása UTÁN történik. A külső
    lehúzó ellenállás ajánlás marad (a bekapcsolási ablakot csak az fedi).
    A korábbi komment/README állítás ("szoftverből nem tartható") a
    driver/gpio.h szerint pontatlan volt.
    - logEvent(): kritikus szakasz védi a körpuffer léptetését - a loop task és
    az async_tcp task (CONFIG_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
2026-08-29 Friss szemes bugvadászat: watchdog-csapda, kétfázisú mentés, író-zár
    Öt új találat javítása:
    - initWatchdog(): ha a feliratkozás sikerül, de a 90 s-os konfigurálás nem,
    a loop task az IDF alapértelmezett (tipikusan 5 mp-es) timeoutjával maradt
    volna figyelve - a http.GET() akár 33 mp-es, etetés nélküli blokkolása
    alatt MINDEN internetteszt watchdog-panicba és újraindítási hurokba futott
    volna, három kör után végzetes hibáig. Ilyenkor most leiratkozunk
    (disableLoopWDT): védelem nincs, de a program fut.
    - Beállító portál: a mentés két fázisú lett. Korábban a mezők validálás
    közben, menet közben íródtak - egy rossz gateway a már ki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
    [Arduino.h, bazsi_router_reboot.ino, main_stub.cpp, test_main.cpp]
2026-08-29 Harmadik bugkereső kör: IP/gateway csonkolás elleni védelem
    A POST-olt IP/gateway mező nyers hosszát is ellenőrizzük, ahogy az SSID és a
    jelszó ágban eddig is történt: a vágó puffernél (31 karakter) hosszabb érték
    végét a strlcpy() csendben levágta, és a maradék akár érvényes címként is
    validálódhatott - pl. "192.168.1.200" + szóközök + szemét a 31. karakter után
    elfogadott 192.168.1.200-zá csonkolódott. Az űrlap maxlength=15-je ezt
    böngészőből nem engedi, kézzel gyártott POST-ból jöhetett. A túlméretes érték
    mostantól hiba (500), nem csendben megtisztított bemenet. Regresszió: P17.
    A kör többi vizsgált területe (a korábbi két kör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
    [bazsi_router_reboot.ino, test_main.cpp]
2026-08-31 A data/ weboldal kivétele és egyedi partíciós tábla OTA nélkül
    A beállító weboldalt eddig két helyen tartottuk: a data/ mappában
    (LittleFS-re feltöltendő wifimanager.html + style.css + favicon.png) és
    beépített tartalék űrlapként a sketchben. A kettő ugyanazt a négy mezőt
    kérte, viszont a data/ ág feltöltési lépést és külön karbantartást
    igényelt, és egy elfelejtett feltöltés után a portál a tartalékra esett
    vissza.
    - data/ törölve; a FALLBACK_FORM immár CONFIG_FORM, és a "nincs feltöltve
    a data/" figyelmeztető sor kikerült belőle
    - a GET / mindig a beépített űrlapot adja, a /style.css és /favicon.png
    útvonalak megszűntek: a portál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
    [partitions_custom.csv]
2026-08-31 A relé vezérlése D5-ről (GPIO7) D10-re (GPIO10) kerül
    A korábbi D5 = GPIO7 bekötés a hardveren nem volt stabil. Az új láb
    D10 = GPIO10, külső 22 kOhm lehúzó ellenállással a GND felé.
    Amiért a D10 jó választás:
    - nem strapping láb (a C3-on GPIO2, GPIO8, GPIO9 az), tehát a reset alatti
    szintje a bootot nem befolyásolja
    - továbbra is a digitális pad tartományban (GPIO6-21) van, így az alvás
    alatti rögzítéshez ugyanaz a gpio_hold_en() + gpio_deep_sleep_hold_en()
    páros érvényes, mint eddig - a holdRelayForSleep() változatlanul jó
    A 22 kOhm lehúzó továbbra sem elhagyható: a hold a bekapcsolás és a
    program indulása közti ablakban még nem él.
    A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
    [bazsi_router_reboot.ino]
2026-08-31 A hibaszámláló a teszt UTÁN kerül a soros kimenetre
    A "Hibák száma" eddig a teszt ELŐTT, a "Teszt ciklus index" mellett
    került ki. Így a sorozat első tesztjénél mindig 0-t írt, és végig eggyel
    le volt maradva a valós állapothoz képest: a számláló ugyanis a teszt
    eredménye, nem a bemenete.
    - a teszt előtti sor már csak az indexet írja ki (az azt mondja meg,
    melyik végpont jön, tehát ott van a helye)
    - a hibaszámláló a "Test failed." sorra került, a növelés után:
    "Test failed. | Hibák száma = 1 / 5"
    - a nevező (MAX_CYCLE_INDEX + 1 = 5) az a darabszám, ami után a router
    újraindítása következik - a szám így önmagában is értelmezhető
    A sz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
    [bazsi_router_reboot.ino]
2026-08-31 1-alapú teszt sorszám, és csendes siker a soros porton
    Két kérés a soros kimenetre:
    1. A "Teszt ciklus index" 1-tol szamol (1..5). Emberi olvasonak nincs
    "0-dik teszt". A belso cycleIndex MARAD 0-alapu: ahhoz kotodik a
    vegpontvalaszto if-lanc es a RESET_TRIGGER_CYCLE kuszob is, azt
    atszamozni felesleges kockazat lett volna. Csak a kiiras valtozik
    (cycleIndex + 1).
    Ugyanezt kapja a /log oldal TEST FAIL bejegyzesenek parametere is,
    kulonben a ket helyen mas szam allna ugyanarrol a tesztrol.
    2. Sikeres teszt csak a "Successful Test" sort adja. A testInternetHTTP()
    sikernel mar nem irja ki sem az "Igaz érték!" / "204 No Content"
    nyugtazast, sem a kapott torzset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
    [bazsi_router_reboot.ino]
2026-08-31 A watchdog a setup() elejen elesedik, nem a LittleFS csatolasa utan
    A rovidebb formazas ezt most mar megengedi. Az initWatchdog() a soros
    port beallasa utan azonnal fut, meg a gombellenorzes es a LittleFS
    csatolasa elott - igy a setup() gyakorlatilag teljes egeszeben a
    watchdog alatt van.
    Miert fer bele a formazas:
    - a partitions_custom.csv 512 KiB-os "spiffs" particioja 128 szektor,
    tipikusan 30-50 ms/szektor -> 4-7 mp, es meg a szelsosegesen lassu,
    400 ms/szektoros esetben is ~51 mp
    - mindketto a 90 mp-es WDT_TIMEOUT_MS alatt marad
    - a regi ~1,5 MB-os semanal ugyanez rossz esetben ~153 mp lett volna,
    azaz a timeout FOLOTT - ezert volt ott indokolt a kihagyas. A kisebb
    particio tet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
2026-08-31 Korai kilepes a hosszu varakozasokbol + AP/reset LED-jelzes
    1) A firstStartDelay es a RESET_DELAY korai lezarasa
    Mindket varakozas a router bootolasara hagy idot. Ha a router hamarabb
    feláll, most mar nem varjuk ki a maradekot: 60 mp-enkent lefut egy
    ketlepcsos proba (onlineProbe) - eloszor Wi-Fi kapcsolat, utana ping a
    1.1.1.1-re -, es ha MINDKETTO sikerul, a varakozas azonnal veget er. Ha
    barmelyik bukik, a varakozas szabalyosan vegigfut.
    Harom helyen: handleFirstStart(), a FAILURE_STATE RESET_DELAY aga, es a
    routerResetAndRetry() varakozasa (uj waitWithButtonsUntilOnline()).
    A RESET_DELAY korai agan a WiFi.disconnect(true) + reconnectWifi() kor
    kimarad: a kapcsolatot epp az imenti pro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
    [bazsi_router_reboot.ino]
2026-08-31 Bugvadaszat: tesztek frissitese az uj mukodesre, inkonzisztenciak
    A tesztek most az uj viselkedest merik, es a felderitett elteresek is
    javitva. 195 forgatokonyv / 636 ellenorzes, IDF 5 es IDF 6 agon is zold,
    ASan+UBSan tiszta, sorlefedettseg 98,48%.
    TALALT HIBAK
    1. A teszt-suite BERAGADT (nem csak bukott). A rele GPIO7-rol GPIO10-re
    kerult, a varakozo ciklusok viszont a "pin7=HIGH" naplosorra vartak -
    ami sosem jott meg -, es a g_log linearis keresese emiatt negyzetes
    lett. A pinek most NEVESITVE vannak (PIN_RELAY, PIN_LED, PIN_WIFILED,
    RELAY_HIGH/RELAY_LOW): egy hardveres atkotes egyetlen sor.
    2. A regi LED1 teszt CSENDBEN tovabb ment volna. Azt allitotta, hogy a
    reset pu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
    [bazsi_router_reboot.ino, test_main.cpp]
2026-08-31 Pontositas: a reset feltetele, es a proba elso lepese kiserlet, nem teszt
    Ket felhasznaloi eszrevetel, mindketto helyes volt.
    1. A README "3+ sikertelen teszt ES cycleIndex > 3"-at irt a router reset
    feltetelekent. A kodban NINCS ilyen darabszam-kuszob: egyedul a
    cycleIndex > 3 dont, ami pontosan 5 egymas utani bukast jelent (mind
    az ot vegpont). A "3+" felrevezeto volt - mar hardom bukas utan
    resetet sugallt. Javitva az ASCII abran es a "Router reset folyamat"
    listaban is, kiegeszitve azzal, hogy barmelyik sikeres teszt nullazza
    a folyamatot, es hogy a "WiFi nem jott vissza" ag kivetel (ott a
    firmware azonnal cycleIndex = 4-re ugrik).
    2. Az onlineProbe() elso lepese N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
    [bazsi_router_reboot.ino]
2026-09-01 Dokumentacio es folyamatabrak osszevetese a koddal
    Vegigmentem a harom dokumentumon csomopontonkent, es a kod ellen
    ellenoriztem minden szamot, sorrendet es allitast. A szarmaztatott
    ertekek (123/213 mp felismeresi ido, 25,5 es 85,5 perc/kor, 46,0 ora,
    4 tenyleges reset, 5 vegpont, 1/2/5 Hz villogas) mind egyeznek.
    JAVITOTT ELTERESEK
    1. MUKODES indulasi tablazat: a "Watchdog bekapcsolasa" meg a LEGUTOLSO
    sor volt, a Wi-Fi csatlakozas utan - vagyis a regi sorrend. A watchdog
    a soros port utan, minden mas ELOTT elesedik. A tablazat ehhez
    igazitva, plusz egy megjegyzes arrol, hogy az enterFatal() NEM allitja
    meg a setup()-ot.
    2. MUKODES 5. szakasz: egy korabbi szerkesztesem a LED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
2026-09-01 Pontositas: a proba ISMETLODIK, nem csak induláskor merunk egyszer
    Egy felhasznaloi eszrevetel nyoman: azt allitottam, hogy "ha a Wi-Fi el
    de az internet nem, a 10 perc vegigfut". Ez FELREVEZETO volt, es a
    kodkommentben meg a README-ben is ez a pontatlan megfogalmazas
    szerepelt.
    A valosag: a proba 60 mp-enkent ISMETLODIK, tehat eleg, ha a kapcsolat a
    varakozas BARMELY pontjan helyreall - a kilepes az azt koveto utemben
    megtortenik. A teljes 10 perc CSAK akkor telik le, ha vegig nincs meg a
    halozat vagy az internet.
    Meres (uj OP7 teszt): a Wi-Fi vegig el, az internet 3,5 percnel jon
    vissza -> a firstStart 242 masodpercnel zarul le, nem 600-nal. Vagyis az
    internet visszaterese utan 32 masod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
2026-09-01 Gomb-pollozas atvizsgalasa a hosszu varakozasok alatt (merve)
    Vegigauditaltam MINDEN blokkolo ciklust: pollozza-e a ket gombot.
    EREDMENY: a sajat varakozo ciklusaink hibatlanok. Merve (uj BTN1 teszt,
    uj g_btnMaxGap muszer a stubban): egy teljes first start varakozas +
    router reset + RESET_DELAY vegigjatszasa alatt a leghosszabb ablak,
    amiben egyik gombot sem neztuk, 10 MS. Ez beleerti az uj
    waitWithButtonsUntilOnline()-t is.
    Az auditalt ciklusok es a szandekos kivetelek:
    - waitWithButtons, waitWithButtonsUntilOnline, initWiFi 20 mp-es
    varakozasa, mindket reset_device() ciklus, readByteBounded: mindketto
    - fatalHalt(): SZANDEKOSAN csak a reset gomb (a wifireset onmagaba
    vezeto rekurzio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
    [Arduino.h, main_stub.cpp, test_main.cpp]
2026-09-01 LED- es watchdog-audit: egy valodi hiba javitva, a tobbi merve
    === LED-EK ===
    Vegigvettem mind a 24 LED-irast allapotonkent. A villogasok helyesek es
    egyik sem blokkol semmit: a loop() MODE_FATAL es MODE_CONFIG aga
    nem-blokkolo, a reset_device() hivasonkent ter vissza, a ket blokkolo
    villogas (handleStuckButton 3 mp, fatalHalt 5 perc) szandekos, es a
    fatalHalt kozben eteti a watchdogot es nezi a reset gombot.
    Uj tesztek (LED4-LED6), mind mert ertekkel:
    - a statusz LED normal monitor uzemben egyetlen korben sem alszik el
    - AP modban a mentes utani 2 mp-es turelmi ido alatt is villog, es a
    statusz LED kozben vegig vilagit
    EGY MERT KORLAT (nem hiba, dokumentalva): a Wi-Fi LED legfeljebb eg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
    [LittleFS.h, bazsi_router_reboot.ino, main_stub.cpp, test_main.cpp]
2026-09-01 Internet teszt es router reset audit - a reset-utem lemerve
    Nem talaltam uj hibat; a legfontosabb kerdest ("felesleges ujrainditas
    lehet-e") viszont MERESSEL valaszoltam meg, nem ervelessel.
    === A ROUTER UJRAINDITASANAK UTEME (uj RR1-RR3) ===
    | Helyzet | Ket reset kozt | Resetek |
    | befagyott router-DNS (ping megy) | 4 p 34 mp | 4 |
    | teljes internetkieses (ping sem) | 13 p 38 mp | 4 |
    A kulonbseg szandekos es a helyes iranyba mutat: a korai kilepes CSAK
    akkor rovidit, ha az onlineProbe() pingje SIKERUL - vagyis az IP-szintu
    ut el, es megsem megy a HTTP. Ez a beragadt router esete, ahol a
    gyorsabb ujrainditas indokolt. Ha az internet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
    [test_main.cpp]
2026-09-01 Megszakitas-alapu gombretesz + a sajat kodon talalt 3 hiba javitva
    A blokkolo http.GET() alatti 33 masodperces vak ablakban egy rovid
    gombnyomas eddig nyom nelkul elveszett (merve: BTN2). Ezt most
    megszakitas-alapu retesz hidalja at.
    A LENYEG, hogy a retesz NEM kerulhette meg a debounce-t - kulonben egy
    zajtuske ujrainditana az eszkozt. Ezert az ISR nem cselekszik, hanem
    MEGMERI a lenyomas hosszat: lefuto elen jegyzi az idot, felfuton csak
    akkor reteszel, ha a gomb legalabb BUTTON_DEBOUNCE_MS-ig lent volt. A
    debounce tehat ugyanaz maradt, csak hardveresen tortenik - es akkor is
    mukodik, amikor a loop epp nem tud mintavetelezni.
    Az ISR-ek IRAM_ATTR-esek (a flash epp foglalt lehet), es CSAK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
2026-09-01 Fajlkezeles audit: nem talaltam hibat, negy uj hibainjektalos teszt
    Vegigmentem a formazason, az irason, az olvasason es a hibakezelesen.
    PROGRAMHIBAT NEM TALALTAM - a reteg jol van megirva. Amit ellenoriztem:
    - A FILE_WRITE az ESP32 core-ban "w" (csonkol, nem hozzafuz), es a stub is
    igy modellezi - ez a klasszikus ESP8266-rol athozott hibaforras itt nem
    all fenn.
    - Minden File-t minden agon lezarunk (readConfigValue konyvtar-aga,
    fileMatches mind a negy korai kilepese, writeConfigValue).
    - Minden fajliras a konfigzar alatt tortenik: csak ket hivasi hely van (a
    POST commit es a doWifiReset), mindketto beginConfigWrite() utan.
    - Az iras visszaolvasassal ellenorzott - a File::close()/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
2026-09-01 AP portal audit: egy valodi UX-hiba javitva, a naplooldal olvashatova teve
    === VALODI HIBA: a statikus IP csendben elveszett ===
    Az urlap nem volt elokitoltve (a jelszo miatt szandekosan), a mentes
    viszont az URES cimmezot TORLESKENT ertelmezi. Aki statikus IP-vel
    uzemelt es csak a jelszot akarta atirni, annak a bongeszo uresen kuldte a
    cimmezoket - es a mentes csendben DHCP-re valtott. Merve: AP1.
    Javitas: az urlap mostantol elokitoltve mutatja a mentett SSID-t, IP-t es
    gateway-t (sendConfigForm(), AsyncResponseStream-mel - ugyanaz a minta,
    mint a /log oldalnal). A JELSZOT SOHA nem toltjuk elo. Regresszio: AP4.
    A javitas maga is csapdat rejtett: az SSID tetszoleges 32 bajt lehet,
    idezoje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
2026-09-01 Naplo audit: a WIFI LOST sorozatok szurese, plusz ket uj teszt
    A napló nem fájlba megy, hanem egy 32 elemű körpufferbe az RTC
    memóriában (RTC_NOINIT_ATTR). Ezért nincs naplóírási hibaút, amit
    kezelni kellene: nincs megnyitás, nincs write() visszatérési érték, nem
    tud betelni a tár - és a napló akkor is olvasható marad, amikor épp a
    LittleFS csatolása bukott meg.
    A 22 logEvent() hívási helyet végignézve egy hiányosság maradt: az
    EV_WIFI_LOST volt az egyetlen ismétlődő írás spam-védelem nélkül (a
    TEST FAIL-t a failedCount == 1, a STUCK BUTTON-t a
    stuckCycleAlreadyLogged védi). Pislákoló kapcsolatnál ez az ág körönként
    újra lefutott.
    - új lastEven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
    [bazsi_router_reboot.ino, test_main.cpp]
2026-09-01 Alvas/ujraindulas audit: ket valodi hiba javitva, harom uj forgatokonyv
    1. A LEALLASI ZAR NEM VOLT ATOMIKUS (SH1)
    Az alvas es az ujraindulas elott megvartuk a folyamatban levo fajlirast,
    de a varakozas ugy tert vissza, hogy a zar szabad maradt. A visszateres
    es a tenyleges esp_deep_sleep_start() / ESP.restart() kozott meg lefut
    ket-harom println es egy Serial.flush(); abban az ablakban az async_tcp
    task elindithatott egy uj mentest, amit aztan a leallas felbevagott -
    epp az, ami ellen a varakozas van. A halasztott ujraindulas sajat
    kommentje mondja ki, hogy a mobilos dupla koppintas gyakori, tehat pont
    ilyen sorozat all elo.
    Ugyanez a hiba mar szerepelt a restartFromButton()-ben, es ott a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
2026-09-01 Ido-alapfeltevesek kimondasa es a ket task kozotti megosztott allapot
    HELYESBITES. A gyanum, hogy a millis() deep sleep utan folytatodna, TEVES
    volt. Az ESP-IDF kimondja: deep sleepbol ebredve az esp_timer (es igy az
    Arduino millis()) NULLAROL indul ujra; a sleep idejevel csak a LIGHT
    sleep utan lep elore, es egyedul a gettimeofday() vinne at a deep
    sleepet. A watchdog szamlalo nullazasa tehat helyesen mukodott, es a
    harness feltevese (g_millis = 1 minden bootnal) is helyes.
    1. AZ EGYETLEN ABSZOLUT millis() OSSZEHASONLITAS
    Ettol fuggetlenul ez volt a program egyetlen abszolut millis()
    osszehasonlitasa - a masik 23 idozites mind kulonbseg-alaku. Ket
    hallgatolagos feltevest hordozott: hogy a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
2026-09-01 Heap felugyelet: meres, ritkitott naplozas es onkentes ujraindulas
    A sketch maga semmit nem allokal dinamikusan, az ESPAsyncWebServer, az
    AsyncTCP es a Wi-Fi driver viszont igen. Egy lassu szivargas vagy
    elaprozodas honapokig eszrevetlen marad, aztan egy nap az eszkoz "csak
    ugy" nem mukodik - allokacios hibanal a legtobb konyvtar CSENDBEN
    elbukik, nem panikol, tehat a watchdog sem fogja meg.
    MERES ES KIIRAS
    - mintavetel 10 mp-enkent
    - rendszeres allapotsor 30 percenkent: szabad heap, legnagyobb
    OSSZEFUGGO tomb, es a valaha volt legkisebb (ez utobbi a
    legfontosabb: a lassu szivargas ebbol latszik meg akkor is, ha a
    pillanatnyi ertek epp rendben van)
    - 0,03 sor/perc, tehat a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
2026-09-01 A naplo mentese LittleFS-re, NTP idobelyeggel
    Az RTC naplo az aramszunetet nem eli tul - epp azt a hibat nem, ami utan
    a leginkabb tudni akarnank, mi tortent elotte. A program ezert a FONTOS
    pillanatokban a fajlrendszerre is kiirja (/evlog.bin, ~400 bajt):
    - router reset elott (MEG a rele kapcsolasa elott): epp azert nyulunk
    a halozathoz, mert valami nem stimmel
    - AP modba valtas elott: az AP mod azt jelenti, hogy az eszkoz feladta,
    es epp ezt az elozmenyt akarja latni, aki megnyitja a portalt
    - az 1 oras alvas elott: hosszu ido kovetkezik
    A fajl a teljes korpuffer pillanatkepe, KIEGYENESITVE (a legregebbitol a
    legujabbig), igy az olvasonak nem kell tudnia, hol tartott a gyur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
    [Arduino.h, LittleFS.h, bazsi_router_reboot.ino, main_stub.cpp, test_main.cpp]
2026-09-01 Heap-ujraindulas: a router reset utani ellenorzo ablak kizarasa
    TALALT HIBA, a kerdesre valaszolva: NEM, nem maradt meg minden fontos
    valtozo - a gateway-ag epp az, ahol nem.
    A gateway-eszkalacio KETFAZISU, es a ket fazis kozott akar 10 perc is
    eltelhet (RESET_DELAY):
    1. a sajat gateway sem elerheto -> GW UNREACH(1), a router kap EGY
    eselyt: ujrainditas, majd varakozas
    2. a varakozas utan UJRA ellenorizzuk; ha meg mindig nincs gateway, a
    statikus IP a rossz -> AP beallito mod, hogy javitani lehessen
    Azt, hogy "az elso fazis mar lefutott", HAROM sima globalis hordozza
    egyutt: currentState, uiFlags.resetPrinted es timing.stateStart. A
    heap-ujraindulas mindharmat elvesziti - es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
    [bazsi_router_reboot.ino, test_main.cpp]
2026-09-01 Tobbfazisu letrak: a 2 napos ablak atvitele, es a naplozas utohatasai
    1. A MASIK TOBBFAZISU LETRA - A 2 NAPOS ABLAK (GWH4, GWH5)
    A kerdesre keresve megtalaltam a parjat annak, amit a gateway-agnal
    javitottunk. Ha a halozat egyaltalan nem latszik, a program 33 kort
    probal, koronkent egy oras alvassal - kb. ket napig -, aztan AP
    beallito modba megy, hogy a felhasznalo javithassa a konfiguraciot. A
    korokat az rtcRetryRounds szamolja.
    Ez a szamlalo SZANDEKOSAN RTC_DATA_ATTR, nem NOINIT: a deep sleepet
    tuleli, de bekapcsolaskor ES SZOFTVERES RESETRE nullazodik - "a
    felhasznaloi beavatkozas tiszta 2 napos ablakkal indit". Gombnyomasra ez
    helyes.
    A heap miatti ujraindulas viszont NEM felhasznalo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
    [bazsi_router_reboot.ino, test_main.cpp]
2026-09-01 Friss szemu atnezes: ket valodi hiba, egy inkonzisztencia, elavult adatok
    KET VALODI HIBA
    1. AZ ORASZINKRON HAROM UTON MEGKERULHETO VOLT (NV10)
    A startNtp() csak az initWiFi() SIKERES agarol futott - csakhogy nem
    minden kapcsolat azon keresztul jon letre. Harom ag kerulte meg:
    - az initWiFi() "mar csatlakozva vagyunk" korai visszaterese,
    - a handleFirstStart() korai kilepese, amikor a proba mar igazolta a
    kapcsolatot - EZ A LEGGYAKORIBB helyreallasi ut aramszunet utan,
    - es a FAILURE_STATE RESET_DELAY korai kilepese.
    Mindharomban elmaradt volna a szinkron, es a naplo epoch mezoje vegig 0
    maradt volna - epp a mentett naplo ertelmezese (melyik a frissebb)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
    [bazsi_router_reboot.ino, test_main.cpp]
2026-09-01 Lefedettseg-vezerelt kor: egy ures teszt, egy UB, es het uj vakfolt
    MASIK MODSZER. Az elozo kor kezzel olvasta a kodot; ez a kor a
    LEFEDETTSEG-MERESBOL indult ki: mely sorokat nem erinti egyetlen
    forgatokonyv sem? Az adat harom valodi problemat mutatott meg, amit a
    kezi olvasas nem talalt meg.
    1. AZ NV8 URESEN MENT AT
    A teszt cime szerint azt meri, hogy a naplo betoltese FELUTON bukik,
    es a /log kezelo ilyenkor ujra veszi az RTC pillanatkepet. A
    lefedettseg viszont mutatta, hogy a celzott ag SOSEM futott le.
    Az ok a modell pontatlansaga volt: a g_fsShortRead MINDEN olvasast
    megrovidit, tehat mar a FEJLEC ellenorzese elbukott, es a
    bejegyzes-betoltes aga le sem futott. A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
    [LittleFS.h, bazsi_router_reboot.ino, main_stub.cpp, test_main.cpp]
2026-09-02 Az utolso atolvasatlan reszek: duplikalt komment es egy holt mezo
    Az elozo commit utan is maradt nehany hely, amit nem neztem meg egyben:
    a printHtmlEscaped torzse, a clearConfigValue, az RTC/fajlformatum blokk,
    a setup() kozepe es a /log kezelo fejlec-resze. Ezek most megvannak.
    1. DUPLIKALT KOMMENTBEKEZDES A /log KEZELOBEN
    A "Ha epp fajliras folyik a masik taskbol..." bekezdes KETSZER
    szerepelt, ket kicsit elteroen fogalmazott valtozatban - maradek abbol,
    amikor a blokkot ujrairtam az egypufferes betoltesre. A pontosabbik
    maradt.
    2. AZ EvFileHeader::savedUptime MEZOT KIIRTUK, DE SOSEM OLVASTUK
    Holt adat volt a fajlformatumban. Kozben pontosan arra a kerdesre
    valaszol,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
2026-09-02 Doksik: uj fejezet a forraskod szerkezeterol
    MUKODES.md 16. fejezet - teljes terkep a sketchhez: a gerinc (ket uzemmod,
    harom allapot), a kilenc reteg SORSZAMOKKAL es a bennuk elo fuggvenyek
    nevesitve, plusz ket dolog, ami olvasas elott hasznos:
    - a FIZIKAI sorrend es a LOGIKAI csoportositas nem mindenhol esik egybe
    (a printHtmlEscaped/sendConfigForm a portalhoz tartozik, de a zarak
    utan all, mert a startConfigPortal() elott kell definialni; a
    gatewayUnreachable a Wi-Fi-hez, de a tesztek koze kerult, mert a
    testInternetPing()-re epul) - es hogy az elore-deklaracios blokk epp
    ezert van;
    - a negy visszatero minta, ami atszovi az egeszet (semmi dinamikus
    foglalas, e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
2026-09-02 ci: GitHub Actions workflow + lefedettsegi kapu
    A projekt legnagyobb erteke a test/ alatti keszlet (291 forgatokonyv,
    1083 ellenorzes, 98,64% sorlefedettseg), de eddig csak akkor futott le, ha
    valakinek eszebe jutott lefuttatni. Ez a workflow ezt kotelezove teszi.
    Ket fuggetlen job:
    - host-tests: "make test" (mindket IDF ag), "make san" (ASan+UBSan) es az uj
    "make covgate". Minden parancsa helyben is futtathato es itt le is futott.
    - firmware-build: a valodi ESP32 forditas arduino-cli-vel, a README "Tesztelt
    kornyezet" tablazataval EGYEZO, pinelt verziokkal (core 3.3.11, AsyncTCP
    3.5.0, ESPAsyncWebServer 3.12.0, ESPping 1.0.5 - a ket aszinkron konyvtar
    git-url-lel, hogy biztosan a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
2026-09-02 refactor: a POST es a /log kezelo kiemelese startConfigPortal()-bol
    A startConfigPortal() 539 sor volt, ebbol 288 egyetlen POST-lambda a
    server.on() argumentumaban - es epp az a felulet, amin a Wi-Fi jelszo bemegy.
    Egy 288 soros lambda egy fuggvenyhivas argumentumaban nem nezheto at.
    Uj, nevesitett egysegek:
    struct ConfigDraft - a bejovo mezok validalva, de meg NEM ervenyesitve.
    A "amig ide irunk, semmi nem valtozott" garanciat
    eddig csak komment hordozta; most a tipus is.
    parseConfigPost() - 1. fazis: beolvasas + validalas. Sem fajlt nem ir,
    sem globalist nem modosit. Az elso hiba okat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
2026-09-02 fix: a ket task kozotti osztott allapot vedelme (restartAt + restartPending)
    A MERNOKI ERTEKELES 5. GYENGESEGE. Az async_tcp task ket KULON irast vegzett:
    restartAt = millis() + RESTART_GRACE_MS;
    restartPending = true;
    a loop task pedig a kettot EGYUTT olvasta ki es egyben dontott beloluk:
    if (restartPending && (int32_t)(now - restartAt) >= 0)
    Ha az olvaso a jelzot mar igaznak latja, de a hataridot meg a REGI ertekevel,
    ervenytelen paron dont. A restartAt kezdoerteke 0, tehat a "now - 0 >= 0"
    gyakorlatilag mindig igaz: az eszkoz AZONNAL ujraindulna, meg mielott a 200-as
    valasz kiment volna a bongeszonek.
    OSZINTEN A SULYOSSAGROL: ESP32-C3-on ez ma NEM fordul elo. A chip egyma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
    [Arduino.h, bazsi_router_reboot.ino, main_stub.cpp, test_main.cpp]
2026-09-02 refactor: a loop() szetszedese diszpecserre es nevesitett agakra
    A loop() 362 sor volt, 38 dontesi ponttal es 6-os beagyazasi melyseggel:
    egyszerre vegzett diszpecselest, allapotgepet, LED-villogtatast es szamlalo-
    nullazast. Ez a program legkritikusabb fuggvenye - epp ennek kellene a
    legatlathatobbnak lennie.
    loop() 362 -> 46 sor. Mar csak azt mondja meg, MI
    kovetkezik; a HOGYAN mind nevesitett fuggvenyben.
    clearHealthyRunCounters() az "1 ora hibatlan futas" szamlalo-nullazas
    handleFatalMode() MODE_FATAL
    handleConfigMode() MODE_CONFIG
    runMonitorStateMachine() csak a switch, 3 sor torzs
    runTestingState()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
2026-09-02 refactor: az AP webportal kulon modulba + osszesitett lefedettsegmeres
    Az 5. lepes utolso resze. A webportal a program BIZTONSAGKRITIKUS felulete -
    ezen megy be a Wi-Fi jelszo -, ezert kapott a legszorosabb hatart.
    webportal.h/.cpp az AP beallito portal HTTP felulete (698 sor).
    A modul OSSZESEN HAROM szimbolumot exportal (nm -C igazolja):
    T startWebPortal, T stopWebPortal, T touchApDeadline
    Minden mas belso: a POST kezelo (handleConfigPost, parseConfigPost,
    commitConfigDraft), a /log oldal (sendDiagnosticLog), az urlap
    (sendConfigForm, printHtmlEscaped), a ConfigDraft tipus - es maga a
    webszerver objektum is (static AsyncWebServer server). A ConfigDraft a
    headerbe be sem kerult: a PO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
2026-09-02 docs: a dokumentacio igazitasa a modularis szerkezethez
    A MUKODES.md 16. fejezete es a README strukturalis resze meg az "egyetlen
    3950 soros .ino, 75 fuggveny, 9 reteg" allapotot irta le - az mar nem igaz.
    MUKODES.md 16. fejezet: teljesen atirva. Nyolc forditasi egyseg, ~4640 sor,
    98 fuggveny, 43% komment. Modulonkent: mit BIRTOKOL es mit EXPORTAL - ez
    utobbi a lenyeg, mert a hatart mar a linker tartja be. Kimondva, miert nem egy
    fajl, a konkret bizonyitekkal: a netprobe kiemelesekor a fordito ket
    fuggoseget jelzett, amit a kezi atvizsgalas nem vett eszre.
    README: a projekt-struktura fa a modulokkal, es egy tomor tablazat ugyanerrol.
    A telepitesi utmutato is kiegeszult: a .h/.cpp modulokat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
    [partitions_custom.csv]
2026-09-02 test: a watchdog-etetes globalis invarianssa tetele + statikus ellenorzes
    A MERNOKI ERTEKELES 4. GYENGESEGE - amit az ot lepes NEM tartalmazott.
    A fo allapotgep nem blokkolo, de a halozati muveletek percekig futhatnak
    egyetlen loop() iteracion belul. Ez csak azert biztonsagos, mert azokban a
    ciklusokban kezzel etetunk. Ezt eddig SEMMI nem kenyszeritette ki, csak a
    fegyelem - es a hiba csak az eszkozon derult volna ki.
    Eddig harom kezzel kivalasztott forgatokonyv nezte az etetesi rest. Mostantol
    MIND A 294. De ehhez eloszor magat a merest kellett helyre tenni: harom szamitott
    hiba volt benne, es mindharom CSENDBEN hazudott.
    1. Csak ETETESKOR mert. Igy csak a ket etetes KOZOTTI resek lats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
2026-09-02 ci: a firmware-build job javitasa - a sketch mappa nevenek egyeznie kell
    Az elso eles CI futas elhasalt:
    Can't open sketch: main file missing from sketch:
    .../bazsi-router-reboot/bazsi-router-reboot.ino
    Az ok: az Arduino megkoveteli, hogy a fo .ino neve EGYEZZEN a tartalmazo mappa
    nevevel. A repo mappaja "bazsi-router-reboot" (kotojellel), a sketch viszont
    "bazsi_router_reboot.ino" (alulvonassal) - az arduino-cli ezert a nem letezo
    "bazsi-router-reboot.ino"-t kereste.
    Ezt a hibat itt nem tudtam elore elkapni (nincs halozat az arduino-cli-hez), es
    a commitban ezt jeleztem is. A javitas: a forditas egy kulon, helyesen nevezett
    mappabol megy, amibe a .ino, MINDEN modul (.h/.cpp) es a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
    [tools_lint.py]
2026-09-02 test: harom tovabbi "csak a fegyelem tartja be" szabaly kikenyszeritese
    Ugyanaz a mintakereses, mint a watchdog-etetesnel: hol allit a kod vagy a doksi
    valamit, amit semmi nem tart be? Ot jelolt volt, harombol lett kapu.
    1. A KRITIKUS SZAKASZ SOSEM AGYAZODIK EGYMASBA (globalis invarians).
    A portENTER_CRITICAL az ESP32-n NEM rekurziv spinlock: masodszori belepesnel
    a task magara var, es mivel a szakasz a megszakitasokat is tiltja, meg a
    watchdog megszakitasa sem futna - az eszkoz NEMAN fagyna le.
    Merve: 280 forgatokonyv eri el az 1-es melyseget, EGY SEM a 2-est. Eddig ezt
    HAROM forgatokonyv nezte; mostantol mind a 294. Mutacioval igazolva: egy
    beagyazott zar a lastEventWa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
2026-09-02 perf: a core per-iteracios etetese ne naplozzon (2x gyorsabb tesztkeszlet)
    REGRESSZIO, AMIT EN OKOZTAM az elozo commitban. A harness mostantol a valodi
    loopTask-ot modellezi, tehat MINDEN loop() hivas elott etet - de a stub
    feedLoopWDT()-je egy simLog("wdt_feed")-et is vegez, ami egy std::string-et tol
    a g_log vektorba.
    Vannak forgatokonyvek, amik tobb millio loop() iteraciot pörgetnek (guard <
    3000000). Azok mostantol tobb millio stringet allokaltak volna feleslegesen:
    tobb szaz megabajt es percek, semmiert.
    Uj: feedLoopWDT_fromCore(). Ugyanaz a watchdog-konyveles, de nem naploz. Ket
    okbol nem:
    1. EZ NEM A SKETCH TETTE, hanem a core. A "wdt_feed" bejegyzeseket szamolo
    teszt (WDT4)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
2026-09-02 docs: tizenegy elcsuszott, duplikalt vagy ELAVULT komment javitasa
    A teljes program (mind a 4650 sor) ujraolvasasa. A talalatok tobbsege az en
    korabbi kiemeleseim maradvanya - a kod helyes volt, a magyarazata nem.
    A LEGSULYOSABB: a fomodul "KET TASK, EGY MEMORIA" blokkja azt allitotta, hogy a
    restartPending es a restartAt vedelme "volatile". Ez a 3. lepes ota NEM IGAZ:
    mindketto spinlock ala kerult, sot a sync.cpp-ben STATIC lett, tehat
    kozvetlenul mar nem is elerheto. A blokk ezzel pontosan az ELLENKEZOJET mondta
    annak, amit a kod csinal - egy jovobeli olvaso ebbol azt szurte volna le, hogy
    a par vedelme gyenge, es "megjavitotta" volna valamivel, ami mar ott van.
    Ujrairva, es a helyere is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
2026-09-02 harden: eventlog - zarolas, hatarellenorzes, es a hianyzo IDF 5.x reset okok
    A teljes program ujraolvasasabol, negy javitas az esemenynaplo modulban es egy
    pontositas a fomodulban.
    1. stuckCycleAlreadyLogged() MUX ALA KERULT.
    A naplot mux nelkul olvasta, mikozben a KOZVETLENUL FOLOTTE allo
    lastEventWas() kulon kommentben indokolja, miert zarol. Ma nincs baj belole
    (ez a fuggveny csak a setup()-bol fut, ahol a webszerver meg el sem indult),
    de ezt SEHOL nem mondta ki semmi - ket egymas melletti, ugyanazt olvaso
    fuggveny ketfele szabaly szerint. Az ar egy rovid szakasz bootolasonkent.
    2. saveEventLog(): a par EGYUTT olvasasa.
    Az evTotal a mux alatt jott, az rtcSavedEvNext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
    [bazsi_router_reboot.ino, eventlog.cpp, test_main.cpp]
2026-09-02 docs: a "nem allokal dinamikusan" allitas pontositasa
    A README, a MUKODES.md es a fomodul is azt allitotta, hogy "a sketch maga
    SEMMIT nem allokal dinamikusan". Ez tulzas volt, es epp a heap-felugyelet
    fejezeteben allt - ott, ahol a pontossag a legfontosabb.
    A SAJAT KODUNK tenyleg nem allokal (a make lint ezt mar ki is kenyszeriti), de
    harom KONYVTARI hivas, amit MI teszunk, String-et ad vissza ERTEK szerint, es
    az Arduino String mindig a heaprol dolgozik:
    http.begin(client, url) a const char*-bol ideiglenes String lesz
    http.header("Transfer-Encoding") a chunked keretezes felismerese
    WiFi.SSID() a sikeres csatlakozas kiirasa
    Rovid eletu, teszt-cik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
2026-09-03 fix: a soros uzenetek szamai a konstansokbol, CONFIG SAVED a jelmagyarazatba
    Gepi kereszt-ellenorzes a teljes firmware-en (a /test kihagyasaval):
    1. Esemenykod-kereszt-ellenorzes (kodok <-> eventName() <-> a /log
    jelmagyarazata <-> a tenylegesen naplozott param ertekek): a
    CONFIG SAVED volt az egyetlen esemeny, ami hianyzott a
    jelmagyarazatbol. Bekerult - a nevet itt is kettospont koveti, nem
    "<", hogy ne utkozzon az L2 teszt ">NEV<" mintajaval.
    2. Soros uzenetekbe beirt szamok, amik konstansokat ismeteltek meg
    kezzel - ha a konstans valtozik, az uzenet hazudni kezd. Mind az ot
    helyen a konstansbol szamoljuk (ugy, ahogy az internetFailSleep() es
    az enterFatal() mar kor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
    [bazsi_router_reboot.ino, webportal.cpp]
2026-09-03 test: veletlen allapotgep-bejaras (property-based testing)
    A meglevo 295 forgatokonyv mind KEZZEL irt: pontosan azokat az utakat jarja
    be, amikre a szerzo gondolt. Ez a nyolc uj bejaras forditva dolgozik - veletlen
    kornyezeti esemenysorozatot general (WiFi-szakadas, gombnyomas tetszoleges
    pillanatban, HTTP-valasz, heap-eses, fajlrendszer-hiba, ujraindulas), es nem
    azt allitja, hogy MI TORTENJEN, hanem hogy mi NEM TORTENHET SOHA:
    P1 a rele sosem marad behuzva a pulzusnal tovabb (a router aram nelkul)
    P2 a cycleIndex sosem lep ki a TEST_ENDPOINTS[] tablabol
    P3 resetEvents / rtcRetryRounds a sajat korlatjuk alatt
    P4 az esemenynaploban csak ervenyes esemenykod all
    P5 a nyilt szov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
    [Arduino.h, main_stub.cpp, test_main.cpp]
2026-09-03 lint: az ido-osszehasonlitas atfordulas-biztossaganak kikenyszeritese
    A millis() 32 bites, es 49,7 nap utan KORBEFORDUL. Ket helyes alak van:
    a) ELTELT-ALAK: (most - kezdet) < idotartam
    Elojel nelkuli kivonas: a kulonbseg akkor is helyes, ha a "most" mar
    korbefordult, a "kezdet" pedig meg nem.
    b) HATARIDO-ALAK: (int32_t)(most - hatarido) >= 0
    Abszolut idopont elereseshez. Az elojeles kulonbseg helyesen mondja meg,
    melyik van elorebb.
    A HIBAS alak ket abszolut idopont KOZVETLEN osszehasonlitasa - "if (most >=
    hatarido)". Ez 49,7 naponta EGYSZER hibazik, kiszamithatatlan pillanatban, es
    SEMMILYEN teszten nem latszik, ami rovidebb ideig fut. Egy folyamatosan
    uzemel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
2026-09-03 lint: a "make lint" a CI-ban EDDIG SEMMIT NEM VIZSGALT
    Ez a legsulyosabb hiba, amit ebben a munkaban talaltam - es a sajat
    eszkozomben volt, nem a programban.
    A tools_lint.py a forrasfajlokat a MUNKAKONYVTARHOZ kepest kereste. A
    "make lint" viszont a test/ konyvtarbol hivja ("python3 ../tools_lint.py"), es
    ott EGYIK forrasfajl sincs meg. A regi kod ilyenkor a
    if not p.exists():
    continue
    agon MINDEN fajlt atugrott, es "rendben"-t irt ki - nulla megvizsgalt sorral,
    kilepesi kod 0. Mind a HAROM ellenorzesre igaz volt.
    BIZONYITVA: harom szandekos hibaval a forrasban (blokkolo ciklus etetes nelkul,
    malloc, atfordulas-erzekeny idoosszehasonlitas) a "make lint" mind a harmat
    atenged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
2026-09-03 test: a stubok igazolasa a valodi konyvtarak ellen (make stubcheck)
    A TESZTELESI PIRAMIS EGYETLEN MEG NEM VIZSGALT ALAPJA. Az 1761 ellenorzes mind
    a test/stubs/ alatti modelleken keresztul lat: ha egy stub teved, a teszt ZOLD,
    az eszkoz meg hibazik - es SEMMI nem szolna.
    Mennyire eles ez? A rele a D10-en van. Ha a XIAO_ESP32C3 variansaban a D10
    szama valaha megvaltozik, a sketch tovabbra is lefordul, minden teszt zold marad
    (a teszt is a sajat konstansat hasznalja) - es az eszkoz EGY MASIK LABAT
    kapcsolgatna.
    40 ALLITAST VET OSSZE a valodi, PONTOSAN KITUZOTT konyvtarakkal
    (arduino-esp32 3.3.11, ESP-IDF release/v5.5, ESPAsyncWebServer 3.12.0):
    labkiosztas D0/D1/D3/D4/D10 a valod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
2026-09-03 fix: a naplofajl HOZZAFUZ, nem ir felul + soros LOG parancs
    A FELVETES A FELHASZNALOTOL JOTT, ES MEGALAPOZOTT VOLT. Reprodukalva:
    mentve: 32 bejegyzes, 404 bajt
    aramszunet
    elso mentes utan: 1 bejegyzes, 32 bajt
    Vagyis EPP AZ AZ ESEMENY tuntette el a tartos naplot, amiert az egyaltalan
    letezik. Az ok: az RTC_NOINIT terulet aramszunetkor torlodik, tehat a
    rtcSavedEvNext ("meddig mentettunk") is nullazodik - es a mentes a fajlt az
    RTC gyuru PILLANATNYI tartalmaval irta felul: egyetlen friss, meg idobelyeg
    nelkuli BOOT bejegyzessel.
    A HAROM FELVETESBOL KETTO VALODI HIBA VOLT:
    ures naplo felulirhat? NEM - az "evTotal == 0" kapu vedi
    egy-ket ujabb bejegyzes? IGEN, r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
    [Arduino.h, bazsi_router_reboot.ino, eventlog.cpp, eventlog.h, main_stub.cpp, test_main.cpp, webportal.cpp]
2026-09-03 fix: elveszett naplofajl mellett ne rejtsuk el az RTC bejegyzeseket
    A FELVETES ISMET A FELHASZNALOTOL JOTT: ha a lap a legfrissebb 48 sorra
    korlatozodik, mi donti el, MELYIK a legfrissebb - kulonosen idobelyeg nelkul,
    ket forrasbol?
    A VALASZ ELSO FELE: semmi. A sorrend SZERKEZETI, nem osszehasonlitason alapul.
    A fajl bejegyzesei a legregebbitol a legujabbig, kiegyenesitve allnak; az
    RTC-bol pedig csak az jon utanuk, ami a legutobbi mentes ota keletkezett - az
    definicio szerint ujabb. Ezert NTP nelkul is helyes a sorrend, es a korabbi
    "melyik a frissebb?" heurisztikara sincs szukseg.
    A KERDES VISZONT EGY VALODI RESRE MUTATOTT RA, es reprodukaltam:
    az RTC-ben 13 bejegyzes van, a lap 3-at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
    [eventlog.cpp, test_main.cpp, webportal.cpp]
2026-09-03 feat: a teljes naplo a /log lapon + mentes a heap-ujraindulas elott
    HAROM FELHASZNALOI KERDESRE VALASZ, MINDEGYIK MERESSEL.
    1. "OKOZ-E GONDOT A LOG KEZELESEBEN A HEAP- VAGY WATCHDOG-UJRAINDULAS?"
    NEM - es ezt mostantol ket teszt rogziti. Az RTC_NOINIT terulet a
    szoftveres resetet (es a watchdog resetet) TULELI, tehat a mentetlen
    bejegyzesek megmaradnak, es a kovetkezo mentes hozzafuzi oket a fajlhoz.
    Merve: RST1 (heap) es RST2 (watchdog) - egyik uton sem veszett el
    bejegyzes.
    2. "NEM LEHETNE / BIZTONSAGOS-E MENTENI A KRITIKUS HEAP MIATTI UJRAINDULAS
    ELOTT?"
    Lehet, es biztonsagos. Meg is csinaltam.
    MIERT BIZTONSAGOS? A mentes NEM a heapbol dolgozik: az osszefuzo p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
    [bazsi_router_reboot.ino, test_main.cpp, webportal.cpp]
2026-09-03 test: a flash-iras merese - mukodo internet mellett NULLA
    A kerdes az volt, mer-e a program LittleFS-elhasznalodast. NEM mer, es nem is
    tud: az esp_littlefs a torlesi ciklusszamot NEM adja vissza az Arduino API-n.
    A mount-kor kiirt sor (usedBytes/totalBytes) a HELYET mutatja, nem a kopast.
    Amit viszont MERNI lehet, az az IRASOK SZAMA. Megmertem:
    mukodo internet: 66,9 perc alatt 0 flash-iras
    halott internet: egy ujraprobalkozasi korben 10 iras
    (5 mentes x 2 iras: 4 router reset + 1 alvas elott)
    -> 33 korre, azaz 2 napra legfeljebb 330 iras
    A legfontosabb allitas az elso, mert ott telik az ido: MUKODO INTERNET MELLETT
    AZ ESZKOZ SEMMIT NEM IR A F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
    [test_main.cpp]
